Fishcanwalk/muscle-activity-analyzer/report/README.md

# รายงานโครงงาน Muscle Activity Analyzer

รายงานนี้จัดเรียงตาม [`structure.md`](structure.md) โดยแยกแต่ละข้อเป็นไฟล์ Markdown เพื่อให้อ่าน แก้ไข และนำไปจัดรูปเล่มได้ง่าย

## ขอบเขตข้อมูลที่ใช้

เนื้อหาในชุดรายงานนี้อ้างอิงจากแหล่งข้อมูลต่อไปนี้เท่านั้น

- `test-sensor/arduino/esp32_workout_firmware/`
- `test-sensor/arduino/uno_emg_fsr_link/`
- `backend/`
- `frontend/`
- `PINS.md`
- `README.md`
- `TROUBLESHOOTING.md`

## สารบัญไฟล์

### ส่วนต้น

1. [คำนำ](01-preface.md)
2. [บทคัดย่อ](02-abstract.md)
3. [สารบัญ](03-table-of-contents.md)
4. [สารบัญรูปและตาราง](04-list-of-figures-and-tables.md)

### บทที่ 1 บทนำ

1. [1.1 ที่มาและความสำคัญของปัญหา](chapter-01/chapter-01.md#11-ที่มาและความสำคัญของปัญหา)
2. [1.2 ปัญหาที่ต้องการแก้ไข](chapter-01/chapter-01.md#12-ปัญหาที่ต้องการแก้ไข)
3. [1.3 อุปกรณ์ทั้งหมดที่ใช้ในงาน](chapter-01/chapter-01.md#13-อุปกรณ์ทั้งหมดที่ใช้ในงาน)

### บทที่ 2 การออกแบบระบบ

1. [2.1 ภาพรวมสถาปัตยกรรมและองค์ประกอบของระบบ](chapter-02/chapter-02.md#21-ภาพรวมสถาปัตยกรรมและองค์ประกอบของระบบ)
2. [2.2 ลำดับขั้นตอนและการไหลของข้อมูล](chapter-02/chapter-02.md#22-ลำดับขั้นตอนและการไหลของข้อมูล)
3. [2.3 การออกแบบขั้นตอนประมวลผล](chapter-02/chapter-02.md#23-การออกแบบขั้นตอนประมวลผล)
4. [2.4 การออกแบบส่วนติดต่อผู้ใช้](chapter-02/chapter-02.md#24-การออกแบบส่วนติดต่อผู้ใช้)

### บทที่ 3 การพัฒนา

1. [3.1 ภาษา เครื่องมือ และสภาพแวดล้อมที่ใช้พัฒนา](chapter-03/chapter-03.md#31-ภาษา-เครื่องมือ-และสภาพแวดล้อมที่ใช้พัฒนา)
2. [3.2 โครงสร้างซอฟต์แวร์และหน้าที่ของส่วนประกอบหลัก](chapter-03/chapter-03.md#32-โครงสร้างซอฟต์แวร์และหน้าที่ของส่วนประกอบหลัก)
3. [3.3 การพัฒนาฟังก์ชันหลักและการเชื่อมต่อ](chapter-03/chapter-03.md#33-การพัฒนาฟังก์ชันหลักและการเชื่อมต่อระหว่างส่วนประกอบ)

### บทที่ 4 ข้อมูลจากเซนเซอร์

1. [4.1 กล้องและเซนเซอร์ที่ใช้](chapter-04/chapter-04.md#41-กล้องและเซนเซอร์ที่ใช้-ค่าที่อ่านโดยตรง-ช่วงค่า-และหน่วย)
2. [4.2 อัตราการอ่าน การปรับเทียบ และค่าที่คำนวณต่อ](chapter-04/chapter-04.md#42-อัตราการอ่าน-การปรับเทียบ-และค่าที่คำนวณต่อ)

### บทที่ 5 การจัดเก็บข้อมูลและการนำไปใช้

1. [5.1 ภาพรวมข้อมูลสด ข้อมูลที่บันทึก และความสัมพันธ์](chapter-05/chapter-05.md#51-ภาพรวมข้อมูลสด-ข้อมูลที่บันทึก-และความสัมพันธ์ของข้อมูล)
2. [5.2 Collections และฟิลด์สำคัญ](chapter-05/chapter-05.md#52-collections-และฟิลด์สำคัญ)
3. [5.3 วัตถุประสงค์ของข้อมูลและส่วนที่เรียกใช้](chapter-05/chapter-05.md#53-เก็บข้อมูลแต่ละประเภทเพื่อใช้ทำอะไร-และส่วนใดของระบบเรียกใช้จริง)
4. [5.4 ตัวอย่างเอกสาร ดัชนี การค้นคืน และอายุข้อมูล](chapter-05/chapter-05.md#54-ตัวอย่างเอกสาร-ดัชนี-การค้นคืน-และอายุข้อมูล)

### บทที่ 6 โครงสร้างและการทำงานของโค้ด

1. [6.1 แผนผัง codebase](chapter-06/chapter-06.md#61-แผนผัง-codebase-และหน้าที่ของเฟิร์มแวร์-เว็บ-และ-api)
2. [6.2 Arduino Uno](chapter-06/chapter-06.md#62-arduino-uno-timer1-adc-interrupt-watchdog-และ-uart)
3. [6.3 ESP32](chapter-06/chapter-06.md#63-esp32-freertos-hardware-timer-gpio-interrupt-watchdog-i2c-และการส่งข้อมูล)
4. [6.4 เว็บและเซิร์ฟเวอร์](chapter-06/chapter-06.md#64-เว็บและเซิร์ฟเวอร์-รับ-telemetry-กระจาย-sse-เริ่มหยุดบันทึก-ส่งต่อ-fastapi-และเก็บ-mongodb)
5. [6.5 เส้นทางข้อมูลแบบครบวงจรและตัวอย่างโค้ด](chapter-06/chapter-06.md#65-เส้นทางข้อมูลแบบครบวงจรและตัวอย่างโค้ดสำคัญ)

### บทที่ 7 การทดสอบและผลลัพธ์

1. [7.1 วัตถุประสงค์ วิธีการ และสภาพแวดล้อม](chapter-07/chapter-07.md#71-วัตถุประสงค์-วิธีการ-และสภาพแวดล้อมการทดสอบ)
2. [7.2 กรณีทดสอบและเกณฑ์ประเมินผล](chapter-07/chapter-07.md#72-กรณีทดสอบและเกณฑ์ประเมินผล)
3. [7.3 ผลการทดสอบและตัวอย่างผลลัพธ์](chapter-07/chapter-07.md#73-ผลการทดสอบและตัวอย่างผลลัพธ์)
4. [7.4 การวิเคราะห์ผลและข้อจำกัด](chapter-07/chapter-07.md#74-การวิเคราะห์ผลและข้อจำกัดที่พบ)

### บทที่ 8 ปัญหาที่พบและวิธีแก้ไข

1. [8.1 ปัญหาที่พบ](chapter-08/chapter-08.md#81-ปัญหาที่พบระหว่างการพัฒนาและการทดสอบ)
2. [8.2 สาเหตุและผลกระทบ](chapter-08/chapter-08.md#82-สาเหตุและผลกระทบของแต่ละปัญหา)
3. [8.3 วิธีแก้ไขและเหตุผล](chapter-08/chapter-08.md#83-วิธีที่ใช้แก้ไขและเหตุผลที่เลือกวิธีนั้น)
4. [8.4 ผลหลังแก้ไขและปัญหาที่ยังเหลือ](chapter-08/chapter-08.md#84-ผลหลังแก้ไขและปัญหาที่ยังเหลืออยู่)

### บทที่ 9 สรุปและแนวทางพัฒนา

1. [9.1 สรุปสิ่งที่พัฒนาและผลที่ได้](chapter-09/chapter-09.md#91-สรุปสิ่งที่พัฒนาและผลที่ได้เทียบกับวัตถุประสงค์)
2. [9.2 ข้อจำกัดของโครงงาน](chapter-09/chapter-09.md#92-ข้อจำกัดของโครงงาน)
3. [9.3 แนวทางพัฒนาต่อ](chapter-09/chapter-09.md#93-แนวทางพัฒนาต่อ)

### ส่วนท้าย

1. [เอกสารอ้างอิง](references.md)
2. [ภาคผนวก](appendix.md)

## Flowchart

แผนภาพ Mermaid สำหรับนำไปแคปภาพใส่รายงานอยู่ที่ [`flowchart.md`](flowchart.md) และมีจุดอ้างอิงในข้อ 2.2, 6.2, 6.3 และ 6.5

แผนภาพฐานข้อมูล (ER Diagram) ของ MongoDB collections อยู่ที่ [`db-diagram.md`](db-diagram.md) มีจุดอ้างอิงในข้อ 5.1 และ 5.2

## เอกสารอธิบายโค้ดรวม

คำอธิบาย firmware ทั้งสองไฟล์แบบรวมอยู่ที่ [`code-explanation.md`](code-explanation.md)
