Fishcanwalk/muscle-activity-analyzer/report/structure.md

# โครงสร้างรายงานพัฒนาซอฟต์แวร์

รายงานโครงงาน `muscle-activity-analyzer` ควรเรียงหัวข้อตามลำดับต่อไปนี้ โดยเติมรายละเอียดจากการพัฒนาและผลการทดสอบจริงในแต่ละส่วน

## ส่วนต้น

1. **คำนำ** — จุดประสงค์ของรายงานและภาพรวมเนื้อหา
2. **บทคัดย่อ** — ปัญหา วัตถุประสงค์ วิธีดำเนินงาน และผลลัพธ์โดยสรุป
3. **สารบัญ** — หัวข้อและเลขหน้า
4. **สารบัญรูปและตาราง** — หมายเลข ชื่อ และเลขหน้าของภาพกับตารางในรายงาน

## บทที่ 1 บทนำ

1.1 ที่มาและความสำคัญของปัญหา
1.2 ปัญหาที่ต้องการแก้ไข
1.3 อุปกรณ์ทั้งหมดที่ใช้ในงาน (Hardware, Software, Library)

## บทที่ 2 การออกแบบระบบ

2.1 ภาพรวมสถาปัตยกรรมและองค์ประกอบของระบบ
2.2 ลำดับขั้นตอนและการไหลของข้อมูล
2.3 การออกแบบขั้นตอนประมวลผล
2.4 การออกแบบส่วนติดต่อผู้ใช้

## บทที่ 3 การพัฒนา

3.1 ภาษา เครื่องมือ และสภาพแวดล้อมที่ใช้พัฒนา
3.2 โครงสร้างซอฟต์แวร์และหน้าที่ของส่วนประกอบหลัก
3.3 การพัฒนาฟังก์ชันหลักและการเชื่อมต่อระหว่างส่วนประกอบ

## บทที่ 4 ข้อมูลจากเซนเซอร์

4.1 กล้องและเซนเซอร์ที่ใช้: ค่าที่อ่านโดยตรง ช่วงค่า และหน่วย
4.2 อัตราการอ่าน การปรับเทียบ และค่าที่คำนวณต่อ

## บทที่ 5 การจัดเก็บข้อมูลและการนำไปใช้

5.1 ภาพรวมข้อมูลสด ข้อมูลที่บันทึก และความสัมพันธ์ของข้อมูล
5.2 Collections และฟิลด์สำคัญ
5.3 เก็บข้อมูลแต่ละประเภทเพื่อใช้ทำอะไร และส่วนใดของระบบเรียกใช้จริง
5.4 ตัวอย่างเอกสาร ดัชนี การค้นคืน และอายุข้อมูล

## บทที่ 6 โครงสร้างและการทำงานของโค้ด

6.1 แผนผัง codebase และหน้าที่ของเฟิร์มแวร์ เว็บ และ API
6.2 Arduino Uno: Timer1, ADC Interrupt, Wทที่ 3 การพัฒนา
3.1 ภาษา เครื่องมือ และสภาพแวดล้อมที่ใช้พัฒนา
3.2 โครงสร้างซอฟต์แวร์และหน้าที่ของส่วนประกอบหลัก
3.3 การพัฒนาฟังก์ชันหลักและการเชื่อมต่อระหว่างส่วนประกอบatchdog และ UART
6.3 ESP32: FreeRTOS, Hardware Timer, GPIO Interrupt, Watchdog, I2C และการส่งข้อมูล
6.4 เว็บและเซิร์ฟเวอร์: รับ telemetry, กระจายผ่าน WebSocket และ SSE, เริ่ม/หยุดบันทึก, ส่งต่อ FastAPI และเก็บ MongoDB
6.5 เส้นทางข้อมูลแบบครบวงจรและตัวอย่างโค้ดสำคัญ

## บทที่ 7 การทดสอบและผลลัพธ์

7.1 วัตถุประสงค์ วิธีการ และสภาพแวดล้อมการทดสอบ
7.2 กรณีทดสอบและเกณฑ์ประเมินผล
7.3 ผลการทดสอบและตัวอย่างผลลัพธ์
7.4 การวิเคราะห์ผลและข้อจำกัดที่พบ

## บทที่ 8 ปัญหาที่พบและวิธีแก้ไข

8.1 ปัญหาที่พบระหว่างการพัฒนาและการทดสอบ
8.2 สาเหตุและผลกระทบของแต่ละปัญหา
8.3 วิธีที่ใช้แก้ไขและเหตุผลที่เลือกวิธีนั้น
8.4 ผลหลังแก้ไขและปัญหาที่ยังเหลืออยู่

## บทที่ 9 สรุปและแนวทางพัฒนา

9.1 สรุปสิ่งที่พัฒนาและผลที่ได้เทียบกับวัตถุประสงค์
9.2 ข้อจำกัดของโครงงาน
9.3 แนวทางพัฒนาต่อ

## ส่วนท้าย

1. **เอกสารอ้างอิง** — แหล่งข้อมูล แนวคิด เครื่องมือ และงานที่อ้างถึงในรายงาน
2. **ภาคผนวก** — รายละเอียดเสริม เช่น คู่มือใช้งาน ตัวอย่างข้อมูล หรือผลการทดสอบเพิ่มเติม
