Fishcanwalk/muscle-activity-analyzer/report/04-list-of-figures-and-tables.md

# สารบัญรูปและตาราง

รายการนี้เป็นรายการตั้งต้นสำหรับการจัดรูปเล่มจริง เลขหน้าและหมายเลขรูปให้เติมหลังจากนำ Mermaid ไปสร้างภาพและรวมเอกสารแล้ว

## รูปที่ควรมี

| รายการ | ชื่อรูป | แหล่งข้อมูล | จุดแทรกแนะนำ |
|---|---|---|---|
| รูปที่ 1 | การไหลของข้อมูลจาก Uno ถึง MongoDB | `report/flowchart.md` Flowchart 1 | ข้อ 2.2 |
| รูปที่ 2 | รอบการอ่าน ADC ของ Arduino Uno | `report/flowchart.md` Flowchart 2 | ข้อ 6.2 |
| รูปที่ 3 | งานและการเชื่อมต่อของ ESP32 | `report/flowchart.md` Flowchart 3 | ข้อ 6.3 |
| รูปที่ 4 | หน้าจอแดชบอร์ดและสถานะเซนเซอร์ | `frontend/src/lib/components/workout/` | ข้อ 2.4 |

## ตารางที่ควรมี

| รายการ | ชื่อตาราง | จุดแทรกแนะนำ |
|---|---|---|
| ตารางที่ 1 | การกำหนดขาและอุปกรณ์ | ข้อ 4.1 |
| ตารางที่ 2 | สูตรคำนวณค่าเซนเซอร์ต่อ (EMG, FSR, MPU, HR, SpO2, อุณหภูมิ) | ข้อ 4.2 |
| ตารางที่ 3 | Collections และดัชนี MongoDB | ข้อ 5.2 และ 5.4 |
| ตารางที่ 4 | กรณีทดสอบระบบ | ข้อ 7.2 |
| ตารางที่ 5 | รายการอุปกรณ์และวัสดุ | ข้อ 3.1 |
