Fishcanwalk/muscle-activity-analyzer/report/chapter-06/chapter-06.md

# บทที่ 6 โครงสร้างและการทำงานของโค้ด

## 6.1 แผนผัง codebase และหน้าที่ของเฟิร์มแวร์ เว็บ และ API

```text
test-sensor/arduino/
├── uno_emg_fsr_link/              # Uno: ADC + Timer1 + UART
└── esp32_workout_firmware/        # ESP32: FreeRTOS + I2C + Wi-Fi + HTTP + WebSocket

frontend/
├── server.js                      # entry point ตอน production ต่อ WebSocket เข้ากับ SvelteKit
├── emg-ws.js                      # WebSocket server ของ EMG ที่ /ws/emg
└── src/
    ├── routes/api/                # endpoint รับ telemetry, SSE, recording, calibration
    ├── lib/server/telemetryStore.ts  # สถานะสด การแปลงค่า EMG และการส่งต่อ backend
    └── lib/workout/               # state ของ workout, telemetry, camera, recording

backend/app/
├── routers/                       # auth, telemetry, sessions, calibration, users
├── models/                        # schema ข้อมูล
├── db.py                          # MongoDB และ index
└── security.py                    # JWT และ password
```

ผังนี้เป็นสรุปหน้าที่ของส่วนประกอบหลัก ไม่ได้รวมไฟล์ที่อยู่นอกขอบเขตแหล่งข้อมูลของรายงาน

telemetry ที่ส่งต่อกันในผังนี้มีโครงสร้างหลักเป็นกลุ่ม `emg`, `fsr`, `mpu`, `vitals`, `device`, `timestamp` และอาจมี `buttons` โดย backend schema อนุญาตฟิลด์เพิ่มเติมเพื่อให้รองรับข้อมูลจากอุปกรณ์ได้ยืดหยุ่น ค่า EMG ดิบจากบอร์ดส่งแยกมาทาง WebSocket ส่วนกลุ่มอื่นส่งทาง HTTP POST แล้วเว็บเซิร์ฟเวอร์รวมกลับเป็น telemetry ก้อนเดียวก่อนส่งต่อ backend

## 6.2 Arduino Uno: Timer1, ADC Interrupt, Watchdog และ UART

### 6.2.1 ภาพรวมการทำงาน

**การจับเวลารอบ sampling:** ใช้ Timer1 ในโหมด CTC โดยตั้ง prescaler 64 และค่า OCR1A ให้เกิด interrupt ที่ความถี่ 100 Hz หรือทุก 10 ms ทุกครั้งที่เกิด `TIMER1_COMPA_vect` ระบบจะตั้งบิต 0 ของตัวแปร `eventFlags` เพื่อให้ loop เริ่มรอบอ่านข้อมูลใหม่ ทำให้รอบ sampling สม่ำเสมอ

**การอ่านค่า ADC ด้วย interrupt:** ในแต่ละรอบ Uno อ่านค่า 2 ช่อง คือ EMG ที่ขา A0 และ FSR ที่ขา A1 โดยสั่งให้ ADC เริ่มแปลงค่าแล้วไม่ต้องรอ เมื่อแปลงค่าเสร็จ ADC จะเรียก interrupt ให้เก็บค่าไว้ แล้วเริ่มอ่านช่องถัดไปต่อทันที เมื่ออ่านครบทั้ง 2 ช่อง โปรแกรมหลักจะนำค่าไปใช้ ส่วนค่า FSR ต้องกลับด้านก่อน เพราะเซนเซอร์ให้ค่าสูงตอนไม่มีแรงกด

**การประหยัดพลังงาน:** ช่วงที่รอ Timer1 หรือรอ ADC แปลงค่า CPU ไม่มีงานต้องทำ ระบบจึงให้ CPU พักด้วย `SLEEP_MODE_IDLE` และเมื่อเกิด interrupt จาก Timer1 หรือ ADC CPU จะตื่นขึ้นมาทำงานต่อ

**การป้องกันระบบค้าง:** ใช้ Watchdog Timer ของ Uno โดยตั้ง timeout ไว้ 2 วินาทีผ่านฟังก์ชันที่เขียนขึ้นเองระดับ register (`WDT__enable()`) ซึ่งให้ผลเหมือนฟังก์ชันสำเร็จรูปของไลบรารี AVR และเรียก `wdt_reset()` ทุกครั้งที่อ่านข้อมูลครบหนึ่งรอบ หากรอบการอ่านค้างนานเกิน 2 วินาที ระบบจะรีสตาร์ทบอร์ดโดยอัตโนมัติ

**การส่งข้อมูลไปยัง ESP32:** แปลงค่า ADC 10-bit (0-1023) เป็นช่วง 0-4095 ด้วย `map()` ให้ตรงกับช่วงค่าที่ ESP32 และ backend ใช้ แล้วส่งผ่าน `Serial` ที่ขา 0/1 ด้วยความเร็ว 9600 baud ในรูปแบบ `emg,fsr` บรรทัดละหนึ่งรอบ

### 6.2.2 โค้ดและการทำงานของโค้ด

โค้ดในหัวข้อนี้ยกมาจากไฟล์ `test-sensor/arduino/uno_emg_fsr_link/uno_emg_fsr_link.ino` โดยตรง บรรทัดที่ละไว้แสดงด้วย `// ...`

ATmega328P บน Arduino Uno มี RAM เพียง 2 KB ไม่พอสำหรับรัน FreeRTOS แบบฝั่ง ESP32 เฟิร์มแวร์ของ Uno จึงใช้กลไกของชิป AVR โดยตรงแทน แต่ยังคงใช้แนวคิดเดียวกัน คือใช้ hardware timer กำหนดจังหวะ ใช้ interrupt แทนการวนรอ ใช้ watchdog ป้องกันระบบค้าง และให้ CPU พักระหว่างรอ

#### 6.2.2.1 การเริ่มต้นระบบใน `setup()`

เมื่อเปิดเครื่อง `setup()` จะเตรียมส่วนต่าง ๆ ตามลำดับ โดยจัดการ watchdog ก่อน แล้วเปิดช่องทางส่งข้อมูล ตั้งค่า timer และ ADC จากนั้นเลือกโหมดพัก และเปิด watchdog เป็นขั้นสุดท้าย

```cpp
void setup() {
  MCUSR = 0;
  wdt_disable();

  Serial.begin(9600);
  setupSampleTimer();
  ADMUX = (1 << REFS0) | ADC_CHANNEL_EMG;
  ADCSRA = (1 << ADEN) | (1 << ADIE) | (1 << ADPS2) | (1 << ADPS1) | (1 << ADPS0);
  DIDR0 |= (1 << ADC0D) | (1 << ADC1D);

  set_sleep_mode(SLEEP_MODE_IDLE);

  WDT__enable(wdt_timeout_2sec);
}
```

ดูโค้ดต้นฉบับ: [`uno_emg_fsr_link.ino` บรรทัด 68–81](https://github.com/Fishcanwalk/muscle-activity-analyzer/blob/main/test-sensor/arduino/uno_emg_fsr_link/uno_emg_fsr_link.ino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)

ขั้นแรกระบบปิด watchdog ไว้ก่อนชั่วคราว เหตุผลอธิบายไว้ในหัวข้อ 6.2.2.5 ต่อมาจึงเปิด `Serial` ที่ความเร็ว 9600 baud เพื่อใช้ส่งข้อมูลไปยัง ESP32 แล้วตั้งค่า Timer1 (หัวข้อ 6.2.2.2) จากนั้นตั้งค่า ADC ต่อทันทีในบรรทัดถัดมา (หัวข้อ 6.2.2.3) โดยไม่ได้แยกเป็นฟังก์ชันต่างหาก ไฟล์นี้ไม่ได้รวม `board_config.h` เหมือนก่อนหน้านี้อีกต่อไป จึงไม่มีการเรียก `setupBoardAdc()` และประกาศ `ADC_MAX_VAL` (10-bit, ค่า 1023) ไว้เองในไฟล์แทนการดึงจากเฮดเดอร์ที่ใช้ร่วมกับบอร์ดอื่น

หลังจากนั้นระบบเลือกโหมดพักของ CPU ไว้ล่วงหน้า (หัวข้อ 6.2.2.4) และเปิด watchdog เป็นขั้นสุดท้าย เพราะเมื่อเปิดแล้วระบบต้องเริ่มรีเซ็ต watchdog เป็นระยะ ถ้าเปิดไว้ตั้งแต่ต้น ช่วงที่ยังตั้งค่าไม่เสร็จอาจทำให้บอร์ดถูกรีสตาร์ทโดยไม่จำเป็น

#### 6.2.2.2 การจับเวลารอบ sampling ด้วย Timer1

Uno ต้องอ่านค่าเซนเซอร์ให้ตรงทุก 10 ms (100 Hz) เท่ากับฝั่ง ESP32 ถ้าใช้ `delay()` หรือคอยเทียบเวลาจาก `millis()` CPU จะต้องตื่นอยู่ตลอดและรอบจะคลาดตามเวลาที่ใช้ทำงานในแต่ละรอบ ระบบจึงใช้ Timer1 ซึ่งเป็นวงจรนับเวลาในชิป และนับต่อไปได้เองแม้ CPU จะพักอยู่

```cpp
#define TIMER1_OCR1A_VALUE ((F_CPU / 64UL / SAMPLE_RATE_HZ) - 1)

void setupSampleTimer() {
  cli();
  TCCR1A = 0;
  TCCR1B = 0;
  TCNT1 = 0;
  OCR1A = TIMER1_OCR1A_VALUE;
  TCCR1B |= (1 << WGM12);
  TCCR1B |= (1 << CS11) | (1 << CS10);
  TIMSK1 |= (1 << OCIE1A);
  sei();
}

ISR(TIMER1_COMPA_vect) {
  eventFlags |= (1 << 0);
}
```

ดูโค้ดต้นฉบับ: [`uno_emg_fsr_link.ino` บรรทัด 18–34](https://github.com/Fishcanwalk/muscle-activity-analyzer/blob/main/test-sensor/arduino/uno_emg_fsr_link/uno_emg_fsr_link.ino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)

ชิปทำงานที่ 16 MHz ซึ่งเร็วเกินกว่าจะนำมานับตรง ๆ จึงหารความถี่ด้วย 64 (prescaler) ก่อน timer จึงนับขึ้นหนึ่งครั้งทุก 4 µs เมื่อนับครบ 2,500 ครั้งก็จะได้ 10 ms พอดี ค่าที่ตั้งไว้คือ 2,499 เพราะ timer เริ่มนับจาก 0

timer ทำงานในโหมด CTC เมื่อนับถึงค่าที่ตั้งไว้ จะเกิด interrupt แล้วกลับไปเริ่มนับจาก 0 ใหม่เองทันที รอบถัดไปจึงเริ่มตรงเวลาเสมอ โดยไม่ต้องมีโปรแกรมมาตั้งค่าใหม่ ระหว่างตั้งค่า timer ระบบปิด interrupt ไว้ชั่วคราว (`cli()` / `sei()`) เพื่อไม่ให้ interrupt เกิดขึ้นขณะที่ตั้งค่ายังไม่ครบ

เมื่อเกิด interrupt ฟังก์ชันที่รับ interrupt ทำเพียงอย่างเดียว คือ "ยกธง" บอกโปรแกรมหลักว่าถึงรอบแล้ว ส่วนงานอ่านค่าจริงจะทำใน `loop()` เพราะงานใน interrupt ต้องสั้นที่สุด ธงที่ใช้สื่อสารระหว่าง interrupt กับโปรแกรมหลักเก็บรวมไว้ในตัวแปรเดียว แต่ละบิตแทนเหตุการณ์หนึ่งอย่าง

```cpp
volatile uint8_t eventFlags = 0;
```

ดูโค้ดต้นฉบับ: [`uno_emg_fsr_link.ino` บรรทัด 6](https://github.com/Fishcanwalk/muscle-activity-analyzer/blob/main/test-sensor/arduino/uno_emg_fsr_link/uno_emg_fsr_link.ino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)

โค้ดนี้ไม่ได้ตั้งชื่อบิตแต่ละตัวไว้เป็นค่าคงที่ แต่ใช้ตัวเลขบิตตรง ๆ คือ บิต 0 (`1 << 0`) หมายถึง timer ครบรอบ บิต 1 (`1 << 1`) หมายถึง EMG แปลงค่าเสร็จ และบิต 2 (`1 << 2`) หมายถึง FSR แปลงค่าเสร็จ interrupt เป็นฝ่ายยกธงด้วยการ OR บิตที่เกี่ยวข้องเข้าไปในตัวแปร และ `loop()` เป็นฝ่ายเอาธงลงด้วยการ AND กับส่วนกลับบิตนั้นเมื่อจัดการเหตุการณ์นั้นเสร็จแล้ว ตัวแปรนี้ประกาศเป็น `volatile` เพื่อบอกคอมไพเลอร์ว่าค่าอาจถูกเปลี่ยนจาก interrupt ได้ทุกเมื่อ โปรแกรมจึงต้องอ่านค่าจริงจากหน่วยความจำทุกครั้ง ไม่ใช้ค่าเก่าที่จำไว้

#### 6.2.2.3 การอ่านค่า ADC ด้วย Interrupt

ถ้าใช้ `analogRead()` CPU ต้องรอ ADC แปลงค่าจนเสร็จ ซึ่งใช้เวลาประมาณ 104 µs ต่อช่อง โดยตลอดเวลานั้น CPU ต้องตื่นอยู่และทำอย่างอื่นไม่ได้ ระบบจึงใช้วิธีสั่งให้ ADC เริ่มแปลงค่าแล้วปล่อยไว้ เมื่อแปลงเสร็จ ADC จะแจ้งกลับมาเองด้วย interrupt

```cpp
ADMUX = (1 << REFS0) | ADC_CHANNEL_EMG;
ADCSRA = (1 << ADEN) | (1 << ADIE) | (1 << ADPS2) | (1 << ADPS1) | (1 << ADPS0);
DIDR0 |= (1 << ADC0D) | (1 << ADC1D);
```

ดูโค้ดต้นฉบับ: [`uno_emg_fsr_link.ino` บรรทัด 74–76](https://github.com/Fishcanwalk/muscle-activity-analyzer/blob/main/test-sensor/arduino/uno_emg_fsr_link/uno_emg_fsr_link.ino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)

```cpp
ISR(ADC_vect) {
  int value = ADC;
  if (currentAdcChannel == ADC_CHANNEL_EMG) {
    emgRawIsr = value;
    eventFlags |= (1 << 1);
    currentAdcChannel = ADC_CHANNEL_FSR;
    ADMUX = (ADMUX & 0xF0) | (ADC_CHANNEL_FSR & 0x0F);
    ADCSRA |= (1 << ADSC);
  } else {
    fsrRawIsr = value;
    eventFlags |= (1 << 2);
  }
}
```

ดูโค้ดต้นฉบับ: [`uno_emg_fsr_link.ino` บรรทัด 37–49](https://github.com/Fishcanwalk/muscle-activity-analyzer/blob/main/test-sensor/arduino/uno_emg_fsr_link/uno_emg_fsr_link.ino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)

- ตอนตั้งค่า ADC ระบบใช้แรงดัน 5 V ของบอร์ดเป็นแรงดันอ้างอิง ค่าที่อ่านได้จึงอยู่ในช่วง 0–1023 ตามแรงดัน 0–5 V และเปิดให้ ADC แจ้ง interrupt เมื่อแปลงค่าเสร็จ ส่วนสัญญาณนาฬิกาของ ADC ลดลงเหลือประมาณ 125 kHz ซึ่งอยู่ในช่วงที่ ADC แปลงค่าได้แม่นยำ
- ขา A0 และ A1 ใช้อ่านสัญญาณแอนะล็อกเท่านั้น ระบบจึงปิดวงจรอ่านค่าดิจิทัลของสองขานี้ไว้ เพื่อลดสัญญาณรบกวนและลดการใช้ไฟ
- ADC มีตัวเดียว แต่ต้องอ่าน 2 ช่อง ระบบจึงอ่านต่อกันเป็นทอด ๆ เริ่มจาก EMG ที่ขา A0 เมื่อแปลงเสร็จ interrupt จะเก็บค่าไว้ ยกธงบิต 1 ว่า EMG พร้อมแล้ว แล้วเปลี่ยนช่องที่จะอ่านเป็น FSR ด้วยการเขียน `ADMUX` ใหม่ และสั่งเริ่มแปลงค่าอีกครั้งด้วยการตั้งบิต `ADSC` ตรง ๆ ในบรรทัดถัดมา เมื่อ FSR แปลงเสร็จก็จะยกธงบิต 2 ว่า FSR พร้อมแล้ว ธงนี้หมายความว่าได้ค่าครบทั้งสองช่องของรอบนั้นแล้ว
- interrupt ต้องรู้ว่าค่าที่เพิ่งแปลงเสร็จเป็นของช่องใด ระบบจึงจดช่องที่กำลังอ่านไว้ในตัวแปร `currentAdcChannel` ทุกครั้งที่เปลี่ยนช่อง
- โค้ดนี้ไม่มีฟังก์ชันช่วยรวมการตั้งช่องกับการสั่งเริ่มแปลงค่าไว้ด้วยกัน (เช่น `startAdcConversion()`) การเขียน `currentAdcChannel`, `ADMUX` และบิต `ADSC` จึงเกิดขึ้นตรง ๆ ทั้งใน ISR นี้ และใน `loop()` (หัวข้อ 6.2.2.4) แยกกันคนละที่ ทำให้เห็นการเข้าถึง register ระดับล่างชัดเจนขึ้น แต่ต้องเขียนโค้ดชุดเดียวกันซ้ำสองจุด

#### 6.2.2.4 รอบการทำงานใน `loop()` และการประหยัดพลังงาน

`loop()` เป็นตัวกำหนดลำดับงานในแต่ละรอบ ช่วงที่ต้องรอ timer หรือรอ ADC แปลงค่า CPU จะพักอยู่ตลอด และตื่นขึ้นมาเฉพาะเมื่อมีงานต้องทำ

```cpp
void loop() {
  sleep_mode();

  if (!(eventFlags & (1 << 0))) return;
  eventFlags &= ~(1 << 0);

  currentAdcChannel = ADC_CHANNEL_EMG;
  ADMUX = (ADMUX & 0xF0) | (ADC_CHANNEL_EMG & 0x0F);
  ADCSRA |= (1 << ADSC);

  while (!(eventFlags & (1 << 2))) sleep_mode();
  eventFlags &= ~((1 << 1) | (1 << 2));

  cli();
  int emgRaw = emgRawIsr;
  int fsrRaw = fsrRawIsr;
  sei();
  // ...
}
```

ดูโค้ดต้นฉบับ: [`uno_emg_fsr_link.ino` บรรทัด 83–99](https://github.com/Fishcanwalk/muscle-activity-analyzer/blob/main/test-sensor/arduino/uno_emg_fsr_link/uno_emg_fsr_link.ino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)

1. ต้นรอบ CPU จะพักจนกว่าจะมี interrupt ใดก็ตามเกิดขึ้น
2. เมื่อตื่นขึ้น โปรแกรมจะตรวจก่อนว่าบิตของ timer (บิต 0) ถูกยกหรือไม่ เพราะ interrupt อื่นก็ปลุก CPU ได้เช่นกัน ถ้ายังไม่ถึงรอบก็กลับไปพักต่อ ถ้าถึงรอบแล้วจึงเอาบิตลงและเริ่มทำงาน
3. โปรแกรมตั้งช่อง ADC เป็น EMG และสั่งเริ่มแปลงค่าเองตรง ๆ (เขียน `currentAdcChannel`, `ADMUX` และบิต `ADSC`) แล้วพักรอต่อ ระหว่างนั้น interrupt ของ ADC จะอ่าน EMG แล้วต่อด้วย FSR เอง (หัวข้อ 6.2.2.3) CPU จะตื่นขึ้นมาตรวจทุกครั้งที่มี interrupt จนกว่าจะเห็นบิต FSR (บิต 2) พร้อมแล้ว
4. เมื่อได้ค่าครบ โปรแกรมคัดลอกค่าจากตัวแปรที่ interrupt เขียนไว้มาใช้ ระหว่างคัดลอกจะปิด interrupt ไว้ชั่วครู่ เพราะ Uno เป็นชิป 8 บิต การอ่านค่า 16 บิตต้องทำเป็น 2 ครั้ง ถ้า interrupt แทรกเข้ามาเปลี่ยนค่าระหว่างสองครั้งนั้น ค่าที่ได้จะผิด

โหมดพักที่เลือกไว้ใน `setup()` คือ `SLEEP_MODE_IDLE` ซึ่งเป็นโหมดที่ตื้นที่สุด โหมดนี้หยุดเฉพาะ CPU แต่ Timer1, ADC และ Serial ยังทำงานต่อได้และปลุก CPU ได้ ระบบไม่เลือกโหมดที่ลึกกว่านี้ เพราะโหมดเหล่านั้นจะหยุด timer และ ADC ซึ่งเฟิร์มแวร์ต้องใช้ ข้อดีอีกข้อของการพักขณะ ADC แปลงค่าคือสัญญาณรบกวนจากวงจรดิจิทัลลดลง ค่าที่อ่านได้จึงนิ่งขึ้น

#### 6.2.2.5 การป้องกันระบบค้างด้วย Watchdog Timer

watchdog ของ Uno ทำงานแบบเดียวกับฝั่ง ESP32 คือเป็นตัวจับเวลาที่โปรแกรมต้องรีเซ็ตเป็นระยะ ถ้าไม่ถูกรีเซ็ตจนหมดเวลา แสดงว่าโปรแกรมค้าง ชิปจะรีสตาร์ทตัวเอง

```cpp
MCUSR = 0;
wdt_disable();
// ...
WDT__enable(wdt_timeout_2sec);
```

ดูโค้ดต้นฉบับ: [`uno_emg_fsr_link.ino` บรรทัด 69–70, 80](https://github.com/Fishcanwalk/muscle-activity-analyzer/blob/main/test-sensor/arduino/uno_emg_fsr_link/uno_emg_fsr_link.ino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)

ต้น `setup()` ระบบล้างบันทึกสาเหตุการรีเซ็ตครั้งก่อน และปิด watchdog ไว้ก่อน เพราะถ้าบอร์ดเพิ่งถูกรีสตาร์ทจาก watchdog ชิปจะยังจำสถานะนั้นไว้ และ bootloader รุ่นเก่าบางรุ่นไม่ได้ล้างสถานะนี้ให้ ถ้าไม่จัดการเอง watchdog อาจทำงานต่อระหว่างที่บอร์ดกำลังเริ่มระบบ และรีสตาร์ทบอร์ดวนซ้ำไม่จบ

ต่างจากฝั่ง ESP32 ที่เรียกใช้ watchdog ผ่านฟังก์ชันสำเร็จรูปของไลบรารี โค้ดฝั่ง Uno เขียนฟังก์ชันเปิด watchdog เองชื่อ `WDT__enable()` ซึ่งเขียนค่าลง register ของชิปโดยตรง แทนการเรียก `wdt_enable(WDTO_2S)` ของไลบรารี AVR

```cpp
#define wdt_timeout_2sec 7

void WDT__enable(uint8_t timeout_v) {
  unsigned char bakSREG;
  uint8_t prescaler;
  prescaler = timeout_v & 0x07;
  prescaler |= (1 << WDE);
  if (timeout_v > 7) {
    prescaler |= (1 << WDP3);
  }
  bakSREG = SREG;
  cli();
  wdt_reset();
  WDTCSR |= ((1 << WDCE) | (1 << WDE));
  WDTCSR = prescaler;
  SREG = bakSREG;
}
```

ดูโค้ดต้นฉบับ: [`uno_emg_fsr_link.ino` บรรทัด 17, 52–66](https://github.com/Fishcanwalk/muscle-activity-analyzer/blob/main/test-sensor/arduino/uno_emg_fsr_link/uno_emg_fsr_link.ino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)

1. คำนวณค่า prescaler จากค่าที่ส่งเข้ามา (`timeout_v & 0x07`) แล้วตั้งบิต `WDE` (Watchdog Enable) เพิ่มเข้าไป ถ้าค่าที่ส่งมากกว่า 7 จะตั้งบิต `WDP3` เพิ่มด้วย สำหรับ timeout ที่นานกว่า 2 วินาที ค่าคงที่ `wdt_timeout_2sec` ที่ประกาศไว้เท่ากับ 7 ซึ่งตรงกับค่า `WDTO_2S` ของไลบรารี AVR พอดี ผลลัพธ์คือ timeout 2 วินาทีเท่าเดิม
2. เก็บค่า `SREG` (สถานะ interrupt) ไว้ก่อน แล้วปิด interrupt ชั่วคราวด้วย `cli()` เพราะการตั้งค่า watchdog ต้องทำติดกันโดยไม่ให้ interrupt แทรก
3. รีเซ็ต watchdog หนึ่งครั้งก่อนตั้งค่าใหม่ เพื่อไม่ให้ timeout เดิมหมดเวลาพอดีตอนกำลังตั้งค่า
4. เขียน `WDTCSR` สองครั้งตามลำดับที่ชิป AVR กำหนด ครั้งแรกตั้งบิต `WDCE` และ `WDE` เพื่อปลดล็อกการเปลี่ยนค่า (ชิปกำหนดว่าไบต์นี้ต้องเขียนสองครั้งภายใน 4 clock cycle มิฉะนั้นการเปลี่ยนค่าจะไม่มีผล) ครั้งที่สองจึงเขียนค่า prescaler ที่คำนวณไว้ลงไปจริง
5. คืนค่า `SREG` เดิม เพื่อให้สถานะ interrupt กลับมาเหมือนก่อนเรียกฟังก์ชัน

เมื่อตั้งค่าส่วนอื่นเสร็จ ระบบจึงเรียก `WDT__enable(wdt_timeout_2sec)` ซึ่งให้ผลเหมือนกับ `wdt_enable(WDTO_2S)` ทุกประการ แล้วรีเซ็ต watchdog หนึ่งครั้งที่ท้าย `loop()` ทุกครั้งที่อ่านและส่งข้อมูลครบหนึ่งรอบ

```cpp
wdt_reset();
```

ดูโค้ดต้นฉบับ: [`uno_emg_fsr_link.ino` บรรทัด 109](https://github.com/Fishcanwalk/muscle-activity-analyzer/blob/main/test-sensor/arduino/uno_emg_fsr_link/uno_emg_fsr_link.ino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)

ปกติหนึ่งรอบใช้เวลาประมาณ 10 ms เวลา 2 วินาทีจึงเผื่อไว้มาก watchdog จะทำงานเฉพาะเมื่อมีปัญหาจริง เช่น ADC ไม่แจ้งว่าแปลงเสร็จจนโปรแกรมรอธงอยู่ตลอดไป หรือ timer หยุดทำงาน

#### 6.2.2.6 การแปลงค่าและส่งข้อมูลไปยัง ESP32

ก่อนส่งข้อมูล Uno ต้องปรับค่าให้อยู่ในรูปแบบที่ ESP32 และ backend ใช้

```cpp
int fsrInverted = ADC_MAX_VAL - fsrRaw;
int emgScaled = map(emgRaw, 0, ADC_MAX_VAL, 0, 4095);
int fsrScaled = map(fsrInverted, 0, ADC_MAX_VAL, 0, 4095);

Serial.print(emgScaled);
Serial.print(',');
Serial.println(fsrScaled);
```

ดูโค้ดต้นฉบับ: [`uno_emg_fsr_link.ino` บรรทัด 101–107](https://github.com/Fishcanwalk/muscle-activity-analyzer/blob/main/test-sensor/arduino/uno_emg_fsr_link/uno_emg_fsr_link.ino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)

- วงจร FSR ให้ค่าสูงเมื่อไม่มีแรงกด และค่าจะลดลงเมื่อกดแรงขึ้น ซึ่งกลับด้านกับความหมายที่ต้องการ ระบบจึงกลับค่าก่อน ให้ค่ามากหมายถึงแรงกดมาก
- ADC ของ Uno ให้ค่า 10 บิต (0–1023) แต่ฝั่ง ESP32 และ backend ออกแบบไว้สำหรับค่า 12 บิต (0–4095) ระบบจึงขยายช่วงค่าให้ตรงกัน เพื่อให้ส่วนอื่นของระบบใช้ค่าได้โดยไม่ต้องรู้ว่าข้อมูลมาจากบอร์ดใด
- ค่าทั้งสองถูกส่งออกเป็นข้อความหนึ่งบรรทัดต่อหนึ่งรอบ คั่นด้วยเครื่องหมายจุลภาค เช่น `2048,1820` ตามด้วยตัวขึ้นบรรทัดใหม่ ฝั่ง ESP32 ใช้ตัวขึ้นบรรทัดใหม่นี้เป็นจุดแบ่งข้อความแต่ละรอบ (หัวข้อ 6.3.2.4)

ข้อมูลถูกส่งผ่าน `Serial` ที่ขา 0/1 ซึ่งเป็นขาเดียวกับที่ใช้ต่อ USB จึงไม่ควรต่อ USB และ ESP32 พร้อมกัน นอกจากนี้ Uno ทำงานที่ 5 V แต่ขาของ ESP32 รับได้เพียง 3.3 V สายที่ส่งจาก Uno ไป ESP32 จึงต้องผ่านวงจรแบ่งแรงดันก่อน (ดู `PINS.md`)

ใช้ [`../flowchart.md`](../flowchart.md) Flowchart 2 เป็นรูปประกอบหัวข้อนี้

## 6.3 ESP32: FreeRTOS, Hardware Timer, GPIO Interrupt, Watchdog, I2C และการส่งข้อมูล

### 6.3.1 ภาพรวมการทำงาน

**การแบ่งงานเป็น Task:** ESP32 แบ่งงานออกเป็น 5 Task ที่ทำงานพร้อมกัน ได้แก่

- `SensorTask`: อ่านข้อมูลเซนเซอร์ถี่ที่สุดเพื่อให้ได้ข้อมูลต่อเนื่อง
- `EmgStreamTask`: ส่งค่า EMG ผ่าน WebSocket ไปยังเว็บไซต์ทุก 20 ms
- `NetworkTask`: ส่งข้อมูลเซนเซอร์อื่นและปุ่มผ่าน HTTP ไปยังเว็บไซต์ทุก 100 ms
- `LcdTask`: อัปเดตข้อมูลบนจอ LCD ทุก 200 ms
- `ControlTask`: รับเหตุการณ์จากปุ่มกดและจัดการสถานะการฝึก

**การจับเวลารอบ sampling:** ใช้ Timer สร้างสัญญาณที่ความถี่ 100 Hz ทุกครั้งที่ timer ทำงาน ระบบจะให้ semaphore เพื่อปลุก SensorTask ให้อ่านข้อมูลหนึ่งรอบ ทำให้รอบ sampling สม่ำเสมอ

**การรับสัญญาณจากปุ่ม:** ปุ่ม A และปุ่ม B ทำงานแบบ interrupt เมื่อกดปุ่มจะใช้ตัวจับเวลาระดับไมโครวินาทีทำ debounce 250 ms แล้วส่งค่าเข้าคิวของ ControlTask สำหรับดึงค่ามาเปลี่ยนสถานะการฝึก และส่งสถานะใหม่ไปยังเว็บไซต์ในรอบถัดไป นอกจากนี้ ปุ่ม A ยังใช้ปลุก ESP32 ให้ตื่นจาก Sleep Mode

**การป้องกันระบบค้าง:** ใช้ Watchdog Timer ของ ESP32 โดยตั้ง timeout ไว้ 8 วินาที และลงทะเบียน task หลักทุกตัวไว้กับ watchdog แต่ละ task จะเรียก `esp_task_wdt_reset()` ทุกรอบการทำงาน หาก task ใดไม่ตอบสนองนานเกิน 8 วินาที ระบบจะรีสตาร์ทบอร์ดโดยอัตโนมัติ

**การใช้ I2C bus ร่วมกัน:** เซนเซอร์ MPU, MAX30102, MLX90614 และจอ LCD ต่ออยู่บน I2C bus เดียวกัน เนื่องจาก bus นี้สื่อสารได้ทีละอุปกรณ์ จึงใช้ mutex ควบคุมไม่ให้หลาย task เข้าใช้ bus พร้อมกัน ซึ่งช่วยป้องกันข้อมูลชนกันและ bus ค้าง

**การรับข้อมูลจาก Arduino Uno:** ESP32 รับค่า EMG และ FSR จาก Arduino Uno ผ่าน `Serial2` ที่ขา GPIO16/17 ด้วยความเร็ว 9600 baud

**การส่งข้อมูลขึ้นเว็บไซต์:** ใช้ 2 ช่องทาง EMG เป็นสัญญาณที่เปลี่ยนเร็วและต้องเห็นแบบเรียลไทม์ EmgStreamTask จึงเปิดการเชื่อมต่อ WebSocket ค้างไว้และส่งค่า EMG ทุก 20 ms ส่วน NetworkTask นำค่า FSR และข้อมูลจากเซนเซอร์อื่นมารวมเป็น JSON ทุก 100 ms แล้วส่งด้วย HTTP POST ซึ่งคำตอบของ POST ใช้ส่งคำสั่งจากเว็บกลับมาที่บอร์ดด้วย

**การประหยัดพลังงาน:** เมื่อไม่มีการใช้งานนานครบ 5 นาที ESP32 จะเข้าสู่ Light Sleep และตื่นขึ้นมาทำงานต่อเมื่อกดปุ่ม A

### 6.3.2 โค้ดและการทำงานของโค้ด

โค้ดในหัวข้อนี้ยกมาจากไฟล์ `test-sensor/arduino/esp32_workout_firmware/esp32_workout_firmware.ino` โดยตรง บรรทัดที่ละไว้แสดงด้วย `// ...`

#### 6.3.2.1 การเริ่มต้นระบบใน `setup()`

เมื่อเปิดเครื่อง ESP32 ต้องเตรียมส่วนต่าง ๆ ให้พร้อมก่อนเริ่มทำงานจริง โดยเปิดช่องทางสื่อสารก่อน แสดงข้อความบนจอ แล้วจึงเริ่มเซนเซอร์ทีละตัว

```cpp
Serial2.begin(UNO_LINK_BAUD, SERIAL_8N1, UNO_LINK_RX_PIN, UNO_LINK_TX_PIN);
Wire.begin(I2C_SDA_PIN, I2C_SCL_PIN);
Wire.setClock(100000);

lcd.init();
lcd.backlight();
lcd.setCursor(0, 0);
lcd.print("Booting...");

for (int attempt = 0; attempt < 5 && !statusMpu; attempt++) {
  if (attempt > 0) delay(100);
  statusMpu = mpuBegin();
}
```

ดูโค้ดต้นฉบับ: [`esp32_workout_firmware.ino` บรรทัด 916–928](https://github.com/Fishcanwalk/muscle-activity-analyzer/blob/b1adde5/test-sensor/arduino/esp32_workout_firmware/esp32_workout_firmware.ino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)

ESP32 ใช้ช่องทางสื่อสาร 2 ช่อง ช่องแรกคือ UART สำหรับรับค่า EMG และ FSR จาก Arduino Uno (ขา GPIO16/17 ความเร็ว 9600 baud) ช่องที่สองคือ I2C bus (ขา SDA = GPIO21, SCL = GPIO22 ความเร็ว 100 kHz) ซึ่งเซนเซอร์ทั้งสามตัวและจอ LCD ใช้ร่วมกัน เมื่อเปิด I2C แล้ว จอ LCD จะขึ้นข้อความ `Booting...` ให้ผู้ใช้รู้ว่าเครื่องกำลังเริ่มระบบ

ตอนเพิ่งจ่ายไฟ เซนเซอร์บน I2C อาจยังไม่พร้อมตอบสนองทันที การสั่งเริ่มต้นเพียงครั้งเดียวจึงอาจล้มเหลวทั้งที่เซนเซอร์ไม่ได้เสีย เฟิร์มแวร์จึงลองเริ่มต้นเซนเซอร์แต่ละตัว (MPU, MAX30102, MLX90614) ซ้ำได้หลายครั้ง โดยเว้นช่วงให้เซนเซอร์ตั้งตัวครั้งละประมาณ 100 ms และหยุดลองทันทีที่เซนเซอร์ตอบกลับ หากลองครบ 5 ครั้งแล้วยังไม่สำเร็จ ระบบจะถือว่าเซนเซอร์ตัวนั้นใช้งานไม่ได้

ระบบจะจำไว้ว่าเซนเซอร์ตัวใดพร้อมใช้งาน และในขั้นตอนอ่านค่า (หัวข้อ 6.3.2.5) จะอ่านเฉพาะเซนเซอร์ที่พร้อมเท่านั้น ดังนั้นถ้าเซนเซอร์ตัวใดหลุดหรือต่อสายไม่แน่น ระบบทั้งหมดจะไม่ค้าง ส่วนอื่นยังทำงานได้ตามปกติ เพียงแต่ค่าที่มาจากเซนเซอร์ตัวนั้นจะคงเป็น 0

จากนั้นจึงเชื่อมต่อ Wi-Fi และสร้างเครื่องมือของ FreeRTOS ที่ task ต่าง ๆ ใช้ประสานงานกัน เครื่องมือเหล่านี้ต้องสร้างไว้ก่อนสร้าง task เพราะ task เริ่มทำงานทันทีที่ถูกสร้างและต้องใช้เครื่องมือเหล่านี้ตั้งแต่รอบแรก

```cpp
stateMutex = xSemaphoreCreateMutex();
i2cMutex = xSemaphoreCreateMutex();
sampleTickSemaphore = xSemaphoreCreateBinary();
emgQueue = xQueueCreate(EMG_QUEUE_LEN, sizeof(int));
buttonEventQueue = xQueueCreate(8, sizeof(uint8_t));
```

ดูโค้ดต้นฉบับ: [`esp32_workout_firmware.ino` บรรทัด 967–971](https://github.com/Fishcanwalk/muscle-activity-analyzer/blob/b1adde5/test-sensor/arduino/esp32_workout_firmware/esp32_workout_firmware.ino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)

เครื่องมือเหล่านี้แบ่งเป็น 2 กลุ่ม กลุ่มแรกคือ mutex ใช้เป็น "กุญแจ" ของสิ่งที่หลาย task ใช้ร่วมกัน task ที่ถือกุญแจอยู่เท่านั้นจึงจะเข้าใช้ได้ ส่วนกลุ่มที่สองคือ semaphore และ queue ใช้ส่งสัญญาณหรือส่งข้อมูลจากส่วนหนึ่งของโปรแกรมไปยังอีกส่วน

| เครื่องมือ | ชนิด | ใช้ทำอะไร |
| --- | --- | --- |
| `stateMutex` | Mutex | กุญแจของข้อมูลกลาง`SharedState` ไม่ให้ task หนึ่งอ่านขณะที่อีก task กำลังเขียน |
| `i2cMutex` | Mutex | กุญแจของ I2C bus ให้ใช้ได้ทีละ task |
| `sampleTickSemaphore` | Binary semaphore  | สัญญาณจาก hardware timer ที่ปลุก SensorTask ทุก 10 ms |
| `emgQueue` | Queue 64 ช่อง | ที่พักค่า EMG ทุกตัวอย่าง รอ EmgStreamTask มาเก็บไปส่งเป็นชุด |
| `buttonEventQueue` | Queue 8 ช่อง  | ส่งหมายเลขปุ่มที่ถูกกดจาก interrupt ไปให้ ControlTask |

#### 6.3.2.2 การแบ่งงานเป็น Task

งานของ ESP32 แต่ละอย่างมีจังหวะเวลาต่างกัน การอ่านเซนเซอร์ต้องตรงทุก 10 ms แต่การส่ง HTTP อาจต้องรอเซิร์ฟเวอร์ตอบนานหลายร้อยมิลลิวินาที ถ้าเขียนทุกอย่างรวมไว้ในลูปเดียว การรอเครือข่ายจะทำให้การอ่านเซนเซอร์ช้าตามไปด้วย จึงแยกงานออกเป็น 5 task ที่มีลูปของตัวเอง และให้ FreeRTOS สลับเวลา CPU ให้แต่ละ task ตามความสำคัญ

```cpp
xTaskCreatePinnedToCore(sensorTask, "SensorTask", 4096, nullptr, 3, &sensorTaskHandle, 1);
xTaskCreatePinnedToCore(networkTask, "NetworkTask", 8192, nullptr, 2, &networkTaskHandle, 0);
xTaskCreatePinnedToCore(lcdTask, "LcdTask", 2560, nullptr, 1, &lcdTaskHandle, 1);
xTaskCreatePinnedToCore(controlTask, "ControlTask", 2560, nullptr, 2, &controlTaskHandle, 1);
xTaskCreatePinnedToCore(emgStreamTask, "EmgStreamTask", 6144, nullptr, 3, &emgStreamTaskHandle, 0);
```

ดูโค้ดต้นฉบับ: [`esp32_workout_firmware.ino` บรรทัด 994–998](https://github.com/Fishcanwalk/muscle-activity-analyzer/blob/b1adde5/test-sensor/arduino/esp32_workout_firmware/esp32_workout_firmware.ino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)

| Task | Stack (byte) | Priority | Core | หน้าที่ |
| --- | --- | --- | ---- | --- |
| `SensorTask` | 4096 | 3 (สูงสุด) | 1 | อ่านเซนเซอร์ทุก 10 ms ตาม hardware timer |
| `EmgStreamTask` | 6144 | 3 | 0 | ส่งค่า EMG ผ่าน WebSocket ทุก 20 ms |
| `NetworkTask` | 8192 | 2 | 0 | สร้าง JSON ของเซนเซอร์อื่นและส่ง HTTP POST ทุก 100 ms |
| `LcdTask` | 2560 | 1 (ต่ำสุด) | 1 | อัปเดตจอ LCD ทุก 200 ms |
| `ControlTask` | 2560 | 2 | 1 | รับเหตุการณ์ปุ่ม ควบคุม buzzer และเข้า light sleep |

SensorTask ได้ priority สูงสุด เมื่อถึงรอบอ่านเซนเซอร์ FreeRTOS จะหยุด task อื่นบน core เดียวกันไว้ก่อนแล้วให้ SensorTask ทำงานทันที ส่วน LcdTask ได้ priority ต่ำสุด เพราะถ้าจออัปเดตช้าไปเล็กน้อยผู้ใช้ก็แทบไม่สังเกตเห็น EmgStreamTask ได้ priority สูงกว่า NetworkTask เพราะอยู่ core เดียวกัน ถ้า NetworkTask กำลังสร้าง JSON หรือรอคำตอบของ POST อยู่ EmgStreamTask จะแทรกเข้าไปส่ง EMG ได้ทันที กราฟ EMG บนเว็บจึงไม่สะดุดตามการรอ HTTP

ESP32 มี CPU 2 core ระบบจึงแยก task ที่ใช้เครือข่ายทั้งสอง (EmgStreamTask และ NetworkTask) ไปไว้ที่ core 0 ซึ่งเป็น core เดียวกับที่ Wi-Fi ทำงาน ส่วน task อื่นอยู่ที่ core 1 ทำให้ขณะที่ task เครือข่ายรอเซิร์ฟเวอร์ การอ่านเซนเซอร์บนอีก core ยังเดินต่อได้ตามปกติ NetworkTask ได้ stack มากที่สุดเพราะต้องเก็บข้อความ JSON ทั้งก้อนไว้ในหน่วยความจำระหว่างสร้าง ส่วน EmgStreamTask ต้องใช้ stack ให้ไลบรารี WebSocket ทำงาน

เมื่อสร้าง task ครบแล้ว งานทั้งหมดจะอยู่ใน task ทั้งห้า `loop()` ของ Arduino จึงไม่เหลืองานให้ทำ และลบตัวเองทิ้งเพื่อคืนหน่วยความจำ

```cpp
void loop() {
  vTaskDelete(NULL);
}
```

ดูโค้ดต้นฉบับ: [`esp32_workout_firmware.ino` บรรทัด 1009–1011](https://github.com/Fishcanwalk/muscle-activity-analyzer/blob/b1adde5/test-sensor/arduino/esp32_workout_firmware/esp32_workout_firmware.ino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)

#### 6.3.2.3 การจับเวลารอบ sampling ด้วย Hardware Timer

ถ้าใช้ `delay(10)` คั่นระหว่างรอบ เวลาแต่ละรอบจะเท่ากับ 10 ms บวกเวลาที่ใช้อ่านเซนเซอร์ ซึ่งไม่คงที่ รอบ sampling จึงคลาดเคลื่อนไปเรื่อย ๆ ระบบจึงใช้ hardware timer ซึ่งเป็นวงจรนับเวลาที่แยกจาก CPU และนับต่อไปได้ตรงเวลาไม่ว่า CPU จะทำอะไรอยู่

```cpp
sampleTimer = timerBegin(1000000);
timerAttachInterrupt(sampleTimer, &onSampleTimer);
timerAlarm(sampleTimer, SAMPLE_INTERVAL_MS * 1000, (SAMPLE_TIMER_CONFIG_MASK & TIMER_CFG_AUTORELOAD) != 0, 0);
timerStart(sampleTimer);
```

ดูโค้ดต้นฉบับ: [`esp32_workout_firmware.ino` บรรทัด 989–992](https://github.com/Fishcanwalk/muscle-activity-analyzer/blob/b1adde5/test-sensor/arduino/esp32_workout_firmware/esp32_workout_firmware.ino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)

timer นับขึ้นหนึ่งครั้งทุก 1 µs เมื่อนับครบ 10,000 ครั้งหรือ 10 ms จะเกิด interrupt แล้วเริ่มนับใหม่เองโดยอัตโนมัติ จึงได้สัญญาณสม่ำเสมอที่ 100 Hz

เมื่อเกิด interrupt CPU จะหยุดงานที่ทำอยู่ชั่วคราวเพื่อไปทำฟังก์ชันด้านล่าง ฟังก์ชันนี้ไม่ได้อ่านเซนเซอร์เอง ทำเพียงส่งสัญญาณบอก SensorTask ว่าถึงรอบแล้ว เพราะงานใน interrupt ต้องสั้นที่สุด ส่วนการอ่านเซนเซอร์ผ่าน I2C ใช้เวลานานและต้องรอ mutex ซึ่งทำใน interrupt ไม่ได้

```cpp
void IRAM_ATTR onSampleTimer() {
  BaseType_t xHigherPriorityTaskWoken = pdFALSE;
  xSemaphoreGiveFromISR(sampleTickSemaphore, &xHigherPriorityTaskWoken);
  if (xHigherPriorityTaskWoken) portYIELD_FROM_ISR();
}
```

ดูโค้ดต้นฉบับ: [`esp32_workout_firmware.ino` บรรทัด 249–253](https://github.com/Fishcanwalk/muscle-activity-analyzer/blob/b1adde5/test-sensor/arduino/esp32_workout_firmware/esp32_workout_firmware.ino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)

ฟังก์ชันนี้ถูกวางไว้ใน RAM ภายใน (`IRAM_ATTR`) เพื่อให้เริ่มทำงานได้ทันทีโดยไม่ต้องรออ่านโค้ดจาก flash และหลังจากส่งสัญญาณแล้ว ถ้า SensorTask สำคัญกว่างานที่ถูกขัดจังหวะไว้ ระบบจะสลับไปทำ SensorTask ทันทีเมื่อออกจาก interrupt โดยไม่ต้องรอให้งานเดิมทำจนเสร็จ

ฝั่ง SensorTask จะหยุดรอสัญญาณนี้ที่ต้นลูปทุกรอบ

```cpp
void sensorTask(void *pvParameters) {
  lastMpuMicros = micros();

  for (;;) {
    xSemaphoreTake(sampleTickSemaphore, portMAX_DELAY);
    esp_task_wdt_reset();

    unsigned long now = millis();

    pollUnoLink();
    // ...
```

ดูโค้ดต้นฉบับ: [`esp32_workout_firmware.ino` บรรทัด 586–595](https://github.com/Fishcanwalk/muscle-activity-analyzer/blob/b1adde5/test-sensor/arduino/esp32_workout_firmware/esp32_workout_firmware.ino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)

ระหว่างรอ SensorTask ไม่ใช้ CPU เลย CPU จึงว่างไปทำ task อื่นได้ เมื่อได้รับสัญญาณ SensorTask จะรายงานตัวกับ watchdog (หัวข้อ 6.3.2.7) อ่านเซนเซอร์หนึ่งรอบ แล้ววนกลับมารอสัญญาณครั้งถัดไป รอบการอ่านจึงตรงทุก 10 ms ตามจังหวะของ hardware timer

#### 6.3.2.4 การรับข้อมูลจาก Arduino Uno ผ่าน UART

Arduino Uno ส่งค่า EMG และ FSR มาเป็นข้อความบรรทัดละหนึ่งรอบในรูปแบบ `emg,fsr` เช่น `2048,1820` แต่ UART ส่งข้อมูลมาทีละตัวอักษร และในแต่ละรอบที่ SensorTask ตรวจ ข้อความหนึ่งบรรทัดอาจมาถึงไม่ครบ ฟังก์ชัน `pollUnoLink()` จึงสะสมตัวอักษรไว้จนครบบรรทัดก่อน แล้วจึงแปลงเป็นตัวเลข

```cpp
void pollUnoLink() {
  static char lineBuf[32];
  static uint8_t lineLen = 0;

  while (Serial2.available()) {
    char c = (char)Serial2.read();
    if (c == '\n') {
      lineBuf[lineLen] = '\0';
      int emg, fsr;
      if (sscanf(lineBuf, "%d,%d", &emg, &fsr) == 2) {
        unoEmgVal = emg;
        unoFsrForce = fsr;
        lastUnoRxMs = millis();
      }
      lineLen = 0;
    } else if (c != '\r' && lineLen < sizeof(lineBuf) - 1) {
      lineBuf[lineLen++] = c;
    }
  }

  bool unoLinkOk = (millis() - lastUnoRxMs) < 500;
  // ...
}
```

ดูโค้ดต้นฉบับ: [`esp32_workout_firmware.ino` บรรทัด 278–302](https://github.com/Fishcanwalk/muscle-activity-analyzer/blob/b1adde5/test-sensor/arduino/esp32_workout_firmware/esp32_workout_firmware.ino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)

1. ทุกรอบ ฟังก์ชันจะรับตัวอักษรที่มาถึงแล้วทั้งหมด นำไปต่อท้ายข้อความที่สะสมไว้ ถ้าข้อความยาวผิดปกติเกิน 32 ตัวอักษรจะไม่เก็บเพิ่ม เพื่อไม่ให้ข้อมูลล้นพื้นที่ที่เตรียมไว้
2. เมื่อเจอตัวขึ้นบรรทัดใหม่ แสดงว่าได้ข้อความครบหนึ่งรอบแล้ว จึงแยกข้อความตรงเครื่องหมายจุลภาคออกเป็นตัวเลข 2 ค่า
3. ถ้าแยกได้ครบทั้ง 2 ค่า จะเก็บเป็นค่าล่าสุดของ EMG และ FSR พร้อมจดเวลาที่รับได้ แต่ถ้าบรรทัดเสีย เช่น มีตัวอักษรหายระหว่างทาง จะทิ้งบรรทัดนั้นไปทั้งบรรทัด ระบบจึงไม่นำค่าที่ผิดไปใช้
4. ข้อความที่มายังไม่ครบบรรทัดจะถูกเก็บไว้ข้ามรอบ แล้วนำมาต่อกับตัวอักษรที่มาถึงในรอบถัดไป
5. ปกติ Uno ส่งข้อมูลมาทุก 10 ms ถ้าไม่ได้รับข้อมูลเลยนานเกิน 500 ms ระบบจะถือว่าการเชื่อมต่อกับ Uno ขาด และแจ้งทาง Serial Monitor

ค่า EMG และ FSR ที่ได้จากขั้นนี้จะถูกนำไปใช้ต่อใน SensorTask โดยค่า EMG จะถูกส่งต่อให้ EmgStreamTask ผ่าน queue (หัวข้อ 6.3.2.8)

#### 6.3.2.5 การอ่านเซนเซอร์บน I2C bus และการใช้ Mutex

หลังรับค่าจาก Uno แล้ว SensorTask จะอ่านเซนเซอร์บน I2C และนำค่าทั้งหมดไปไว้ในข้อมูลกลางให้ task อื่นใช้ ทั้งสองขั้นนี้มีของที่หลาย task ใช้ร่วมกัน ขั้นแรกคือ I2C bus ส่วนขั้นที่สองคือข้อมูลกลาง จึงต้องใช้ mutex ควบคุมทั้งสองจุด

เซนเซอร์ MPU, MAX30102, MLX90614 และจอ LCD ต่ออยู่บน I2C bus สายเดียวกัน และ bus นี้สื่อสารได้ทีละอุปกรณ์ ถ้า SensorTask กำลังอ่านเซนเซอร์อยู่แล้ว LcdTask เข้ามาเขียนจอพร้อมกัน สัญญาณบนสายจะชนกัน ทำให้ได้ข้อมูลผิดหรือ bus ค้าง ระบบจึงใช้ `i2cMutex` เป็นกุญแจของ bus task ใดจะใช้ bus ต้องขอกุญแจก่อน และคืนเมื่อใช้เสร็จ

ในหนึ่งรอบ SensorTask ขอกุญแจเพียงครั้งเดียว อ่านเซนเซอร์ทุกตัวที่ต้องอ่านให้เสร็จ แล้วจึงคืนกุญแจ

```cpp
if (xSemaphoreTake(i2cMutex, pdMS_TO_TICKS(20)) == pdTRUE) {
  if (statusMpu) updateMpu(now);

  if (statusMax) {
    max30102.check();

    while (max30102.available()) {
      long irValue = max30102.getFIFOIR();
      long redValue = max30102.getFIFORed();
      // ...
      max30102.nextSample();
    }
  }

  if (statusMlx && now - lastMlxReadMs >= MLX_READ_INTERVAL_MS) {
    lastMlxReadMs = now;
    float t = mlx.readObjectTempC();
    if (!isnan(t)) {
      skinTemp = t;
      deltaTemp = skinTemp - skinTempBaseline;
    }
  }

  xSemaphoreGive(i2cMutex);
}
```

ดูโค้ดต้นฉบับ: [`esp32_workout_firmware.ino` บรรทัด 609–658](https://github.com/Fishcanwalk/muscle-activity-analyzer/blob/b1adde5/test-sensor/arduino/esp32_workout_firmware/esp32_workout_firmware.ino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)

- ถ้ารอกุญแจเกิน 20 ms แล้วยังไม่ได้ เช่น LcdTask กำลังเขียนจออยู่ SensorTask จะข้ามการอ่าน I2C ในรอบนั้นไปเลย เพื่อไม่ให้รอบ sampling ถัดไปเลื่อนออกไป
- อ่านเฉพาะเซนเซอร์ที่เริ่มต้นสำเร็จตอนเปิดเครื่อง (หัวข้อ 6.3.2.1) เซนเซอร์ที่ใช้งานไม่ได้จะถูกข้ามไป
- เซนเซอร์แต่ละตัวถูกอ่านในความถี่ที่ต่างกันตามลักษณะของข้อมูล MPU ถูกอ่านทุกรอบ (10 ms) เพราะความเร็วการเคลื่อนไหวเปลี่ยนเร็ว ส่วน MAX30102 เก็บค่าที่วัดได้ไว้ในหน่วยความจำของตัวเองอยู่แล้ว ทุกรอบระบบจึงดึงค่าที่ค้างอยู่ออกมาจนหมดเพื่อนำไปคำนวณ HR และ SpO2 ส่วน MLX90614 ถูกอ่านเพียงทุก 250 ms เพราะอุณหภูมิผิวเปลี่ยนช้า การอ่านถี่กว่านี้ไม่ได้ข้อมูลเพิ่มแต่เสียเวลาบน bus

MAX30102 และ MLX90614 ใช้ไลบรารีสำเร็จรูป แต่ MPU ไม่มีไลบรารี เฟิร์มแวร์จึงเขียนฟังก์ชันอ่านค่าผ่าน `Wire` เอง และรองรับได้ทั้ง MPU-6050 และ MPU-6500 ฟังก์ชันอ่านค่าหนึ่งไบต์ของ MPU ทำให้เห็นว่าการอ่านค่าหนึ่งครั้งบน I2C ประกอบด้วยขั้นตอนอะไรบ้าง ไลบรารีของเซนเซอร์ตัวอื่นก็ทำขั้นตอนแบบเดียวกันเบื้องหลัง

```cpp
uint8_t mpuReadReg(uint8_t reg) {
  Wire.beginTransmission(MPU_ADDR);
  Wire.write(reg);
  Wire.endTransmission(false);
  Wire.requestFrom((uint8_t)MPU_ADDR, (uint8_t)1);
  return Wire.available() ? Wire.read() : 0xFF;
}
```

ดูโค้ดต้นฉบับ: [`esp32_workout_firmware.ino` บรรทัด 305–311](https://github.com/Fishcanwalk/muscle-activity-analyzer/blob/b1adde5/test-sensor/arduino/esp32_workout_firmware/esp32_workout_firmware.ino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)

การอ่านค่าผ่าน I2C ทำเป็น 2 จังหวะ จังหวะแรก ESP32 บอก MPU (address `0x68`) ว่าต้องการอ่าน register ใด จังหวะที่สองจึงขอข้อมูลกลับมา ระหว่างสองจังหวะนี้ ESP32 ยังไม่ปล่อย bus (repeated start) MPU จึงรู้ว่าคำขอข้อมูลเป็นส่วนต่อของคำสั่งก่อนหน้า ถ้า MPU ไม่ตอบกลับ ฟังก์ชันจะคืนค่า `0xFF` แทน โปรแกรมจึงไม่ค้างรอ

เพราะการอ่านค่าหนึ่งครั้งมีหลายจังหวะแบบนี้ ถ้า task อื่นเริ่มใช้ bus แทรกเข้ามาระหว่างจังหวะ เช่น LcdTask ส่งข้อความไปที่จอ ข้อมูลของทั้งสองฝั่งจะปนกัน นี่คือเหตุผลที่ต้องถือกุญแจ `i2cMutex` ตลอดช่วงที่อ่านเซนเซอร์

เมื่ออ่านเซนเซอร์เสร็จ ค่าที่อ่านได้ยังอยู่ในตัวแปรของ SensorTask เอง ถ้าต้องการให้ task อื่นเห็น ต้องนำไปไว้ในข้อมูลกลาง `SharedState` การเขียนลง `SharedState` ต้องถือกุญแจ `stateMutex` ด้วย เพราะถ้า NetworkTask อ่านข้อมูลขณะที่ SensorTask เขียนไปได้เพียงครึ่งเดียว ค่าที่ได้จะเป็นค่าจากคนละรอบปนกัน

```cpp
if (xSemaphoreTake(stateMutex, pdMS_TO_TICKS(20)) == pdTRUE) {
  shared.fsrLatest = fsrVal;
  shared.fsrStability = stability;
  shared.velocity = velocity;
  if (velocity > shared.peakVelocity) shared.peakVelocity = velocity;
  shared.beatAvg = beatAvg;
  shared.spo2Estimate = spo2Estimate;
  shared.skinTemp = skinTemp;
  shared.deltaTemp = deltaTemp;
  xSemaphoreGive(stateMutex);
}
```

ดูโค้ดต้นฉบับ: [`esp32_workout_firmware.ino` บรรทัด 660–670](https://github.com/Fishcanwalk/muscle-activity-analyzer/blob/b1adde5/test-sensor/arduino/esp32_workout_firmware/esp32_workout_firmware.ino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)

นอกจากค่าล่าสุดแล้ว SensorTask ยังเก็บความเร็วสูงสุดที่เจอไว้ด้วย เพราะ NetworkTask ส่งข้อมูลทุก 100 ms ถ้าส่งเฉพาะค่าล่าสุด จังหวะที่ยกน้ำหนักเร็วที่สุดอาจเกิดขึ้นระหว่างรอบส่งแล้วหายไปโดยไม่ถูกส่ง

#### 6.3.2.6 การรับสัญญาณจากปุ่มด้วย GPIO Interrupt

ปุ่ม A (GPIO32) และปุ่ม B (GPIO33) ทำงานแบบ interrupt CPU จึงไม่ต้องคอยวนตรวจสถานะปุ่มตลอดเวลา เมื่อผู้ใช้กดปุ่ม ฮาร์ดแวร์จะแจ้ง CPU เอง ใน `setup()` ตั้งค่าขาของปุ่มทั้งสองพร้อมกัน

```cpp
gpio_config_t buttonIoConf = {};
buttonIoConf.pin_bit_mask = BUTTON_PIN_BIT_MASK;
buttonIoConf.mode = GPIO_MODE_INPUT;
buttonIoConf.pull_up_en = GPIO_PULLUP_ENABLE;
buttonIoConf.pull_down_en = GPIO_PULLDOWN_DISABLE;
buttonIoConf.intr_type = GPIO_INTR_NEGEDGE;
gpio_config(&buttonIoConf);

gpio_install_isr_service(0);
gpio_isr_handler_add((gpio_num_t)BUTTON_A_PIN, buttonA_isr, nullptr);
gpio_isr_handler_add((gpio_num_t)BUTTON_B_PIN, buttonB_isr, nullptr);
```

ดูโค้ดต้นฉบับ: [`esp32_workout_firmware.ino` บรรทัด 977–987](https://github.com/Fishcanwalk/muscle-activity-analyzer/blob/b1adde5/test-sensor/arduino/esp32_workout_firmware/esp32_workout_firmware.ino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)

ขาของปุ่มเปิดตัวต้านทาน pull-up ภายในไว้ ขณะที่ไม่ได้กด ขาจึงเป็น HIGH และเมื่อกดปุ่ม ขาจะเปลี่ยนเป็น LOW ระบบตั้งให้เกิด interrupt ตอนสัญญาณเปลี่ยนจาก HIGH เป็น LOW ซึ่งก็คือจังหวะที่เริ่มกดปุ่ม แต่ละปุ่มมีฟังก์ชันรับ interrupt ของตัวเอง

ปุ่มแบบกลไกมีปัญหาอย่างหนึ่ง เมื่อกดหนึ่งครั้ง หน้าสัมผัสจะเด้งกระทบกันหลายครั้งในเวลาสั้น ๆ ทำให้เกิด interrupt ซ้อนกันหลายครั้ง ฟังก์ชันรับ interrupt จึงต้องกรองสัญญาณเด้งเหล่านี้ออก (debounce)

```cpp
void IRAM_ATTR buttonA_isr(void *arg) {
  int64_t now = esp_timer_get_time();
  if (now - lastButtonAIsrUs < (int64_t)BUTTON_DEBOUNCE_US) return;
  lastButtonAIsrUs = now;
  uint8_t id = 0;
  BaseType_t xHigherPriorityTaskWoken = pdFALSE;
  xQueueSendFromISR(buttonEventQueue, &id, &xHigherPriorityTaskWoken);
  if (xHigherPriorityTaskWoken) portYIELD_FROM_ISR();
}
```

ดูโค้ดต้นฉบับ: [`esp32_workout_firmware.ino` บรรทัด 258–266](https://github.com/Fishcanwalk/muscle-activity-analyzer/blob/b1adde5/test-sensor/arduino/esp32_workout_firmware/esp32_workout_firmware.ino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)

ทุกครั้งที่เกิด interrupt ฟังก์ชันจะดูเวลาปัจจุบันแบบละเอียดระดับไมโครวินาที ถ้าห่างจากครั้งก่อนไม่ถึง 250 ms จะถือว่าเป็นสัญญาณเด้งและไม่สนใจ ถ้าห่างพอจะถือว่าเป็นการกดครั้งใหม่ แล้วส่งหมายเลขปุ่ม (A = 0, B = 1) เข้าคิวให้ ControlTask ฟังก์ชันนี้ไม่ได้เปลี่ยนสถานะการฝึกเอง เพราะการเปลี่ยนสถานะต้องรอกุญแจ `stateMutex` ซึ่งไม่ควรทำใน interrupt จึงส่งต่อให้ ControlTask จัดการแทน

ControlTask รับหมายเลขปุ่มจากคิว แล้วตรวจสอบอีกชั้นก่อนเปลี่ยนสถานะการฝึก

```cpp
uint8_t buttonId;
if (xQueueReceive(buttonEventQueue, &buttonId, pdMS_TO_TICKS(100)) == pdTRUE && buttonId < 2) {
  vTaskDelay(pdMS_TO_TICKS(BUTTON_SETTLE_MS));
  bool isRealPress = buttonArmed[buttonId] && gpio_get_level(buttonPins[buttonId]) == 0;
  if (isRealPress) buttonArmed[buttonId] = false;

  unsigned long pressNow = millis();
  if (isRealPress && xSemaphoreTake(stateMutex, pdMS_TO_TICKS(50)) == pdTRUE) {
    if (buttonId == 0) {
      shared.setActive = !shared.setActive;
      if (shared.setActive) {
        shared.setStartMs = pressNow;
        shared.setCount++;
      } else {
        shared.restStartMs = pressNow;
      }
      shared.buttonAEventPending = true;
    } else {
      shared.setActive = false;
      shared.restStartMs = pressNow;
      shared.setCount = 0;
      shared.buttonBEventPending = true;
    }
    shared.lastActivityMs = pressNow;
    xSemaphoreGive(stateMutex);
  }
}
```

ดูโค้ดต้นฉบับ: [`esp32_workout_firmware.ino` บรรทัด 828–854](https://github.com/Fishcanwalk/muscle-activity-analyzer/blob/b1adde5/test-sensor/arduino/esp32_workout_firmware/esp32_workout_firmware.ino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)

1. ControlTask รอ 30 ms ให้สัญญาณนิ่งก่อน แล้วอ่านสถานะปุ่มอีกครั้ง ถ้าปุ่มยังถูกกดอยู่จึงนับว่าเป็นการกดจริง ขั้นนี้ช่วยกรองสัญญาณรบกวนที่ทำให้เกิด interrupt ทั้งที่ผู้ใช้ไม่ได้กด
2. ถ้าผู้ใช้กดปุ่มค้างไว้ ระบบจะนับเพียงครั้งเดียว และต้องปล่อยปุ่มก่อนจึงจะนับการกดครั้งถัดไปได้
3. ปุ่ม A ใช้สลับระหว่างเริ่มเซตกับพักเซต ทุกครั้งที่เริ่มเซตใหม่ จำนวนเซตจะเพิ่มขึ้นหนึ่ง และระบบจะจดเวลาเริ่มเซตหรือเวลาเริ่มพักไว้ ส่วนปุ่ม B ใช้หยุดการฝึกและรีเซ็ตจำนวนเซตกลับเป็น 0
4. ระบบทำเครื่องหมายไว้ว่ามีการกดปุ่มที่ยังไม่ได้แจ้งเว็บไซต์ NetworkTask จะเห็นเครื่องหมายนี้และส่งเหตุการณ์ไปในรอบถัดไป (หัวข้อ 6.3.2.8) พร้อมกันนั้นระบบจะบันทึกเวลาที่มีการใช้งานล่าสุดไว้ สำหรับตัดสินใจว่าจะเข้า Sleep Mode เมื่อใด (หัวข้อ 6.3.2.9)

#### 6.3.2.7 การป้องกันระบบค้างด้วย Watchdog Timer

watchdog เป็นตัวจับเวลาที่โปรแกรมต้องคอยรีเซ็ตเป็นระยะ ถ้าไม่มีการรีเซ็ตจนหมดเวลา แปลว่าโปรแกรมค้างอยู่ที่ใดที่หนึ่ง watchdog จะสั่งรีสตาร์ทบอร์ดให้กลับมาทำงานใหม่เอง ระบบตั้งเวลาไว้ 8 วินาที

```cpp
void initWatchdog() {
  esp_task_wdt_config_t twdt_config = {
    .timeout_ms = (uint32_t)(WATCHDOG_TIMEOUT_S * 1000),
    .idle_core_mask = 0,
    .trigger_panic = true,
  };
  if (esp_task_wdt_init(&twdt_config) != ESP_OK) {
    esp_task_wdt_reconfigure(&twdt_config);
  }
}
```

ดูโค้ดต้นฉบับ: [`esp32_workout_firmware.ino` บรรทัด 532–541](https://github.com/Fishcanwalk/muscle-activity-analyzer/blob/b1adde5/test-sensor/arduino/esp32_workout_firmware/esp32_workout_firmware.ino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)

เมื่อหมดเวลา watchdog จะทำให้ระบบ panic และรีสตาร์ทบอร์ด watchdog ตัวนี้เฝ้าเฉพาะ task ที่ระบบลงทะเบียนไว้เอง ไม่ได้เฝ้า task พื้นฐานของระบบ นอกจากนี้ ESP32 Arduino core อาจเปิด watchdog ไว้ก่อนแล้วตั้งแต่บูต ถ้าเปิดซ้ำไม่สำเร็จ ระบบจะเปลี่ยนค่าของ watchdog ที่เปิดอยู่ให้เป็นค่าที่ต้องการแทน

หลังสร้าง task ครบ `setup()` จะลงทะเบียน task หลักทุกตัวไว้กับ watchdog

```cpp
esp_task_wdt_add(sensorTaskHandle);
esp_task_wdt_add(networkTaskHandle);
esp_task_wdt_add(lcdTaskHandle);
esp_task_wdt_add(controlTaskHandle);
esp_task_wdt_add(emgStreamTaskHandle);
```

ดูโค้ดต้นฉบับ: [`esp32_workout_firmware.ino` บรรทัด 1000–1004](https://github.com/Fishcanwalk/muscle-activity-analyzer/blob/b1adde5/test-sensor/arduino/esp32_workout_firmware/esp32_workout_firmware.ino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)

watchdog ติดตามแยกเป็นราย task ทุก task ที่ลงทะเบียนต้องรายงานตัวภายใน 8 วินาที ถ้า task ใดค้าง แม้จะเป็นเพียงตัวเดียวและ task อื่นยังทำงานปกติ บอร์ดก็จะถูกรีสตาร์ท แต่ละ task จึงรายงานตัวที่ต้นลูปทุกรอบ ส่วน NetworkTask รายงานตัวอีกครั้งหลังส่ง HTTP เสร็จ เพราะรอบที่เครือข่ายช้าอาจใช้เวลารอนานหลายวินาที

#### 6.3.2.8 การส่งข้อมูลขึ้นเว็บไซต์ใน EmgStreamTask และ NetworkTask

ข้อมูลจากบอร์ดแบ่งส่งเป็น 2 ช่องทางตามลักษณะของข้อมูล

| ช่องทาง | Task | รอบส่ง | ข้อมูล |
| --- | --- | --- | --- |
| WebSocket`/ws/emg?role=device` | `EmgStreamTask` | 20 ms | ค่า EMG ดิบทุกตัวอย่าง |
| HTTP`POST /api/telemetry` | `NetworkTask` | 100 ms | FSR, MPU, ชีพจร, อุณหภูมิ และเหตุการณ์กดปุ่ม |

EMG เปลี่ยนเร็วและหน้าเว็บต้องวาดกราฟให้ต่อเนื่อง ถ้าส่งด้วย HTTP ทุกครั้งต้องมี header ซ้ำและต้องรอคำตอบก่อนส่งรอบถัดไป ส่วน WebSocket เปิดการเชื่อมต่อค้างไว้ครั้งเดียวแล้วส่งข้อความต่อเนื่องได้ทันทีโดยไม่ต้องรอคำตอบ overhead ต่อข้อความจึงต่ำกว่ามาก ส่วนเซนเซอร์อื่นเปลี่ยนช้ากว่า และคำตอบของ POST ใช้ส่งคำสั่งจากเว็บกลับมาที่บอร์ดอยู่แล้ว จึงยังใช้ HTTP ต่อ

**(ก) การส่ง EMG ผ่าน WebSocket**

ข้อมูลส่วนใหญ่ เช่น แรงกด ความเร็ว และอัตราการเต้นของหัวใจ ส่งเพียงค่าล่าสุดของแต่ละรอบก็พอ แต่ค่า EMG ต้องส่งขึ้นเว็บให้ครบทุกตัวอย่าง ปัญหาคือ SensorTask ได้ค่า EMG ใหม่ทุก 10 ms ขณะที่ EmgStreamTask ส่งทุก 20 ms และการส่งแต่ละครั้งอาจช้าลงเมื่อเครือข่ายไม่ดี จึงต้องมีที่พักข้อมูลระหว่างสอง task นี้ SensorTask จะใส่ค่า EMG ที่รับจาก Uno (หัวข้อ 6.3.2.4) ลง `emgQueue` ทุกรอบ แล้ว EmgStreamTask มาเก็บออกไปส่งทีเดียวทั้งชุด

```cpp
if (xQueueSend(emgQueue, &emgVal, 0) != pdTRUE) {
  int discarded;
  xQueueReceive(emgQueue, &discarded, 0);
  xQueueSend(emgQueue, &emgVal, 0);
}
```

ดูโค้ดต้นฉบับ: [`esp32_workout_firmware.ino` บรรทัด 602–606](https://github.com/Fishcanwalk/muscle-activity-analyzer/blob/b1adde5/test-sensor/arduino/esp32_workout_firmware/esp32_workout_firmware.ino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)

queue มี 64 ช่อง พอเก็บข้อมูลได้ประมาณ 640 ms ถ้าเครือข่ายช้าจน EmgStreamTask มาเก็บไม่ทันและ queue เต็ม ระบบจะทิ้งค่าที่เก่าที่สุดหนึ่งค่าเพื่อเปิดที่ให้ค่าใหม่ โดย SensorTask ไม่ต้องหยุดรอ ข้อมูลที่ส่งขึ้นเว็บจึงเป็นช่วงล่าสุดเสมอ

EmgStreamTask ใช้ไลบรารี WebSockets (by Markus Sattler) ผ่านคลาส `WebSocketsClient`

```cpp
void emgStreamTask(void *pvParameters) {
  emgSocket.begin(SERVER_HOST, SERVER_PORT, EMG_WS_PATH);
  emgSocket.onEvent(onEmgSocketEvent);
  emgSocket.setReconnectInterval(EMG_WS_RECONNECT_MS);

  TickType_t lastWake = xTaskGetTickCount();
  for (;;) {
    vTaskDelayUntil(&lastWake, pdMS_TO_TICKS(EMG_STREAM_INTERVAL_MS));
    esp_task_wdt_reset();

    if (WiFi.status() == WL_CONNECTED) emgSocket.loop();

    char frame[EMG_QUEUE_LEN * 6];
    int pos = 0;
    int count = 0;
    int sample;
    while (pos < (int)sizeof(frame) - 8 && xQueueReceive(emgQueue, &sample, 0) == pdTRUE) {
      pos += snprintf(frame + pos, sizeof(frame) - pos, "%s%d", count == 0 ? "" : ",", sample);
      count++;
    }
    if (count > 0 && emgSocket.isConnected()) emgSocket.sendTXT(frame, pos);
  }
}
```

ดูโค้ดต้นฉบับ: [`esp32_workout_firmware.ino` บรรทัด 772–794](https://github.com/Fishcanwalk/muscle-activity-analyzer/blob/b1adde5/test-sensor/arduino/esp32_workout_firmware/esp32_workout_firmware.ino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)

1. ตอนเริ่ม task จะตั้งปลายทางของ WebSocket เป็น `SERVER_HOST:SERVER_PORT/ws/emg?role=device` พารามิเตอร์ `role=device` บอกเซิร์ฟเวอร์ว่าการเชื่อมต่อนี้มาจากบอร์ด ไม่ใช่ browser และตั้งให้ต่อใหม่เองทุก 2 วินาทีเมื่อการเชื่อมต่อหลุด
2. task ตื่นทุก 20 ms โดยนับจากเวลาที่ตื่นครั้งก่อน เหมือน NetworkTask แล้วรายงานตัวกับ watchdog
3. `emgSocket.loop()` เป็นจุดที่ไลบรารีทำงานเบื้องหลัง เช่น เชื่อมต่อใหม่ ตอบ ping จากเซิร์ฟเวอร์ และรับข้อความ ต้องเรียกสม่ำเสมอ การเชื่อมต่อจึงไม่ถูกตัด
4. ดึงค่า EMG ที่สะสมอยู่ในคิวออกมาทั้งหมด แล้วต่อกันเป็นข้อความคั่นด้วยจุลภาค ปกติได้ 2 ค่าต่อรอบ เพราะ sample ทุก 10 ms แต่ส่งทุก 20 ms เช่น `2612,2618` ข้อความนี้สั้นกว่า JSON มาก และสร้างในพื้นที่ขนาดคงที่ไม่ต้องขอหน่วยความจำเพิ่ม
5. ถ้าเชื่อมต่ออยู่จะส่งด้วย `sendTXT()` ซึ่งไม่ต้องรอคำตอบ ถ้าการเชื่อมต่อหลุด ค่าที่ดึงออกมาในรอบนั้นจะถูกทิ้งไป ไม่ส่งย้อนหลัง เพราะกราฟสดต้องการค่าปัจจุบันมากกว่าค่าที่ค้างมา

ตำแหน่งของเซิร์ฟเวอร์รวมไว้ที่ `SERVER_HOST` และ `SERVER_PORT` จุดเดียว ทั้ง WebSocket และ URL ของ HTTP POST สร้างจากสองค่านี้ เวลาย้ายเครื่องเซิร์ฟเวอร์จึงแก้เพียงที่เดียว

**(ข) การส่งเซนเซอร์อื่นผ่าน HTTP POST**

NetworkTask นำค่า FSR มารวมกับข้อมูลจากเซนเซอร์อื่นเป็น JSON ทุก 100 ms แล้วส่งไปยัง API `POST /api/telemetry` ของเว็บไซต์ ก่อนเริ่มส่ง ระบบเตรียมตัวส่ง HTTP ไว้หนึ่งครั้ง

```cpp
void setupHttpClient() {
  http.end();
  http.begin(httpClient, serverUrl);
  http.addHeader("Content-Type", "application/json");
  http.setReuse(true);
  http.setConnectTimeout(HTTP_CONNECT_TIMEOUT_MS);
  http.setTimeout(HTTP_READ_TIMEOUT_MS);
  tcpNoDelaySet = false;
}
```

ดูโค้ดต้นฉบับ: [`esp32_workout_firmware.ino` บรรทัด 224–232](https://github.com/Fishcanwalk/muscle-activity-analyzer/blob/b1adde5/test-sensor/arduino/esp32_workout_firmware/esp32_workout_firmware.ino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)

การเปิดการเชื่อมต่อกับเซิร์ฟเวอร์ใหม่ทุกครั้งใช้เวลา ระบบจึงเปิดการเชื่อมต่อไว้ครั้งเดียวแล้วใช้ซ้ำทุกรอบ (keep-alive) และจำกัดเวลารอไว้ คือรอเชื่อมต่อได้ไม่เกิน 1.5 วินาที และรอคำตอบได้ไม่เกิน 3 วินาที เวลารอรวมจึงสั้นกว่า 8 วินาทีของ watchdog แม้เครือข่ายจะช้า บอร์ดก็จะไม่ถูกรีสตาร์ท หลังส่งสำเร็จครั้งแรกของการเชื่อมต่อแต่ละครั้ง ระบบจะเปิด TCP_NODELAY เพื่อให้ packet เล็ก ๆ ถูกส่งออกทันทีโดยไม่ถูกรอรวมกัน ตัวแปร `tcpNoDelaySet` จึงถูกล้างทุกครั้งที่เตรียมการเชื่อมต่อใหม่

ในแต่ละรอบ NetworkTask ตรวจก่อนว่าพร้อมส่งหรือไม่

```cpp
for (;;) {
  vTaskDelayUntil(&lastWake, pdMS_TO_TICKS(SEND_INTERVAL_MS));
  esp_task_wdt_reset();

  if (WiFi.status() != WL_CONNECTED) continue;

  if (consecutiveFailures >= HTTP_MAX_CONSECUTIVE_FAILURES && (int32_t)(xTaskGetTickCount() - retryAfter) < 0) {
    continue;
  }
  // ...
```

ดูโค้ดต้นฉบับ: [`esp32_workout_firmware.ino` บรรทัด 691–699](https://github.com/Fishcanwalk/muscle-activity-analyzer/blob/b1adde5/test-sensor/arduino/esp32_workout_firmware/esp32_workout_firmware.ino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)

1. NetworkTask ตื่นขึ้นทุก 100 ms โดยนับจากเวลาที่ตื่นครั้งก่อน ไม่ได้นับจากเวลาที่ทำงานเสร็จ รอบที่ใช้เวลาประมวลผลนานจึงไม่ทำให้รอบถัดไปเลื่อนออกไป
2. ถ้า Wi-Fi ยังไม่เชื่อมต่อจะข้ามรอบนี้ไป และถ้าส่งไม่สำเร็จติดกันครบ 3 ครั้ง จะพักการส่งไว้ 1 วินาทีก่อนลองใหม่ (backoff)

จากนั้นคัดลอกข้อมูลกลางทั้งหมดออกมา แล้วประกอบเป็นข้อความ JSON

```cpp
SharedState snap;
bool sentButtonA = false, sentButtonB = false;
if (xSemaphoreTake(stateMutex, pdMS_TO_TICKS(50)) == pdTRUE) {
  snap = shared;
  shared.peakVelocity = shared.velocity;
  sentButtonA = shared.buttonAEventPending;
  sentButtonB = shared.buttonBEventPending;
  shared.buttonAEventPending = false;
  shared.buttonBEventPending = false;
  xSemaphoreGive(stateMutex);
}

char payload[768];
snprintf(payload, sizeof(payload),
         "{\"board\":\"esp32\","
         "\"fsr\":{\"force\":%d,\"stability\":%.1f},"
         "\"mpu\":{\"velocity\":%.3f,\"peakVelocity\":%.3f},"
         "\"vitals\":{\"hr\":%d,\"spo2\":%.1f,\"skinTemp\":%.2f,\"deltaTemp\":%.2f},"
         "\"buttons\":{\"a\":%s,\"b\":%s}}",
         snap.fsrLatest, snap.fsrStability,
         snap.velocity, snap.peakVelocity,
         snap.beatAvg, snap.spo2Estimate, snap.skinTemp, snap.deltaTemp,
         sentButtonA ? "true" : "false", sentButtonB ? "true" : "false");
```

ดูโค้ดต้นฉบับ: [`esp32_workout_firmware.ino` บรรทัด 701–723](https://github.com/Fishcanwalk/muscle-activity-analyzer/blob/b1adde5/test-sensor/arduino/esp32_workout_firmware/esp32_workout_firmware.ino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)

- NetworkTask ถือกุญแจ `stateMutex` เพียงช่วงสั้น ๆ ที่คัดลอกข้อมูลออกมาเท่านั้น แล้วจึงคืนกุญแจก่อนสร้าง JSON ซึ่งใช้เวลานานกว่า SensorTask จึงไม่ต้องรอกุญแจนาน
- หลังคัดลอก ความเร็วสูงสุดจะถูกตั้งกลับเป็นความเร็วปัจจุบัน เพื่อเริ่มจับค่าสูงสุดของรอบถัดไปใหม่ ค่าที่ส่งจึงเป็นความเร็วสูงสุดของแต่ละช่วง 100 ms
- เครื่องหมายการกดปุ่มจะถูกล้างทันทีหลังคัดลอก เพื่อไม่ให้ส่งเหตุการณ์กดปุ่มเดิมซ้ำในรอบถัดไป
- JSON ไม่มีกลุ่ม `emg` แล้ว เพราะ EMG ส่งทาง WebSocket (ข้อ ก)
- ข้อความ JSON ถูกสร้างลงในพื้นที่ขนาดคงที่ 768 ไบต์ที่เตรียมไว้ โดยไม่ใช้ไลบรารี JSON ระบบจึงไม่ต้องขอหน่วยความจำเพิ่มระหว่างทำงาน ซึ่งช่วยป้องกันหน่วยความจำไม่พอเมื่อเครื่องเปิดใช้งานนาน ๆ

ตัวอย่าง payload ที่ได้

```json
{"board":"esp32","fsr":{"force":1820,"stability":92.5},"mpu":{"velocity":0.215,"peakVelocity":0.340},"vitals":{"hr":88,"spo2":97.5,"skinTemp":33.10,"deltaTemp":0.45},"buttons":{"a":false,"b":false}}
```

สุดท้ายจึงส่งข้อมูลและจัดการผลลัพธ์

```cpp
int code = http.POST(payload);
esp_task_wdt_reset();
// ...
if (code > 0) {
  consecutiveFailures = 0;
  // ...
  applyServerReply(http.getString());
  // ...
} else {
  if (consecutiveFailures < 255) consecutiveFailures++;
  // ...
  setupHttpClient();

  if (consecutiveFailures >= HTTP_MAX_CONSECUTIVE_FAILURES) {
    retryAfter = xTaskGetTickCount() + pdMS_TO_TICKS(HTTP_BACKOFF_MS);
    // ...
  }

  if (sentButtonA || sentButtonB) {
    if (xSemaphoreTake(stateMutex, pdMS_TO_TICKS(50)) == pdTRUE) {
      shared.buttonAEventPending |= sentButtonA;
      shared.buttonBEventPending |= sentButtonB;
      xSemaphoreGive(stateMutex);
    }
  }
}
```

ดูโค้ดต้นฉบับ: [`esp32_workout_firmware.ino` บรรทัด 726–763](https://github.com/Fishcanwalk/muscle-activity-analyzer/blob/b1adde5/test-sensor/arduino/esp32_workout_firmware/esp32_workout_firmware.ino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)

- ถ้าส่งสำเร็จ ตัวนับความผิดพลาดจะกลับเป็น 0 และระบบจะอ่านคำตอบจากเซิร์ฟเวอร์ ซึ่งมีค่า calibration ของ FSR (`fsrZero`, `fsrMax`) และคำสั่งทดสอบ buzzer (`beep`) ที่ผู้ใช้ตั้งไว้จากหน้าเว็บ ช่องทางนี้ทำให้หน้าเว็บส่งคำสั่งกลับมายังอุปกรณ์ได้โดยไม่ต้องเปิดการเชื่อมต่อแยก
- ถ้าส่งไม่สำเร็จ ระบบจะเตรียมตัวส่ง HTTP ใหม่เผื่อการเชื่อมต่อเดิมเสีย และเมื่อผิดพลาดติดกันครบ 3 ครั้งจะพักการส่ง 1 วินาที เพื่อไม่ให้ส่งซ้ำถี่ ๆ ขณะที่เซิร์ฟเวอร์ติดต่อไม่ได้ ระหว่างนี้ EMG ยังส่งผ่าน WebSocket ได้ตามปกติ เพราะอยู่คนละ task
- ถ้ารอบที่ส่งไม่สำเร็จมีเหตุการณ์กดปุ่มอยู่ด้วย ระบบจะทำเครื่องหมายไว้ใหม่ให้ส่งอีกครั้งในรอบถัดไป ข้อมูลเซนเซอร์ที่หายไปหนึ่งรอบไม่ส่งผลมากนักเพราะรอบถัดไปก็มีค่าใหม่มาแทน แต่การกดปุ่มเปลี่ยนสถานะการฝึก จึงต้องไม่หายไประหว่างที่เครือข่ายมีปัญหา

#### 6.3.2.9 การประหยัดพลังงานด้วย Light Sleep

ControlTask คอยตรวจว่าอุปกรณ์ถูกทิ้งไว้โดยไม่มีการใช้งานนานเท่าใด ถ้าอยู่ในสถานะที่ยังไม่เริ่มฝึก (ยังไม่เริ่มเซตแรก หรือกดปุ่ม B รีเซ็ตแล้ว) และไม่มีการกดปุ่มเลยนานครบ 5 นาที ระบบจะพาอุปกรณ์เข้าสู่ Light Sleep

```cpp
void enterLightSleepUntilWake() {
  // ...
  WiFi.disconnect(true);

  esp_task_wdt_delete(sensorTaskHandle);
  esp_task_wdt_delete(networkTaskHandle);
  esp_task_wdt_delete(lcdTaskHandle);
  esp_task_wdt_delete(controlTaskHandle);
  esp_task_wdt_delete(emgStreamTaskHandle);
  esp_task_wdt_deinit();

  if (SLEEP_WAKE_SOURCE_MASK & WAKE_SRC_EXT0) {
    esp_sleep_enable_ext0_wakeup((gpio_num_t)BUTTON_A_PIN, 0  );
  }
  if (SLEEP_WAKE_SOURCE_MASK & WAKE_SRC_TIMER) {
    esp_sleep_enable_timer_wakeup(IDLE_WAKE_KEEPALIVE_US);
  }

  esp_light_sleep_start();

  // ...
  initWatchdog();
  esp_task_wdt_add(sensorTaskHandle);
  esp_task_wdt_add(networkTaskHandle);
  esp_task_wdt_add(lcdTaskHandle);
  esp_task_wdt_add(controlTaskHandle);
  esp_task_wdt_add(emgStreamTaskHandle);

  connectWiFi();
}
```

ดูโค้ดต้นฉบับ: [`esp32_workout_firmware.ino` บรรทัด 543–584](https://github.com/Fishcanwalk/muscle-activity-analyzer/blob/b1adde5/test-sensor/arduino/esp32_workout_firmware/esp32_workout_firmware.ino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)

1. จอ LCD ขึ้นข้อความ `SLEEPING...` ให้ผู้ใช้รู้ว่าเครื่องกำลังจะพัก แล้วระบบตัดการเชื่อมต่อ Wi-Fi ซึ่งเป็นส่วนที่กินไฟมาก
2. ระบบปิด watchdog ก่อน เพราะระหว่างที่ CPU หลับ ไม่มี task ใดรายงานตัวกับ watchdog ได้ ถ้าไม่ปิดไว้ watchdog จะเข้าใจว่า task ค้างและรีสตาร์ทบอร์ดทันทีที่ตื่น
3. ระบบตั้งเหตุการณ์ที่จะปลุกเครื่องไว้ 2 แบบ แบบแรกคือการกดปุ่ม A ส่วนแบบที่สองคือ timer ที่ปลุกเครื่องเมื่อหลับครบ 5 วินาที
4. จากนั้น CPU จะหยุดทำงานจนกว่าจะถูกปลุก ระหว่างนี้ข้อมูลในหน่วยความจำยังอยู่ครบ เมื่อตื่นขึ้นมา โปรแกรมจึงทำงานต่อจากจุดเดิมได้ทันทีโดยไม่ต้องบูตใหม่
5. หลังตื่น ระบบเปิด watchdog และลงทะเบียน task ใหม่ แล้วเชื่อมต่อ Wi-Fi อีกครั้ง จากนั้นจึงเริ่มนับเวลาไม่มีการใช้งานใหม่ ต้องไม่มีการใช้งานอีก 5 นาทีจึงจะเข้า sleep รอบถัดไป

ใช้ [`../flowchart.md`](../flowchart.md) Flowchart 3 เป็นรูปประกอบหัวข้อนี้

## 6.4 เว็บและเซิร์ฟเวอร์: รับ telemetry, กระจายผ่าน WebSocket และ SSE, เริ่ม/หยุดบันทึก, ส่งต่อ FastAPI และเก็บ MongoDB

### 6.4.1 ภาพรวมการทำงาน

**การแบ่งหน้าที่ของเซิร์ฟเวอร์:** ฝั่งเซิร์ฟเวอร์แบ่งเป็น 2 ส่วน ได้แก่

- เว็บเซิร์ฟเวอร์ SvelteKit: รับข้อมูลจาก ESP32 แปลงค่า แล้วส่งข้อมูลสดให้ browser
- API เซิร์ฟเวอร์ FastAPI: ตรวจสอบผู้ใช้ และเก็บข้อมูลลงฐานข้อมูล MongoDB

**การรับข้อมูลจาก ESP32:** ESP32 ส่งข้อมูลมา 2 ช่องทาง ได้แก่

- WebSocket `/ws/emg?role=device`: ค่า EMG ดิบ (ADC 0–4095) คั่นด้วยจุลภาค ทุก 20 ms เช่น `2612,2618`
- `POST /api/telemetry`: JSON ของ FSR, MPU, ชีพจร, อุณหภูมิ และปุ่ม ทุก 100 ms

เว็บเซิร์ฟเวอร์เก็บค่าล่าสุดของเซนเซอร์แต่ละกลุ่มไว้ในหน่วยความจำ และนับจำนวน packet ที่ได้รับต่อวินาทีเพื่อบอกว่าบอร์ดยังเชื่อมต่ออยู่

**การแปลงค่าและนับจำนวนครั้ง:** เว็บเซิร์ฟเวอร์แปลงค่า ADC ของ EMG เป็นหน่วย µV แล้วเทียบเป็นเปอร์เซ็นต์ของ MVC ที่ได้จากการ calibrate ส่วนค่า FSR แปลงเป็นเปอร์เซ็นต์ของแรงบีบสูงสุด ค่า EMG ทุกตัวอย่างที่มาทาง WebSocket ยังถูกส่งเข้าตัวนับจำนวนครั้ง (rep) ด้วย เมื่อนับได้ 1 ครั้งจะส่ง event `emgRep` ไปยัง browser

**การส่งข้อมูลสดไปยัง browser:** browser เปิดการเชื่อมต่อค้างไว้ 2 ช่องทาง ทั้งสองช่องทางส่ง ping ทุก 15 วินาทีเพื่อไม่ให้ reverse proxy ตัดการเชื่อมต่อช่วงที่ไม่มีข้อมูล

- WebSocket `/ws/emg` (ไม่มี `role`): ส่งข้อมูล EMG เป็น JSON 3 แบบ
  - `init`: ส่งครั้งแรกตอนเปิดการเชื่อมต่อ มีสถานะ EMG ทั้งหมดรวม buffer 150 ค่าล่าสุด
  - `emg`: ส่งทุกครั้งที่บอร์ดส่ง frame มา มีเฉพาะ sample ใหม่ (µV หลังลบ baseline) พร้อม `level`, `rms`, `mvcPercent` และ `isHighTension`
  - `emgRep`: ส่งเมื่อนับได้ 1 rep
- `GET /api/telemetry/stream` แบบ Server-Sent Events (SSE): ครั้งแรกส่งสถานะของเซนเซอร์อื่น (ไม่รวม EMG) ให้ก่อน จากนั้นส่ง event `telemetry` และ `button` ทันทีที่มีข้อมูลใหม่

browser ต่อ sample ใหม่เข้า buffer ของตัวเองแล้วตัดให้เหลือ 150 ค่า เซิร์ฟเวอร์จึงไม่ต้องส่ง buffer ทั้งก้อนทุกครั้ง ถ้า browser เครื่องใดรับข้อมูลไม่ทันจน buffer ของการเชื่อมต่อเกิน 1 MB เซิร์ฟเวอร์จะข้าม browser นั้นไปในรอบนั้น ไม่ให้เครื่องที่ช้าถ่วงเครื่องอื่น

**การต่อ WebSocket เข้ากับ SvelteKit:** route ของ SvelteKit รองรับเฉพาะ HTTP จึงเขียน WebSocket server แยกไว้ที่ `frontend/emg-ws.js` โดยใช้ไลบรารี `ws` ตอนพัฒนา plugin ใน `vite.config.ts` ต่อ WebSocket เข้ากับ dev server ส่วนตอน production ใช้ `frontend/server.js` เป็น entry point แทน `node build` ซึ่งใช้ handler ของ SvelteKit ตัวเดิมแล้วต่อ WebSocket ลง http server เดียวกัน `emg-ws.js` อยู่นอกระบบ module ของ SvelteKit จึง import `telemetryStore.ts` ตรง ๆ ไม่ได้ ทั้งสองฝั่งคุยกันผ่าน `globalThis.__cyberpumpEmg` แทน การแปลงหน่วยและตัวนับ rep จึงยังใช้โค้ดเดิมใน `telemetryStore.ts`

**การส่งคำสั่งกลับไปยังบอร์ด:** เว็บส่งคำสั่งไปหา ESP32 โดยตรงไม่ได้ จึงแนบคำสั่งไปกับคำตอบของ `POST /api/telemetry` ได้แก่ ช่วงค่า FSR ที่ calibrate แล้ว (`fsrZero`, `fsrMax`) และคำสั่งทดสอบ buzzer (`beep`)

**การเริ่มและหยุดบันทึก:** ผู้ใช้ที่ login แล้วสั่งเริ่มหรือหยุดบันทึกผ่าน `POST /api/recording` เนื่องจากมีอุปกรณ์เพียงชุดเดียว ระบบจึงให้บันทึกได้ครั้งละ 1 คน หากผู้ใช้คนอื่นกำลังบันทึกอยู่จะได้ข้อผิดพลาด 409 และถ้าบันทึกนานเกิน 10 นาทีระบบจะหยุดบันทึกเองเผื่อกรณีผู้ใช้ปิดหน้าเว็บไปโดยไม่กดหยุด

**การส่งข้อมูลต่อไปยัง FastAPI:** ระหว่างที่กำลังบันทึก ทุก packet ที่ได้รับทาง `POST /api/telemetry` (ทุก 100 ms) จะถูกส่งต่อไปยัง `POST /v1/telemetry` ของ FastAPI พร้อม `user_id` และ `session_id` โดยยืนยันตัวตนด้วย service token แทน token ของผู้ใช้ ข้อมูลที่ส่งต่อรวมสถานะ EMG ล่าสุดที่ได้จาก WebSocket ไว้ด้วย frame ของ WebSocket เองไม่ได้ถูกส่งต่อทีละ frame ส่วนการส่งข้อมูลสดผ่าน WebSocket และ SSE ยังทำงานตลอดไม่ว่าจะบันทึกอยู่หรือไม่

**การ calibrate:** ค่า calibrate ถูกบันทึกผ่าน `/api/calibration` ซึ่งส่งต่อไปยัง `/v1/calibration` ของ FastAPI แล้วคัดลอกค่าเดียวกันกลับมาเก็บไว้ในหน่วยความจำของเว็บเซิร์ฟเวอร์เพื่อใช้แปลงค่าทันที เมื่อเริ่มการฝึกครั้งใหม่ ค่าในหน่วยความจำจะถูกรีเซ็ตเป็นค่าเริ่มต้นเพื่อให้ผู้ใช้ calibrate ใหม่

**การเก็บข้อมูลใน MongoDB:** FastAPI เชื่อมต่อ MongoDB ด้วย Motor และสร้าง index ตอนเริ่มแอป ข้อมูลหลักแยกเก็บเป็น collection ดังนี้

- `telemetry_samples`: ข้อมูลเซนเซอร์ระหว่างบันทึก ลบอัตโนมัติเมื่อครบ 90 วัน
- `session_results`: ผลสรุปของแต่ละ session การฝึก
- `calibrations`: ค่า calibrate ล่าสุดของผู้ใช้แต่ละคน (1 รายการต่อผู้ใช้)

### 6.4.2 โค้ดและการทำงานของโค้ด

หัวข้อนี้แสดงโค้ดฝั่งเว็บเซิร์ฟเวอร์ที่รับค่าจาก ESP32 ทั้ง 2 ช่องทาง โค้ดยกมาจากโฟลเดอร์ `frontend/` โดยตรง บรรทัดที่ละไว้แสดงด้วย `// ...`

#### 6.4.2.1 การเปิดช่องทาง WebSocket บนเว็บเซิร์ฟเวอร์

route ปกติของ SvelteKit รับได้เฉพาะ HTTP ตอน production จึงใช้ไฟล์ `server.js` สร้าง http server เอง แล้วให้ server ตัวเดียวกันนี้ทำงานทั้ง 2 อย่าง คือส่ง request ปกติให้ SvelteKit และรับการเชื่อมต่อ WebSocket

```js
const server = createServer(handler);
server.on('connection', (socket) => socket.setNoDelay(true));
attachEmgWebSocket(server);
```

ดูโค้ดต้นฉบับ: [`server.js` บรรทัด 10–14](https://github.com/Fishcanwalk/muscle-activity-analyzer/blob/b1adde5/frontend/server.js#L10-L14)

`handler` คือตัวจัดการ request ของ SvelteKit ตัวเดิม ส่วน `attachEmgWebSocket()` มาจากไฟล์ `emg-ws.js` ตอนพัฒนา (`pnpm dev`) plugin ใน `vite.config.ts` เรียกฟังก์ชันเดียวกันนี้กับ dev server แทน

การเชื่อมต่อ WebSocket เริ่มจาก browser หรือบอร์ดส่ง HTTP request พิเศษมาขอเปลี่ยนเป็น WebSocket (upgrade) `emg-ws.js` จึงดักเหตุการณ์ `upgrade` ของ http server ไว้

```js
httpServer.on('upgrade', (req, socket, head) => {
  const url = new URL(req.url ?? '/', 'http://localhost');
  if (url.pathname !== PATH) return;
  /** @type {import('node:net').Socket} */ (socket).setNoDelay(true);
  wss.handleUpgrade(req, socket, head, (ws) => onConnection(ws, url));
});

async function onConnection(ws, url) {
  // ...
  if (url.searchParams.get('role') === 'device') handleDevice(ws);
  else handleViewer(ws);
}
```

ดูโค้ดต้นฉบับ: [`emg-ws.js` บรรทัด 39–60](https://github.com/Fishcanwalk/muscle-activity-analyzer/blob/b1adde5/frontend/emg-ws.js#L39-L60)

1. รับเฉพาะ request ที่ขอมาที่ `/ws/emg` ส่วน request อื่น เช่น WebSocket ของ Vite ที่ใช้รีโหลดหน้าเว็บตอนพัฒนา จะปล่อยให้ส่วนอื่นจัดการ
2. ปิดการรอรวม packet (`setNoDelay`) เพื่อให้ข้อมูลขนาดเล็กถูกส่งออกทันที
3. เมื่อเชื่อมต่อสำเร็จ จะดูพารามิเตอร์ `role` ถ้าเป็น `device` แปลว่าเป็นบอร์ด ESP32 ที่จะส่ง EMG เข้ามา (`handleDevice`) ถ้าไม่มีแปลว่าเป็น browser ที่จะรอรับ EMG ไปแสดงผล (`handleViewer`)

#### 6.4.2.2 การรับค่า EMG จาก ESP32 ผ่าน WebSocket

เมื่อบอร์ดส่งข้อความเข้ามา เช่น `2612,2618` ฟังก์ชัน `handleDevice()` จะแยกข้อความเป็นตัวเลข

```js
function handleDevice(ws) {
  ws.on('message', (data) => {
    const raws = String(data).split(',').map(Number).filter(Number.isFinite);
    if (raws.length > 0) bridge()?.ingestEmg(raws);
  });
}
```

ดูโค้ดต้นฉบับ: [`emg-ws.js` บรรทัด 78–83](https://github.com/Fishcanwalk/muscle-activity-analyzer/blob/b1adde5/frontend/emg-ws.js#L78-L83)

ข้อความถูกตัดตรงเครื่องหมายจุลภาคแล้วแปลงเป็นตัวเลข ค่าที่แปลงไม่ได้จะถูกทิ้ง ถ้าเหลือค่าอย่างน้อย 1 ค่าจึงส่งต่อให้ `ingestEmg()` ใน `telemetryStore.ts` ซึ่งเป็นที่เก็บสถานะสดของระบบ `emg-ws.js` อยู่นอกระบบ module ของ SvelteKit จึงเรียก `telemetryStore.ts` ผ่าน `bridge()` ซึ่งอ่านค่าจาก `globalThis.__cyberpumpEmg` แทนการ import

`ingestEmg()` แปลงค่าทั้งชุด แล้วส่งผลให้ browser ที่เชื่อมต่ออยู่

```ts
ingestEmg(raws: number[]) {
  const now = Date.now();
  const samples = this.ingestEmgSamples(raws, now);
  this.state.sensors.emg.lastSeen = now;
  const { level, rms, mvcPercent, isHighTension } = this.state.emg;
  this.broadcast('emgStream', {
    samples,
    level,
    rms,
    mvcPercent,
    isHighTension,
    emgRep: this.state.emgRep,
    lastSeen: now
  });
}
```

ดูโค้ดต้นฉบับ: [`telemetryStore.ts` บรรทัด 184–198](https://github.com/Fishcanwalk/muscle-activity-analyzer/blob/b1adde5/frontend/src/lib/server/telemetryStore.ts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)

- `lastSeen` บันทึกเวลาที่ได้รับ EMG ล่าสุด หน้าเว็บใช้ค่านี้บอกว่าเซนเซอร์ EMG ยังส่งข้อมูลอยู่หรือไม่
- `broadcast('emgStream', ...)` ส่ง event ภายในเซิร์ฟเวอร์ `handleViewer()` ใน `emg-ws.js` รับ event นี้แล้วส่งต่อให้ browser ทุกเครื่องเป็นข้อความ `type: "emg"` โดยส่งเฉพาะค่า EMG ชุดที่เพิ่งได้รับ (`samples`) ไม่ได้ส่งกราฟทั้งหมด

การแปลงค่าแต่ละตัวอยู่ใน `ingestEmgSamples()`

```ts
for (const raw of raws) {
  const unadjustedUv = adcToEmgUv(raw);
  levelSum += unadjustedUv;
  lastUv = unadjustedUv - emgBaseline;
  this.rawBuffer.shift();
  this.rawBuffer.push(round3(lastUv));
  fresh.push(round3(lastUv));

  this.envelopeWindow.push(Math.max(0, lastUv));
  if (this.envelopeWindow.length > EMG_ENVELOPE_WINDOW) this.envelopeWindow.shift();
  envelopeUv = this.envelopeWindow.reduce((sum, v) => sum + v, 0) / this.envelopeWindow.length;

  const pct = (envelopeUv / (emgMvc || 1)) * 100;
  if (pct > windowPeakPct) windowPeakPct = pct;
  const rep = this.emgRepDetector.push(pct, envelopeUv, EMG_SAMPLE_MS);
  if (rep) this.broadcast('emgRep', rep satisfies EmgRepEvent);
}
```

ดูโค้ดต้นฉบับ: [`telemetryStore.ts` บรรทัด 226–242](https://github.com/Fishcanwalk/muscle-activity-analyzer/blob/b1adde5/frontend/src/lib/server/telemetryStore.ts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)

ทุกค่า EMG ที่ได้รับจะผ่านขั้นตอนต่อไปนี้

1. แปลงค่า ADC (0–4095) เป็นแรงดันหน่วย µV แล้วลบค่า baseline ที่ได้จากการ calibrate ออก เหลือเฉพาะสัญญาณที่เกิดจากกล้ามเนื้อ
2. เก็บค่าลง `rawBuffer` ซึ่งเก็บค่าล่าสุดไว้ 150 ค่า โดยทิ้งค่าเก่าสุดออกหนึ่งค่าทุกครั้งที่เพิ่มค่าใหม่ และเก็บลง `fresh` ซึ่งเป็นรายการค่าใหม่ที่จะส่งให้ browser
3. หาค่า envelope ซึ่งเป็นค่าที่บอกว่าตอนนี้กล้ามเนื้อออกแรงมากหรือน้อย สัญญาณ EMG ดิบแกว่งขึ้นลงทั้งบวกและลบอย่างรวดเร็ว ถ้านำค่าดิบมาดูตรง ๆ จะบอกระดับแรงไม่ได้ ระบบจึงเปลี่ยนค่าที่ติดลบเป็น 0 แล้วหาค่าเฉลี่ยของ 10 ค่าล่าสุด (ช่วง 100 ms) ผลที่ได้เป็นเส้นเรียบที่สูงขึ้นเมื่อกล้ามเนื้อออกแรงมาก และลดลงเมื่อผ่อนแรง ในโค้ดเก็บค่านี้ไว้ในตัวแปร `envelopeUv` และ `rms`
4. เทียบ envelope กับค่า MVC (แรงสูงสุดของผู้ใช้จากการ calibrate) เป็นเปอร์เซ็นต์ เช่น 50% หมายถึงตอนนี้ออกแรงครึ่งหนึ่งของแรงสูงสุด
5. ส่งเปอร์เซ็นต์เข้าตัวนับ rep ทุกค่า ไม่ใช่แค่ค่าสุดท้ายของชุด จึงไม่พลาดจังหวะที่แรงขึ้นสูงแล้วลดลงภายในชุดเดียว เมื่อนับได้ 1 rep จะส่ง event `emgRep`

หลังจบลูป ระบบเก็บค่าสรุปของชุดนั้น เช่น envelope ล่าสุด (`rms`) เปอร์เซ็นต์ MVC และจำนวน rep ไว้ใน `state.emg` และ `state.emgRep` ค่าเหล่านี้ถูกใช้ตอนส่งต่อไป FastAPI ในรอบ POST ถัดไป (หัวข้อ 6.4.2.3)

#### 6.4.2.3 การรับค่าเซนเซอร์อื่นจาก ESP32 ผ่าน HTTP POST

ข้อมูล JSON ที่ NetworkTask ส่งมาทุก 100 ms เข้ามาที่ route `POST /api/telemetry`

```ts
export const POST: RequestHandler = async ({ request }) => {
  try {
    const body = await request.json() as FullTelemetryPacket;
    serverTelemetry.ingestFullTelemetry(body);

    return json({
      success: true,
      receivedAt: Date.now(),
      packetCount: serverTelemetry.state.device.packetCount,
      rateHz: serverTelemetry.state.device.rateHz,
      ...serverTelemetry.takeBoardCommands()
    });
  } catch (err: any) {
    return json({ success: false, error: err?.message || 'Invalid JSON' }, { status: 400 });
  }
};
```

ดูโค้ดต้นฉบับ: [`+server.ts` บรรทัด 12–27](https://github.com/Fishcanwalk/muscle-activity-analyzer/blob/b1adde5/frontend/src/routes/api/telemetry/+server.ts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)

1. อ่าน body เป็น JSON แล้วส่งให้ `ingestFullTelemetry()` อัปเดตค่าเซนเซอร์
2. คำตอบที่ส่งกลับไปให้บอร์ดมีจำนวน packet ที่ได้รับและอัตราการรับข้อมูล และมีคำสั่งจาก `takeBoardCommands()` ได้แก่ `fsrZero`, `fsrMax` และ `beep` ESP32 อ่านคำสั่งเหล่านี้ใน `applyServerReply()` (หัวข้อ 6.3.2.8)
3. ถ้า body ไม่ใช่ JSON ที่ถูกต้อง จะตอบกลับด้วยรหัส 400 บอร์ดยังส่งรอบถัดไปได้ตามปกติ

`ingestFullTelemetry()` อัปเดตค่าเซนเซอร์ทีละกลุ่ม ตัวอย่างนี้คือกลุ่ม FSR และส่วนท้ายของฟังก์ชัน

```ts
ingestFullTelemetry(data: FullTelemetryPacket) {
  const now = Date.now();
  this.recordPacket(data.board || 'esp32');

  if (data.fsr) {
    const gripPercent =
      data.fsr.force !== undefined
        ? round3(
            adcToGripPercent(
              data.fsr.force,
              this.state.calibration.fsrZero,
              this.state.calibration.fsrMax
            )
          )
        : this.state.fsr.gripPercent;
    // ...
    this.state.sensors.fsr.lastSeen = now;
  }
  // ...
  if (data.buttons?.a) this.broadcast('button', { id: 'a' });
  if (data.buttons?.b) this.broadcast('button', { id: 'b' });

  this.broadcast('telemetry', this.sseSnapshot());
  this.forwardToBackend();
}
```

ดูโค้ดต้นฉบับ: [`telemetryStore.ts` บรรทัด 265–323](https://github.com/Fishcanwalk/muscle-activity-analyzer/blob/b1adde5/frontend/src/lib/server/telemetryStore.ts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)

1. `recordPacket()` นับจำนวน packet และคำนวณอัตราการรับต่อวินาที ใช้บอกว่าบอร์ดยังเชื่อมต่ออยู่
2. ค่า FSR ถูกแปลงเป็นเปอร์เซ็นต์ของแรงบีบ โดยเทียบกับช่วง `fsrZero` (ไม่ได้บีบ) ถึง `fsrMax` (บีบแรงสุด) ที่ได้จากการ calibrate กลุ่ม MPU และ vitals ก็ทำแบบเดียวกัน คือถ้ามีค่าใหม่ส่งมาจะใช้ค่าใหม่ ถ้าไม่มีจะคงค่าเดิมไว้
3. ถ้ามีการกดปุ่ม A หรือ B จะส่ง event `button` ให้หน้าเว็บเปลี่ยนสถานะการฝึก
4. ส่งค่าเซนเซอร์ทั้งหมดยกเว้น EMG (`sseSnapshot()`) ให้ browser ผ่าน SSE แล้วเรียก `forwardToBackend()` ส่งข้อมูลต่อไป FastAPI เมื่อกำลังบันทึกอยู่ ข้อมูลที่ส่งต่อรวม `state.emg` ที่ได้จาก WebSocket (หัวข้อ 6.4.2.2) ไว้ด้วย

## 6.5 เส้นทางข้อมูลแบบครบวงจรและตัวอย่างโค้ดสำคัญ

เส้นทางข้อมูลหนึ่งรอบเริ่มจาก `ISR(TIMER1_COMPA_vect)` ของ Uno ตั้ง flag → ADC interrupt อ่าน A0/A1 → `Serial.print()` ส่งข้อความ → ESP32 `pollUnoLink()` parse บรรทัด → `SensorTask` แล้วแยกเป็น 2 ทาง

- EMG: `SensorTask` ใส่ค่าลง `emgQueue` → `EmgStreamTask` ต่อเป็นข้อความ → `emgSocket.sendTXT()` → `frontend/emg-ws.js` → `ingestEmg()` แปลงหน่วยและนับ rep → WebSocket `/ws/emg` ไปยัง browser
- เซนเซอร์อื่นและปุ่ม: `SensorTask` อัปเดต `SharedState` → `NetworkTask` สร้าง JSON → `http.POST(payload)` → frontend `ingestFullTelemetry()` → SSE และ `forwardToBackend()` (รวมสถานะ EMG ล่าสุด) → FastAPI insert MongoDB

ตัวอย่างจุดสำคัญที่ควรนำไปแสดงในรายงานฉบับเต็ม:

- การตั้ง Timer1 และ ADC ISR ใน `uno_emg_fsr_link.ino`
- การ parse `emg,fsr` และการอ่าน I2C ใน `esp32_workout_firmware.ino`
- การส่ง EMG ผ่าน WebSocket ใน EmgStreamTask และการสร้าง telemetry payload ใน NetworkTask
- WebSocket server ใน `frontend/emg-ws.js` และ `ingestEmg()` ใน `frontend/src/lib/server/telemetryStore.ts`
- การ broadcast event ใน `frontend/src/routes/api/telemetry/stream/+server.ts`
- การ insert ใน `backend/app/routers/telemetry.py`

ใช้ [`../flowchart.md`](../flowchart.md) Flowchart 1 เป็นรูปสรุปเส้นทางข้อมูล และ Flowchart 2-3 เป็นรายละเอียดฝั่งไมโครคอนโทรลเลอร์

แหล่งข้อมูล: โครงสร้างไฟล์ใน `backend/`, `frontend/` และ `test-sensor/arduino/`, `test-sensor/arduino/uno_emg_fsr_link/uno_emg_fsr_link.ino`, `test-sensor/arduino/esp32_workout_firmware/esp32_workout_firmware.ino`, `test-sensor/arduino/esp32_workout_firmware/board_config.h`, `PINS.md`, `TROUBLESHOOTING.md`, `frontend/emg-ws.js`, `frontend/server.js`, `frontend/src/routes/api/telemetry/`, `frontend/src/routes/api/recording/+server.ts`, `frontend/src/routes/api/calibration/+server.ts`, `frontend/src/lib/server/telemetryStore.ts`, `backend/app/`, `README.md`
