Fishcanwalk/muscle-activity-analyzer/report/chapter-02/chapter-02.md

# บทที่ 2 การออกแบบระบบ

## 2.1 ภาพรวมสถาปัตยกรรมและองค์ประกอบของระบบ

ระบบแบ่งเป็น 4 ชั้นหลัก

1. **ชั้นเซนเซอร์และเฟิร์มแวร์** — Uno อ่าน sEMG/FSR และ ESP32 รวมข้อมูลจาก Uno กับเซนเซอร์ I2C
2. **ชั้นรับข้อมูลของเว็บ** — SvelteKit รับ EMG ผ่าน WebSocket และเซนเซอร์อื่นผ่าน HTTP POST จาก ESP32 เก็บสถานะสดใน `telemetryStore` แล้วกระจาย EMG ด้วย WebSocket และข้อมูลอื่นด้วย SSE
3. **ชั้น API และฐานข้อมูล** — FastAPI ตรวจสอบ token รับ telemetry ผลเซสชัน และ calibration แล้วเก็บใน MongoDB
4. **ชั้นผู้ใช้** — หน้า Svelte แสดงค่าร่างกาย กราฟ สถานะอุปกรณ์ กล้อง และผลการฝึก

ภาพรวมการเชื่อมต่ออยู่ใน [`../flowchart.md`](../flowchart.md) Flowchart 1

## 2.2 ลำดับขั้นตอนและการไหลของข้อมูล

ในระดับออกแบบ ข้อมูลไหลผ่านระบบเป็นลำดับเดียวจากล่างขึ้นบน โดยแต่ละชั้นรับผิดชอบงานของตนเองแล้วส่งต่อให้ชั้นถัดไป

1. เซนเซอร์ sEMG และ FSR ต่อกับ Uno ซึ่งอ่านค่าและส่งต่อให้ ESP32 ผ่านลิงก์อนุกรมระหว่างบอร์ด
2. ESP32 รวมค่าจาก Uno เข้ากับเซนเซอร์ I2C ของตัวเอง แล้วประกอบเป็น telemetry ชุดเดียว
3. ESP32 ส่ง EMG ให้ frontend ทาง WebSocket ทุก 20 ms และส่งเซนเซอร์อื่นทาง HTTP ทุก 100 ms frontend อัปเดตสถานะสดแล้วกระจายต่อให้ผู้ใช้ผ่าน WebSocket (EMG) และ SSE (เซนเซอร์อื่น)
4. frontend ส่งต่อ telemetry ให้ FastAPI เพื่อตรวจสอบสิทธิ์และบันทึกลง MongoDB

รายละเอียดการอ่านสัญญาณ การตั้งเวลา และรูปแบบข้อความจริงในแต่ละขั้นตอนอยู่ในบทที่ 6 (โครงสร้างและการทำงานของโค้ด) ให้ใช้ [`../flowchart.md`](../flowchart.md) Flowchart 1 เป็นรูปประกอบหัวข้อนี้

## 2.3 การออกแบบขั้นตอนประมวลผล

หลักการออกแบบคือแบ่งงานตามความเร่งด่วน เพื่อไม่ให้งานที่ต้องสม่ำเสมอ เช่น การอ่านสัญญาณเซนเซอร์ ถูกผูกกับความเร็วของงานที่ไม่แน่นอน เช่น การส่งเครือข่ายหรือการแสดงผล

- ฝั่งไมโครคอนโทรลเลอร์แยกงานอ่านสัญญาณที่ต้องตรงเวลาออกจากงานสื่อสารและงานแสดงผลบนจอ
- ฝั่งเว็บเมื่อได้รับข้อมูลจาก ESP32 จะแปลงหน่วยและคำนวณค่าที่ใช้แสดงผลก่อน แล้วจึงส่งต่อให้ผู้ใช้ผ่าน WebSocket และ SSE ขั้นตอนนี้ทำแบบไม่รอ (non-blocking) เพื่อให้เว็บยังรับข้อมูลชุดถัดไปที่ส่งเข้ามาต่อเนื่องได้ตามปกติ ไม่ค้างรอจนข้อมูลใหม่ตกหล่น

รายละเอียดการแบ่ง task การตั้งเวลา และกลไกแชร์ข้อมูลระหว่าง task ของ ESP32 อยู่ในหัวข้อ 6.3

## 2.4 การออกแบบส่วนติดต่อผู้ใช้

ส่วนติดต่อผู้ใช้แบ่งเป็นหน้าความพร้อม หน้า live studio หน้าสรุปหลังจบเซต หน้า analytics และหน้าปรับเทียบ โดยข้อมูลสดมาจาก WebSocket (EMG) และ SSE (เซนเซอร์อื่น) และถูกเก็บใน state ของ frontend

หน้า live studio แสดงค่าหลัก เช่น EMG, FSR, MPU, HR, SpO2, อุณหภูมิ และสถานะการเชื่อมต่อ นอกจากนี้ยังมีการรับข้อมูลกล้องเพื่อคำนวณมุมข้อศอก การโกงท่า และจำนวนครั้ง ส่วนการบันทึกข้อมูลสามารถเริ่ม/หยุดและส่งออกเป็น JSON หรือ CSV ได้

ปุ่มจริงบน ESP32 ถูกส่งเป็น event ผ่าน telemetry แล้ว frontend แปลงให้ทำงานเหมือนปุ่มบนหน้าเว็บ ทำให้ผู้ใช้ควบคุมเซตได้โดยไม่ต้องอยู่หน้าอุปกรณ์ตลอดเวลา

แหล่งข้อมูล: `README.md`, `backend/app/main.py`, `frontend/src/routes/api/`, `test-sensor/arduino/`, `frontend/src/lib/server/telemetryStore.ts`, `frontend/src/lib/workout/`, `frontend/src/lib/components/workout/`, `frontend/src/routes/api/telemetry/stream/+server.ts`, `PINS.md`
