Fishcanwalk/muscle-activity-analyzer/report/chapter-07/chapter-07.md

# บทที่ 7 การทดสอบและผลลัพธ์

## 7.1 วัตถุประสงค์ วิธีการ และสภาพแวดล้อมการทดสอบ

การทดสอบมุ่งตรวจสอบ 4 เรื่อง คือ การอ่านค่าเซนเซอร์ การสื่อสารระหว่าง Uno กับ ESP32 การส่งข้อมูลเข้าสู่เว็บ/API และการแสดงผลหรือบันทึกข้อมูลตามเซสชัน

สภาพแวดล้อมที่ระบุในเอกสารโครงการประกอบด้วย Arduino Uno, ESP32 DevKit, เซนเซอร์ที่ต่อผ่าน ADC/UART/I2C, MongoDB ผ่าน Docker, FastAPI backend และ SvelteKit frontend การทดสอบการสื่อสารใช้ Serial monitor, I2C scanner และ diagnostic raw echo ตามบันทึก troubleshooting

วิธีทดสอบควรเริ่มจากแยกส่วน: ตรวจ Uno ส่งข้อความได้ก่อน จากนั้นตรวจ ESP32 รับ UART และอ่าน I2C ต่อด้วยตรวจ WebSocket ของ EMG และ POST ของเซนเซอร์อื่นเข้า frontend, WebSocket และ SSE ไป browser และการบันทึกเข้า backend เพื่อให้แยกสาเหตุได้เมื่อเกิดข้อผิดพลาด

## 7.2 กรณีทดสอบและเกณฑ์ประเมินผล

| กรณี | วิธีตรวจ | เกณฑ์ผ่าน |
|---|---|---|
| Uno อ่าน ADC | เปลี่ยนสัญญาณที่ A0/A1 และดูข้อความ UART | ได้คู่ค่า `emg,fsr` ต่อเนื่องและรูปแบบถูกต้อง |
| UART Uno-ESP32 | ต่อผ่าน voltage divider และดู log ESP32 | ESP32 parse ค่าได้ ไม่ค้างที่ศูนย์ |
| Timer/ADC | ตรวจความต่อเนื่องของข้อมูลและรอบอ่าน | ไม่มีการหยุดยาวจน watchdog reset |
| I2C | ใช้ scanner และตรวจ log ตอนเริ่มระบบ | พบ address ของอุปกรณ์ที่ต่ออยู่ |
| HTTP telemetry | ตรวจ response ของ `/api/telemetry` | ได้ JSON response ที่มี `fsrZero`/`fsrMax`/`beep` และ packet count เพิ่ม |
| EMG WebSocket | จำลองบอร์ดส่ง frame เข้า `/ws/emg?role=device` และดู Serial Monitor ของ ESP32 | browser ได้ `init` และ `emg` ครบทุก frame นับ rep ได้ และ ESP32 ขึ้น `[EMG-WS] connected` |
| SSE | เปิดหน้า dashboard และถอด/ต่อ network | สถานะเปลี่ยนและ reconnect ได้ โดย SSE ไม่มี EMG แล้ว |
| Authentication | เรียก endpoint แบบมี/ไม่มี token | endpoint ส่วนตัวปฏิเสธ request ที่ไม่มี token |
| Calibration | GET/POST calibration ของผู้ใช้ | ค่าถูกบันทึกและสะท้อนใน live conversion |
| Session result | จบเซตและบันทึกผล | ผลถูกสร้างและค้นย้อนหลังได้ |

เกณฑ์นี้เป็นกรอบสำหรับทดสอบจากโค้ดและ endpoint ที่มีอยู่ ไม่ใช่ผลการรับรองความแม่นยำของเซนเซอร์

## 7.3 ผลการทดสอบและตัวอย่างผลลัพธ์

จาก `TROUBLESHOOTING.md` มีผลการทดสอบหน้างานที่บันทึกไว้ดังนี้

- Uno อ่าน sEMG และ FSR ได้ และส่งข้อมูลออกทาง TX
- การตรวจด้วย raw echo พบว่าลิงก์มี byte เข้ามา แต่ช่วงแรกหยุดที่ 1 byte จนแก้จุดต่อ voltage divider ให้แน่น
- หลังแก้การต่อสายและเปลี่ยนมาใช้ Hardware Serial ของ Uno ข้อมูลรูปแบบ `<emg>,<fsr>\r\n` เข้ามาต่อเนื่อง
- การตรวจ I2C ใช้แยกปัญหา bus รวมกับปัญหาเฉพาะอุปกรณ์ได้ โดยกรณีที่พบอุปกรณ์อื่นแต่ไม่พบ MLX90614 ชี้ไปที่สายของ MLX90614
- การตั้ง baud ของ Serial monitor ต้องตรงกับอุปกรณ์ มิฉะนั้นจะเห็นข้อความเพี้ยน

สำหรับฝั่งเว็บและ backend โค้ดมีเส้นทางรับ telemetry, WebSocket, SSE, authentication, calibration, session result และ MongoDB index ครบตามที่ออกแบบไว้ แต่รายงานนี้ไม่เพิ่มตัวเลขผลการทดสอบที่ไม่ได้บันทึกไว้ในแหล่งข้อมูล

## 7.4 การวิเคราะห์ผลและข้อจำกัดที่พบ

ผลจากการแก้ปัญหา UART แสดงว่าระบบมีความไวต่อทั้งการเลือกขา การใช้พอร์ตเดียวกันระหว่าง USB กับลิงก์บอร์ด และคุณภาพจุดต่อ voltage divider จึงควรทดสอบ hardware link แยกจากการทดสอบ parser

การใช้ I2C bus ร่วมกันทำให้การตรวจด้วย address scanner มีประโยชน์มาก หากอุปกรณ์หายเพียงตัวเดียวควรตรวจสายและไฟเลี้ยงเฉพาะตัวนั้นก่อน แต่ถ้าหายพร้อมกันหลายตัวควรตรวจ SDA/SCL และ ground รวม

ข้อจำกัดของผลการทดสอบคือเอกสารที่ใช้ไม่ได้ระบุชุดข้อมูลอ้างอิงสำหรับวัดความแม่นยำของ EMG, FSR, HR หรือ SpO2 ดังนั้นผลที่สรุปได้ในบทนี้เป็นผลด้านการทำงานและการเชื่อมต่อ ไม่ใช่ผล validation ทางกายภาพ

แหล่งข้อมูล: `README.md`, `PINS.md`, `TROUBLESHOOTING.md`, โค้ดในสองโฟลเดอร์ Arduino และ `backend/`, `frontend/`, `backend/app/routers/`, `frontend/src/routes/api/`
