Fishcanwalk/muscle-activity-analyzer/report/chapter-04/chapter-04.md

# บทที่ 4 ข้อมูลจากเซนเซอร์

## 4.1 กล้องและเซนเซอร์ที่ใช้: ค่าที่อ่านโดยตรง ช่วงค่า และหน่วย

| อุปกรณ์ | วิธีรับข้อมูล | ค่าที่เกี่ยวข้อง | ช่วง/หน่วยตามโค้ด |
|---|---|---|---|
| sEMG | Uno ADC A0 | ค่าดิบของสัญญาณไฟฟ้ากล้ามเนื้อ (raw EMG) | Uno อ่านได้ 0-1023 (10-bit) แล้วแปลงเป็น 0-4095 (12-bit) ก่อนส่งออก |
| FSR | Uno ADC A1 | ค่าดิบแรงกด ใช้คำนวณแรงกำเป็นเปอร์เซ็นต์ (grip percent) และความนิ่งของแรงกำ (stability) | Uno อ่านได้ 0-1023 (10-bit) แล้วกลับด้านค่า (เพราะเซนเซอร์อ่านค่าสูงตอนไม่ได้กด) ก่อนแปลงเป็น 0-4095 (12-bit) |
| MPU6050/MPU6500 | ESP32 I2C address 0x68 | ความเร็วในการยกแนวดิ่ง (velocity) และความเร็วสูงสุดนับตั้งแต่ส่งข้อมูลครั้งก่อน (peakVelocity) | เป็นค่าที่คำนวณจากการอินทิเกรตความเร่ง 3 แกน (ax, ay, az) ที่ตั้งช่วงไว้ที่ ±8g ภายในเฟิร์มแวร์ ไม่ได้วัดได้โดยตรงและไม่ได้ส่งค่าความเร่งหรือมุม pitch/roll ออกมาใน telemetry |
| MAX30102 | ESP32 I2C address 0x57 | อัตราการเต้นหัวใจ (HR) และค่าออกซิเจนในเลือด (SpO2) | HR มีหน่วยเป็นครั้งต่อนาที (BPM); SpO2 เป็นเปอร์เซ็นต์ที่คำนวณแบบประมาณการ ไม่ใช่ค่าทางการแพทย์ |
| MLX90614 | ESP32 I2C address 0x5A | อุณหภูมิผิวหนัง (skin temperature) และผลต่างอุณหภูมิ (delta temperature) | หน่วยเป็นองศาเซลเซียส |
| กล้อง | browser video | มุมข้อศอก (elbow angle), มุมลำตัว (torso angle), การยกไหล่ผิดท่า (shoulder hike), ระดับการเคลื่อนไหว (motion) | มุมมีหน่วยเป็นองศา ระยะมีหน่วยเป็นเซนติเมตร และระดับการเคลื่อนไหวอยู่ในช่วง 0-100 |

ขา I2C หลักของ ESP32 คือ SDA GPIO21 และ SCL GPIO22 ตาม `PINS.md` และ `board_config.h` ส่วน Uno ใช้ A0/A1 สำหรับสัญญาณอนาล็อก

## 4.2 อัตราการอ่าน การปรับเทียบ และค่าที่คำนวณต่อ

อัตราการอ่านของแต่ละอุปกรณ์ต่างกันตามความจำเป็น: สัญญาณ sEMG และ FSR ต้องอ่านถี่และสม่ำเสมอที่สุด รองลงมาคือเซนเซอร์ I2C บน ESP32 ส่วนการส่งข้อมูลเข้าเว็บและการอัปเดตจอทำงานช้ากว่าและไม่ผูกกับรอบอ่านเซนเซอร์โดยตรง รายละเอียดการตั้ง Timer1 ของ Uno และการแบ่ง task ตามรอบเวลาของ ESP32 อยู่ในหัวข้อ 6.2 และ 6.3

ค่าที่ปรับเทียบต่อผู้ใช้ผ่านหน้าปรับเทียบของเว็บ (`emgBaseline`, `emgMvc`, `fsrZero`, `fsrMax`) ถูกใช้ในสูตรของ sEMG และ FSR ด้านล่าง

- **sEMG** — อ่านค่าดิบจาก ADC แล้วแปลงเป็นแรงดัน: `mv = (raw/4095) * Vref` จากนั้น `µV = mv*1000/gain - emgBaseline` (ลบค่า baseline จากการปรับเทียบ) นำค่าที่ตัดส่วนติดลบทิ้งมาเฉลี่ยแบบ moving average ได้เป็นค่า **RMS/envelope** แล้วคำนวณ **MVC percent** = `(RMS / emgMvc) * 100` ใช้ตัดสินว่าออกแรงถึงเกณฑ์ที่นับเป็นการยกหนึ่งครั้งหรือไม่ (high-tension)
- **FSR** — อ่านค่าดิบจาก ADC (ที่ถูกกลับด้านและ scale มาจาก Uno แล้ว) แปลงเป็น **grip percent** = `(raw - fsrZero) / (fsrMax - fsrZero) * 100` ตามค่าปรับเทียบต่อผู้ใช้ และคำนวณ **ความนิ่งของแรงกำ (stability)** จากช่วงค่าสูงสุด-ต่ำสุดใน 20 ตัวอย่างล่าสุด ด้วย `100 - (range/200) * 100` ใช้ตัดสินสถานะจับมั่นคง (>75%) และสั่งเตือนผ่าน buzzer เมื่อแรงกำหลุดหรือไม่นิ่ง
- **MPU6050/MPU6500** — อ่านความเร่ง 3 แกน (ax, ay, az) แล้วกรองหาทิศทาง "ขึ้น" ด้วย complementary filter (ผสมค่าจากไจโรกับ accelerometer) นำความเร่งในแนวขึ้นลบด้วย 1g มาอินทิเกรตตามเวลาเป็น **velocity** พร้อม decay factor ลดค่าตกค้างจาก drift ทุกรอบ ใช้แสดงความเร็วยกและดู velocity loss ระหว่างเซต ส่วน **peakVelocity** คือค่าสูงสุดที่ทำได้นับตั้งแต่ส่งข้อมูลครั้งก่อน
- **MAX30102 (HR)** — ตรวจจับจังหวะหัวใจจากค่า IR ด้วย beat-detection แล้วคำนวณ `bpm = 60 / ช่วงเวลาระหว่างจังหวะ (วินาที)` กรองค่าผิดปกติออก (รับเฉพาะ 40-220 BPM) แล้วเฉลี่ยจาก 4 จังหวะล่าสุดเป็น **HR** ที่แสดงผล
- **MAX30102 (SpO2)** — สะสมค่า IR และ Red เป็นหน้าต่างประมาณ 200 ตัวอย่าง (~2 วินาที) หาค่า AC (สูงสุด-ต่ำสุด) และ DC (ค่าเฉลี่ยสูงสุด-ต่ำสุด) ของแต่ละสี คำนวณอัตราส่วน `ratio = (redAC/redDC) / (irAC/irDC)` แล้วประมาณ **SpO2** = `110 - 25*ratio` (จำกัดช่วง 70-100%) เป็นค่าประมาณ ไม่ใช่ค่าทางการแพทย์
- **MLX90614** — อ่านอุณหภูมิผิว (skinTemp) ต่อเนื่อง แล้วเทียบกับอุณหภูมิพื้นฐานที่บันทึกไว้ตอนบูตเครื่อง (skinTempBaseline) ได้เป็น **deltaTemp** = `skinTemp - skinTempBaseline` ใช้ดูว่าอุณหภูมิผิวเปลี่ยนไปจากตอนเริ่มเซสชันมากน้อยเพียงใด

แหล่งข้อมูล: `PINS.md`, `README.md`, `test-sensor/arduino/esp32_workout_firmware/`, `test-sensor/arduino/uno_emg_fsr_link/`, `frontend/src/lib/workout/`, `frontend/src/lib/server/telemetryStore.ts`, `frontend/src/lib/workout/calibration.svelte.ts`, `backend/app/models/telemetry.py`, `frontend/src/lib/workout/telemetry.svelte.ts`, `frontend/src/lib/workout/cameraRepCounter.svelte.ts`
