Fishcanwalk/muscle-activity-analyzer/report/chapter-08/chapter-08.md

# บทที่ 8 ปัญหาที่พบและวิธีแก้ไข

## 8.1 ปัญหาที่พบระหว่างการพัฒนาและการทดสอบ

ปัญหาที่บันทึกไว้ใน `TROUBLESHOOTING.md` ได้แก่ serial log เพี้ยนหลังบูต, ตั้ง baud ของ monitor ไม่ตรง, ไม่พบอุปกรณ์ I2C, MLX90614 หายเฉพาะตัว, ESP32 เข้าโหมด flash ไม่สำเร็จ และ Uno-ESP32 UART ไม่มีข้อมูล

ปัญหา UART มีรายละเอียดหลายชั้น ทั้งการใช้ขาไม่ตรงกับสายจริง จุดต่อ voltage divider หลวม และผลข้างเคียงจากการเปลี่ยน Uno ไปใช้ pin 0/1 ซึ่งชนกับ USB serial และการอัปโหลดโปรแกรม

นอกจากนี้ `PINS.md` ยังมีข้อความบางส่วนที่ระบุการใช้ pin 2/3 แบบ SoftwareSerial ไม่ตรงกับโค้ดปัจจุบันที่ใช้ Hardware Serial pin 0/1 จึงเป็นปัญหาด้านความสอดคล้องของเอกสารด้วย

## 8.2 สาเหตุและผลกระทบของแต่ละปัญหา

| ปัญหา | สาเหตุ | ผลกระทบ |
|---|---|---|
| log หลังบูตเพี้ยน | UART และ boot log ชนกันก่อน hardware settle | อ่าน log ช่วงเริ่มต้นไม่ได้ |
| monitor เพี้ยนทั้งหน้าจอ | baud ของ monitor เป็น 9600 แต่ ESP32 ส่ง 115200 | ข้อมูลถูก decode ผิดทั้งหมด |
| I2C หายหลายตัว | SDA/SCL หรือ ground มีปัญหา | เซนเซอร์ทั้ง bus ใช้ไม่ได้ |
| MLX90614 หายตัวเดียว | สายหรือไฟเลี้ยงของ MLX90614 หลวม | อุณหภูมิเป็นศูนย์หรือไม่อัปเดต |
| upload ESP32 ไม่ผ่าน | auto-reset/boot mode ไม่เสถียร | อัปโหลด firmware ไม่สำเร็จ |
| UART ไม่มีข้อมูล | ขาโค้ดไม่ตรงสาย, จุดต่อ divider หลวม, ใช้พอร์ตชนกับ USB | ESP32 parse ไม่ได้และ FSR ค้างที่ศูนย์ |
| เอกสาร pin ไม่ตรงโค้ด | เอกสารเดิมยังอ้าง SoftwareSerial | ต่อวงจรหรือ debug ผิดจุดได้ |

## 8.3 วิธีที่ใช้แก้ไขและเหตุผลที่เลือกวิธีนั้น

- เพิ่ม delay หลัง `Serial.begin()` ของ ESP32 เพื่อให้ UART settle ก่อนพิมพ์ log
- ระบุ environment หรือ baud ให้ `pio device monitor` ตรงกับ firmware
- ตรวจและต่อ SDA/SCL ใหม่ แล้วใช้ I2C scanner ยืนยัน address
- ตรวจ VCC/SDA/SCL ของ MLX90614 แยกจากอุปกรณ์อื่นเมื่ออุปกรณ์อื่นยังพบปกติ
- ใช้ขั้นตอนกด BOOT และ EN/RESET ด้วยมือเมื่อ auto-reset เข้า download mode ไม่สำเร็จ
- เปลี่ยน Uno ให้ใช้ Hardware Serial pin 0/1 ให้ตรงกับการต่อสายจริง และถอดสายก่อน upload
- กดจุดต่อ R1/R2 ของ voltage divider ให้แน่น แล้วใช้ raw echo ตรวจ byte ก่อนตรวจ parser

เหตุผลร่วมของวิธีเหล่านี้คือแยกตรวจทีละชั้น ตั้งแต่ physical link, baud/address, byte stream, parser และการทำงานของระบบ เพื่อไม่แก้ปัญหาผิดชั้น

## 8.4 ผลหลังแก้ไขและปัญหาที่ยังเหลืออยู่

หลังแก้การต่อสายและจุดต่อ voltage divider พบว่า byte counter วิ่งต่อเนื่องและข้อมูล `<emg>,<fsr>\r\n` เข้ามาได้ถูกต้อง การใช้ Hardware Serial ทำให้โค้ดตรงกับการต่อจริง แต่ทำให้ไม่สามารถใช้ USB serial monitor ของ Uno พร้อมกับการต่อ ESP32 บน pin เดียวกันได้

ปัญหาที่เหลือคือ `PINS.md` ยังต้องอัปเดตส่วน UART ให้ตรงกับโค้ดปัจจุบัน และการใช้งาน pin 0/1 ต้องมีขั้นตอนถอดสายก่อน upload ทุกครั้ง นอกจากนี้เอกสารบางส่วนใน `README.md` ยังอ้างชื่อไฟล์หรือโครงสร้างเดิม จึงควรตรวจให้ตรงกับโฟลเดอร์ Arduino ปัจจุบันก่อนนำไปใช้เป็นคู่มือปฏิบัติ

แหล่งข้อมูล: `TROUBLESHOOTING.md`, `PINS.md`, `test-sensor/arduino/`, `README.md`
