Fishcanwalk/muscle-activity-analyzer/report/FIRMWARE_REPORT.docx

คำนำ

รายงานฉบับนี้จัดทำขึ้นเพื่ออธิบายการพัฒนาระบบ muscle-activity-analyzer ตั้งแต่การรับค่าจากเซนเซอร์ การประมวลผลบน Arduino Uno และ ESP32 การส่งข้อมูลผ่านเว็บ ไปจนถึงการจัดเก็บและแสดงผลบนแดชบอร์ด

เนื้อหาแบ่งตามโครงสร้างใน report/structure.md และแยกแต่ละข้อเป็นไฟล์ Markdown เพื่อให้ผู้พัฒนาสามารถแก้ไขเฉพาะส่วนได้ง่าย ส่วนที่ระบุว่าเป็น flowchart จะอ้างอิงไปยัง report/flowchart.md ซึ่งเขียนด้วย Mermaid สำหรับนำไปสร้างภาพภายหลัง

แหล่งข้อมูลของรายงานจำกัดอยู่ที่โค้ดในโฟลเดอร์เฟิร์มแวร์ test-sensor/arduino/esp32_workout_firmware/, test-sensor/arduino/uno_emg_fsr_link/, โค้ด backend/, frontend/ และเอกสาร PINS.md, README.md, TROUBLESHOOTING.md

บทคัดย่อ

โครงงานนี้พัฒนาระบบติดตามการออกกำลังกายที่รวมข้อมูลจาก sEMG, FSR, MPU6050/MPU6500, MAX30102 และ MLX90614 เข้าด้วยกัน โดย Arduino Uno อ่านค่า sEMG และ FSR ผ่าน ADC แล้วส่งข้อมูลให้ ESP32 ด้วย UART ส่วน ESP32 อ่านเซนเซอร์ I2C ประมวลผลเบื้องต้น และส่ง telemetry ผ่าน Wi-Fi ไปยังเว็บแอป

ฝั่งเว็บรับข้อมูลแบบสดด้วย SvelteKit กระจายข้อมูลผ่าน Server-Sent Events (SSE) และส่งข้อมูลที่เหมาะสมต่อไปยัง FastAPI เพื่อเก็บใน MongoDB ระบบยังรองรับการเริ่มและหยุดบันทึก การปรับเทียบเซนเซอร์ การสรุปผลรายเซต และการส่งออกข้อมูลเป็น CSV หรือ JSON

ผลลัพธ์ของการพัฒนาคือโครงสร้างการทำงานที่แยกหน้าที่ชัดเจนระหว่างอุปกรณ์อ่านเซนเซอร์ เว็บ และ API อย่างไรก็ตาม ค่าบางส่วน เช่น SpO2 และแรงจาก FSR เป็นค่าประมาณ จึงควรใช้เพื่อดูแนวโน้มการฝึก ไม่ใช่การวัดทางการแพทย์หรือการสอบเทียบห้องปฏิบัติการ

สารบัญ

เนื้อหา หน้า

คำนำ

บทคัดย่อ

สารบัญ

สารบัญรูปและตาราง

บทที่ 1 บทนำ

1.1 ที่มาและความสำคัญของปัญหา

1.2 ปัญหาที่ต้องการแก้ไข

1.3 วัตถุประสงค์ของโครงงาน

1.4 ขอบเขตของระบบและงานที่ดำเนินการ

บทที่ 2 ความต้องการและงานที่เกี่ยวข้อง

2.1 กลุ่มผู้ใช้และลักษณะการใช้งาน

2.2 ข้อมูลที่ระบบรับเข้า ประมวลผล และแสดงผล

2.3 ความต้องการด้านการทำงานและข้อกำหนดอื่นของระบบ

2.4 แนวคิด เครื่องมือ หรืองานที่เกี่ยวข้อง

บทที่ 3 การออกแบบระบบ

3.1 ภาพรวมสถาปัตยกรรมและองค์ประกอบของระบบ

3.2 ลำดับขั้นตอนและการไหลของข้อมูล

3.3 การออกแบบขั้นตอนประมวลผล

3.4 การออกแบบส่วนติดต่อผู้ใช้

บทที่ 4 การพัฒนา

4.1 ภาษา เครื่องมือ และสภาพแวดล้อมที่ใช้พัฒนา

4.1.1 รายการอุปกรณ์และวัสดุ

4.2 โครงสร้างซอฟต์แวร์และหน้าที่ของส่วนประกอบหลัก

4.3 การพัฒนาฟังก์ชันหลักและการเชื่อมต่อระหว่างส่วนประกอบ

บทที่ 5 ข้อมูลจากเซนเซอร์

5.1 กล้องและเซนเซอร์ที่ใช้: ค่าที่อ่านโดยตรง ช่วงค่า และหน่วย

5.2 อัตราการอ่าน การปรับเทียบ และค่าที่คำนวณต่อ

5.3 ฟิลด์ข้อมูลที่ส่งออกและข้อจำกัดของค่าประมาณ

บทที่ 6 การจัดเก็บข้อมูลและการนำไปใช้

6.1 ภาพรวมข้อมูลสด ข้อมูลที่บันทึก และความสัมพันธ์ของข้อมูล

6.2 Collections และฟิลด์สำคัญ

6.3 เก็บข้อมูลแต่ละประเภทเพื่อใช้ทำอะไร และส่วนใดของระบบเรียกใช้จริง

6.4 ตัวอย่างเอกสาร ดัชนี การค้นคืน และอายุข้อมูล

บทที่ 7 โครงสร้างและการทำงานของโค้ด

7.1 แผนผัง codebase และหน้าที่ของเฟิร์มแวร์ เว็บ และ API

7.2 Arduino Uno: Timer1, ADC Interrupt, Watchdog และ UART

7.3 ESP32: FreeRTOS, Hardware Timer, GPIO Interrupt, Watchdog, I2C และการส่งข้อมูล

7.4 เว็บและเซิร์ฟเวอร์: รับ telemetry, กระจาย SSE, เริ่ม/หยุดบันทึก, ส่งต่อ FastAPI และเก็บ MongoDB

7.5 เส้นทางข้อมูลแบบครบวงจรและตัวอย่างโค้ดสำคัญ

บทที่ 8 การทดสอบและผลลัพธ์

8.1 วัตถุประสงค์ วิธีการ และสภาพแวดล้อมการทดสอบ

8.2 กรณีทดสอบและเกณฑ์ประเมินผล

8.3 ผลการทดสอบและตัวอย่างผลลัพธ์

8.4 การวิเคราะห์ผลและข้อจำกัดที่พบ

บทที่ 9 ปัญหาที่พบและวิธีแก้ไข

9.1 ปัญหาที่พบระหว่างการพัฒนาและการทดสอบ

9.2 สาเหตุและผลกระทบของแต่ละปัญหา

9.3 วิธีที่ใช้แก้ไขและเหตุผลที่เลือกวิธีนั้น

9.4 ผลหลังแก้ไขและปัญหาที่ยังเหลืออยู่

บทที่ 10 สรุปและแนวทางพัฒนา

10.1 สรุปสิ่งที่พัฒนาและผลที่ได้เทียบกับวัตถุประสงค์

10.2 ข้อจำกัดของโครงงาน

10.3 แนวทางพัฒนาต่อ

เอกสารอ้างอิง

ภาคผนวก

หมายเหตุ: เลขหน้าจะปรับอีกครั้งหลังเพิ่มหน้าปกและรูปภาพในฉบับจัดเล่มจริง

สารบัญรูปและตาราง

ฉบับนี้เว้นพื้นที่รูปภาพไว้สำหรับผู้จัดทำเพิ่มภายหลัง ตามรูปแบบในเอกสารตัวอย่าง โดยตำแหน่งรูปที่ควรเพิ่มจะระบุไว้ในเนื้อหาและใน report/flowchart.md

รายการนี้เป็นรายการตั้งต้นสำหรับการจัดรูปเล่มจริง เลขหน้าและหมายเลขรูปให้เติมหลังจากนำ Mermaid ไปสร้างภาพและรวมเอกสารแล้ว

รูปที่ควรมี

รายการ | ชื่อรูป | แหล่งข้อมูล | จุดแทรกแนะนำ
รูปที่ 1 | การไหลของข้อมูลจาก Uno ถึง MongoDB | report/flowchart.md Flowchart 1 | ข้อ 3.2
รูปที่ 2 | รอบการอ่าน ADC ของ Arduino Uno | report/flowchart.md Flowchart 2 | ข้อ 7.2
รูปที่ 3 | งานและการเชื่อมต่อของ ESP32 | report/flowchart.md Flowchart 3 | ข้อ 7.3
รูปที่ 4 | หน้าจอแดชบอร์ดและสถานะเซนเซอร์ | frontend/src/lib/components/workout/ | ข้อ 3.4

ตารางที่ควรมี

รายการ | ชื่อตาราง | จุดแทรกแนะนำ
ตารางที่ 1 | การกำหนดขาและอุปกรณ์ | ข้อ 5.1
ตารางที่ 2 | อัตราการอ่านและช่วงเวลาของงาน | ข้อ 5.2
ตารางที่ 3 | ฟิลด์ telemetry ที่ส่งออก | ข้อ 5.3
ตารางที่ 4 | Collections และดัชนี MongoDB | ข้อ 6.2 และ 6.4
ตารางที่ 5 | กรณีทดสอบระบบ | ข้อ 8.2
ตารางที่ 6 | รายการอุปกรณ์และวัสดุ | ข้อ 4.1

บทที่ 1

บทนำ

1.1 ที่มาและความสำคัญของปัญหา

การฝึกเวทต้องพิจารณามากกว่าจำนวนครั้ง เช่น รูปแบบการเคลื่อนไหว ระยะการเคลื่อนไหว ความเร็ว และการตอบสนองของกล้ามเนื้อ ระบบในโครงงานจึงรวมข้อมูลจากกล้องและเซนเซอร์หลายชนิด เพื่อให้ผู้ฝึกเห็นข้อมูลระหว่างทำเซตและใช้ข้อมูลสรุปประกอบการประเมินการฝึก

ความสำคัญของระบบอยู่ที่การรวมข้อมูลหลายแหล่งเข้าด้วยกันในเวลาจริง โดยแยกการอ่านสัญญาณที่ต้องใช้เวลาคงที่บนไมโครคอนโทรลเลอร์ออกจากการแสดงผลและการจัดเก็บบนเว็บ ทำให้แต่ละส่วนดูแลและทดสอบได้เป็นอิสระมากขึ้น

แหล่งข้อมูล: README.md, test-sensor/arduino/esp32_workout_firmware/, test-sensor/arduino/uno_emg_fsr_link/

1.2 ปัญหาที่ต้องการแก้ไข

ปัญหาหลักคือข้อมูลจากเซนเซอร์มีรูปแบบและอัตราการอ่านต่างกัน ข้อมูล sEMG และ FSR ต้องอ่านถี่และต่อเนื่อง ขณะที่ข้อมูลอุณหภูมิเปลี่ยนช้ากว่า ส่วนข้อมูลจาก IMU และสัญญาณชีพต้องอ่านจากบัส I2C เดียวกัน นอกจากนี้ข้อมูลต้องเดินทางจาก Uno ไป ESP32 แล้วจึงไปยังเว็บโดยไม่ทำให้ลูปอ่านเซนเซอร์ค้าง

ในส่วนซอฟต์แวร์ยังต้องจัดการการเชื่อมต่อที่อาจหลุด การส่งข้อมูลแบบสด การบันทึกเฉพาะช่วงที่ทำเซต และการเก็บข้อมูลให้ผูกกับผู้ใช้และเซสชันได้ถูกต้อง

แหล่งข้อมูล: README.md, backend/, frontend/, TROUBLESHOOTING.md

1.3 วัตถุประสงค์ของโครงงาน

1. รับค่า sEMG และ FSR จาก Arduino Uno แล้วส่งต่อให้ ESP32 ด้วย UART
2. อ่านข้อมูล MPU6050/MPU6500, MAX30102 และ MLX90614 ผ่าน I2C บน ESP32
3. ประมวลผลข้อมูลเบื้องต้น เช่น ความนิ่งของ FSR, ความเร็ว, อัตราการเต้นหัวใจ และอุณหภูมิ
4. ส่ง telemetry ไปยังเว็บเพื่อแสดงผลแบบสดและส่งต่อไปยัง FastAPI
5. รองรับการปรับเทียบ การเริ่ม/หยุดบันทึก และการเก็บผลการฝึกใน MongoDB
6. แยกโค้ดและเอกสารให้ตรวจสอบเส้นทางข้อมูลและแก้ปัญหาหน้างานได้ง่าย

แหล่งข้อมูล: README.md, backend/, frontend/, test-sensor/arduino/esp32_workout_firmware/, test-sensor/arduino/uno_emg_fsr_link/

1.4 ขอบเขตของระบบและงานที่ดำเนินการ

ขอบเขตที่ทำในรายงานนี้

- Arduino Uno อ่าน ADC ช่อง A0 และ A1 ด้วย Timer1 กับ ADC interrupt แล้วส่งค่าออกทาง Hardware Serial
- ESP32 รับข้อมูลจาก Uno ทาง Serial2, อ่านเซนเซอร์ I2C, รับปุ่มด้วย GPIO interrupt, จัดการงานด้วย FreeRTOS และส่ง HTTP telemetry
- Frontend รับข้อมูลที่ /api/telemetry, กระจายข้อมูลผ่าน /api/telemetry/stream, จัดการการบันทึกและการปรับเทียบ และแสดงผลการฝึก
- Backend ใช้ FastAPI ตรวจสอบผู้ใช้ รับ telemetry ผลเซสชัน และ calibration ก่อนเก็บลง MongoDB

สิ่งที่ไม่ควรตีความเกินขอบเขต

ค่าที่คำนวณจากเซนเซอร์เป็นค่าประมาณเพื่อใช้ติดตามการฝึก โดยเฉพาะ SpO2 และค่าที่แปลงจาก ADC เป็นหน่วยทางกายภาพ ส่วนข้อมูลกล้องใช้ช่วยนับและประเมินท่าทางในเว็บ ไม่ได้แทนการตรวจวัดทางการแพทย์

แหล่งข้อมูล: README.md, PINS.md, โค้ดใน backend/, frontend/ และสองโฟลเดอร์ Arduino ที่ระบุในรายงาน

บทที่ 2

ความต้องการและงานที่เกี่ยวข้อง

2.1 กลุ่มผู้ใช้และลักษณะการใช้งาน

ผู้ใช้หลักคือผู้ฝึกหรือผู้ทดสอบที่ต้องการดูข้อมูลระหว่างออกกำลังกาย ผู้ใช้เริ่มจากหน้าเว็บ ตรวจสอบความพร้อมและสถานะเซนเซอร์ จากนั้นเริ่มเซต ดูค่าที่เปลี่ยนแบบสด และหยุดเซตเพื่อดูสรุปผล

ผู้พัฒนาหรือผู้ดูแลระบบเป็นผู้ใช้อีกกลุ่มหนึ่ง ต้องตั้งค่า Wi-Fi, URL ของเว็บ, การเชื่อมต่อ I2C/UART, MongoDB และค่า secret ของ backend รวมถึงตรวจสอบ log เมื่ออุปกรณ์ไม่เชื่อมต่อ

ลักษณะการใช้งานเป็นระบบอุปกรณ์เดียวที่ส่งข้อมูลเข้าสู่เว็บในขณะฝึก โดย frontend มีการป้องกันการบันทึกพร้อมกันของผู้ใช้ต่างคนบน telemetry store ที่เป็นหน่วยความจำร่วมของเซิร์ฟเวอร์

แหล่งข้อมูล: README.md, frontend/src/lib/server/telemetryStore.ts, frontend/src/lib/workout/

2.2 ข้อมูลที่ระบบรับเข้า ประมวลผล และแสดงผล

ข้อมูลรับเข้า

- Uno ส่งค่า emg,fsr เป็นข้อความทาง UART
- ESP32 รับค่าจาก Uno และอ่าน MPU, MAX30102, MLX90614 ผ่าน I2C
- ESP32 ส่ง JSON telemetry ที่มี emg, fsr, mpu, vitals, device, timestamp และสถานะปุ่ม
- เว็บรับข้อมูล JSON จากอุปกรณ์ และรับคำสั่งจากผู้ใช้ เช่น เริ่ม/หยุดบันทึกและบันทึก calibration

ข้อมูลประมวลผล

ESP32 คำนวณ pitch, roll, velocity, ความนิ่งของ FSR, HR และ SpO2 ประมาณการ ส่วน frontend แปลง ADC เป็นหน่วยที่ใช้แสดงผล คำนวณ MVC percent และสถานะ high tension รวมทั้งใช้ MediaPipe/OpenCV ช่วยวิเคราะห์การเคลื่อนไหว

ข้อมูลแสดงผลและบันทึก

แดชบอร์ดแสดงกราฟ EMG ค่าแรงและความนิ่งของ FSR การเคลื่อนไหว สัญญาณชีพ สถานะอุปกรณ์ จำนวนครั้ง และผลรายเซต ข้อมูลผลเซตและ calibration ส่งต่อ FastAPI เพื่อจัดเก็บใน MongoDB

แหล่งข้อมูล: backend/app/models/telemetry.py, frontend/src/lib/server/telemetryStore.ts, frontend/src/lib/workout/telemetry.svelte.ts, README.md

2.3 ความต้องการด้านการทำงานและข้อกำหนดอื่นของระบบ

ความต้องการด้านการทำงาน

1. อ่านค่าเซนเซอร์และส่งข้อมูลต่อเนื่องตามรอบที่กำหนด
2. รับ telemetry จาก ESP32 และแสดงผลสดผ่าน SSE
3. เริ่มและหยุดการบันทึกตามเซสชัน พร้อมจำกัดการบันทึกไม่ให้ข้ามผู้ใช้
4. ปรับเทียบค่า EMG และ FSR แบบผูกกับผู้ใช้
5. ลงทะเบียน เข้าสู่ระบบ ต่ออายุ token และตรวจสอบสิทธิ์ก่อนใช้ข้อมูลส่วนตัว
6. บันทึกผลรายเซตและค้นผลย้อนหลังตามผู้ใช้หรือ session id

ข้อกำหนดอื่น

- UART ระหว่าง Uno กับ ESP32 ต้องใช้ baud rate และระดับแรงดันที่ถูกต้อง
- I2C ต้องใช้ขา SDA/SCL และ address ตามการต่อจริง
- การทำงานที่มีเวลาคงที่ควรไม่ถูกบล็อกจาก HTTP หรือการแสดงผล
- ต้องมีการตรวจสอบข้อมูลผิดรูปแบบและรับมือการเชื่อมต่อหลุด
- ค่าที่เป็นค่าประมาณต้องระบุข้อจำกัดก่อนนำไปตีความ

แหล่งข้อมูล: PINS.md, README.md, TROUBLESHOOTING.md, backend/, frontend/, โค้ดเฟิร์มแวร์ทั้งสองโฟลเดอร์

2.4 แนวคิด เครื่องมือ หรืองานที่เกี่ยวข้อง

แนวคิดสำคัญที่ใช้ในระบบคือการแบ่งงานตามความเหมาะสมของอุปกรณ์ ได้แก่ interrupt และ timer สำหรับงานที่ต้องตรงเวลา, FreeRTOS task สำหรับแยกงานบน ESP32, UART สำหรับลิงก์ระหว่างบอร์ด, I2C สำหรับเซนเซอร์หลายตัวบนบัสร่วม และ HTTP/SSE สำหรับส่งข้อมูลระหว่างอุปกรณ์กับเว็บ

เครื่องมือและเทคโนโลยีที่ปรากฏในแหล่งข้อมูล ได้แก่ Arduino framework, FastAPI, SvelteKit, TypeScript, MongoDB, Docker และไลบรารีของเซนเซอร์ เช่น Adafruit_MLX90614, MAX30105/heart-rate และ LiquidCrystal_I2C

ส่วนการวิเคราะห์กล้องใช้ MediaPipe ในตัวนับหลัก และมี OpenCV.js เป็นตัวนับตรวจสอบแบบ motion difference แยกต่างหาก โดยตัวนับ OpenCV ไม่เรียกบันทึก rep หลักซ้ำ

แหล่งข้อมูล: README.md, backend/pyproject.toml, frontend/package.json, frontend/src/lib/workout/, โค้ด Arduino ทั้งสองโฟลเดอร์

บทที่ 3

การออกแบบระบบ

3.1 ภาพรวมสถาปัตยกรรมและองค์ประกอบของระบบ

ระบบแบ่งเป็น 4 ชั้นหลัก

1. ชั้นเซนเซอร์และเฟิร์มแวร์ — Uno อ่าน sEMG/FSR และ ESP32 รวมข้อมูลจาก Uno กับเซนเซอร์ I2C
2. ชั้นรับข้อมูลของเว็บ — SvelteKit รับ HTTP POST จาก ESP32 เก็บสถานะสดใน telemetryStore และกระจายด้วย SSE
3. ชั้น API และฐานข้อมูล — FastAPI ตรวจสอบ token รับ telemetry ผลเซสชัน และ calibration แล้วเก็บใน MongoDB
4. ชั้นผู้ใช้ — หน้า Svelte แสดงค่าร่างกาย กราฟ สถานะอุปกรณ์ กล้อง และผลการฝึก

ภาพรวมการเชื่อมต่ออยู่ใน ../flowchart.md Flowchart 1

แหล่งข้อมูล: README.md, backend/app/main.py, frontend/src/routes/api/, test-sensor/arduino/

3.2 ลำดับขั้นตอนและการไหลของข้อมูล

ลำดับการทำงานโดยย่อมีดังนี้

1. sEMG และ FSR ต่อเข้ากับ A0/A1 ของ Uno
2. Uno ใช้ Timer1 เริ่มรอบอ่านทุก 10 ms แล้วใช้ ADC interrupt อ่าน EMG ต่อด้วย FSR
3. Uno กลับค่า FSR, scale ค่าจาก 10-bit เป็น 12-bit และส่ง emg,fsr ผ่าน UART 9600
4. ESP32 อ่านข้อมูลจาก Serial2 พร้อมอ่าน MPU, MAX30102, MLX90614 ผ่าน I2C
5. NetworkTask รวมข้อมูลเป็น JSON และ POST ไปยัง /api/telemetry ของ frontend
6. frontend อัปเดตสถานะในหน่วยความจำ กระจาย event telemetry ผ่าน /api/telemetry/stream และส่งข้อมูลต่อไป FastAPI
7. FastAPI ตรวจสอบ service token และบันทึกลง collection telemetry_samples

ให้ใช้ ../flowchart.md Flowchart 1 เป็นรูปประกอบหัวข้อนี้

แหล่งข้อมูล: README.md, test-sensor/arduino/uno_emg_fsr_link/uno_emg_fsr_link.ino, test-sensor/arduino/esp32_workout_firmware/esp32_workout_firmware.ino, frontend/src/routes/api/, backend/app/routers/telemetry.py

3.3 การออกแบบขั้นตอนประมวลผล

การประมวลผลถูกแบ่งตามความเร่งด่วนของงาน

- งานอ่านสัญญาณของ Uno อยู่ใน interrupt และ loop ที่หลับรอเหตุการณ์ เพื่อลดการ polling
- งานอ่านและรวมเซนเซอร์ของ ESP32 อยู่ใน SensorTask ที่ถูกปลุกด้วย hardware timer 100 Hz
- งานเครือข่ายอยู่ใน NetworkTask ทุก 250 ms จึงไม่ทำให้รอบอ่านเซนเซอร์ต้องรอ HTTP
- งานจอและการควบคุมปุ่มแยกเป็น LcdTask และ ControlTask
- ข้อมูลที่แชร์ระหว่าง task ใช้ mutex, queue และ semaphore ตามลักษณะข้อมูล
- เว็บแปลงค่าและคำนวณค่าที่ใช้แสดงผลก่อน broadcast ให้ browser

การออกแบบนี้ช่วยให้ส่วนที่ต้องสม่ำเสมอ เช่น ADC และ timer ไม่ถูกผูกกับความเร็วของเครือข่าย

แหล่งข้อมูล: โค้ดใน test-sensor/arduino/uno_emg_fsr_link/ และ test-sensor/arduino/esp32_workout_firmware/, frontend/src/lib/server/telemetryStore.ts

3.4 การออกแบบส่วนติดต่อผู้ใช้

ส่วนติดต่อผู้ใช้แบ่งเป็นหน้าความพร้อม หน้า live studio หน้าสรุปหลังจบเซต หน้า analytics และหน้าปรับเทียบ โดยข้อมูลสดมาจาก SSE และถูกเก็บใน state ของ frontend

หน้า live studio แสดงค่าหลัก เช่น EMG, FSR, MPU, HR, SpO2, อุณหภูมิ และสถานะการเชื่อมต่อ นอกจากนี้ยังมีการรับข้อมูลกล้องเพื่อคำนวณมุมข้อศอก การโกงท่า และจำนวนครั้ง ส่วนการบันทึกข้อมูลสามารถเริ่ม/หยุดและส่งออกเป็น JSON หรือ CSV ได้

ปุ่มจริงบน ESP32 ถูกส่งเป็น event ผ่าน telemetry แล้ว frontend แปลงให้ทำงานเหมือนปุ่มบนหน้าเว็บ ทำให้ผู้ใช้ควบคุมเซตได้โดยไม่ต้องอยู่หน้าอุปกรณ์ตลอดเวลา

แหล่งข้อมูล: frontend/src/lib/workout/, frontend/src/lib/components/workout/, frontend/src/routes/api/telemetry/stream/+server.ts, PINS.md

บทที่ 4

การพัฒนา

4.1 ภาษา เครื่องมือ และสภาพแวดล้อมที่ใช้พัฒนา

ส่วน | ภาษา/เครื่องมือที่ปรากฏในแหล่งข้อมูล | หน้าที่
Arduino Uno และ ESP32 | C/C++ บน Arduino framework | อ่านเซนเซอร์ ประมวลผล และส่ง telemetry
Backend | Python, FastAPI, Pydantic, Motor | API, authentication และการเข้าถึง MongoDB
Frontend | TypeScript, SvelteKit | แดชบอร์ด API proxy SSE และ state การฝึก
ฐานข้อมูล | MongoDB | เก็บ telemetry ผลเซสชัน calibration และข้อมูลผู้ใช้
การพัฒนาในเครื่อง | Docker, Poetry, npm | เตรียม MongoDB ติดตั้ง dependency และรันบริการ

README ระบุสภาพแวดล้อมหลักเป็น Python 3.11 ขึ้นไป, Poetry, Node.js 20 ขึ้นไป, npm และ Docker Compose สำหรับ MongoDB

รายการอุปกรณ์และวัสดุ

รายการด้านล่างเป็นอุปกรณ์และวัสดุที่ต้องใช้สำหรับประกอบและทดสอบระบบตามการกำหนดพินใน PINS.md และการเรียกใช้งานจริงใน firmware สองไฟล์

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

ข้อควรระวังคือ Uno ใช้ระดับสัญญาณ 5V แต่ GPIO ของ ESP32 รับได้ 3.3V จึงต้องผ่าน voltage divider ในทิศทาง Uno TX ไป ESP32 RX และต้องต่อกราวด์ร่วมกัน ส่วนเซนเซอร์ I2C ทั้งหมดใช้บัส SDA GPIO21 และ SCL GPIO22 ของ ESP32

แหล่งข้อมูล: README.md, backend/pyproject.toml, frontend/package.json, โค้ด Arduino ทั้งสองโฟลเดอร์

4.2 โครงสร้างซอฟต์แวร์และหน้าที่ของส่วนประกอบหลัก

เฟิร์มแวร์

- uno_emg_fsr_link/uno_emg_fsr_link.ino — อ่าน EMG/FSR ด้วย ADC และส่ง UART
- uno_emg_fsr_link/board_config.h — กำหนดขาและช่วง ADC ของบอร์ด
- esp32_workout_firmware/esp32_workout_firmware.ino — รวมข้อมูลเซนเซอร์ จัดการ task, ปุ่ม, จอ, buzzer, Wi-Fi และ HTTP
- esp32_workout_firmware/board_config.h — กำหนด mapping I2C/ADC แบบหลายสถาปัตยกรรม

เว็บและ API

- frontend/src/routes/api/telemetry — รับ telemetry และเปิด SSE
- frontend/src/lib/server/telemetryStore.ts — เก็บสถานะสด แปลงค่า และส่งต่อ backend
- frontend/src/lib/workout/ — state ของ telemetry, workout, recording, calibration และกล้อง
- backend/app/routers/ — endpoint authentication, telemetry, sessions, calibration และ users
- backend/app/models/ — schema ข้อมูลที่รับและส่ง
- backend/app/db.py — client MongoDB และการสร้างดัชนี

แหล่งข้อมูล: โครงสร้างไฟล์ใน backend/, frontend/ และสองโฟลเดอร์เฟิร์มแวร์ที่กำหนด

4.3 การพัฒนาฟังก์ชันหลักและการเชื่อมต่อระหว่างส่วนประกอบ

การเชื่อมต่อเริ่มจาก UART ระหว่าง Uno กับ ESP32 โดย Uno ส่งข้อความหนึ่งบรรทัดต่อรอบอ่าน และ ESP32 อ่านจนพบ newline แล้ว parse เป็นจำนวนเต็มสองค่า จากนั้น ESP32 รวมกับข้อมูล I2C และสร้าง JSON telemetry

Frontend route /api/telemetry รับ JSON และเรียก ingestFullTelemetry() เพื่ออัปเดตสถานะสด เมื่อมีข้อมูลใหม่จะ broadcast event telemetry ให้ browser และเรียก forwardToBackend() เพื่อส่งต่อไป FastAPI

การปรับเทียบใช้ frontend route /api/calibration เป็น proxy ที่ตรวจสอบผู้ใช้ เรียก backend และอัปเดต cache ใน telemetry store ให้การแปลงหน่วยของข้อมูลสดใช้ค่าเดียวกับค่าที่บันทึกไว้ ส่วนผลเซตใช้ route ของ FastAPI ผ่าน client ที่สร้างใน frontend

แหล่งข้อมูล: frontend/src/routes/api/telemetry/+server.ts, frontend/src/routes/api/calibration/+server.ts, frontend/src/lib/server/telemetryStore.ts, backend/app/routers/telemetry.py, backend/app/routers/calibration.py

บทที่ 5

ข้อมูลจากเซนเซอร์

5.1 กล้องและเซนเซอร์ที่ใช้: ค่าที่อ่านโดยตรง ช่วงค่า และหน่วย

อุปกรณ์ | วิธีรับข้อมูล | ค่าที่เกี่ยวข้อง | ช่วง/หน่วยตามโค้ด
sEMG | Uno ADC A0 | raw EMG | Uno 0-1023 แล้ว scale เป็น 0-4095
FSR | Uno ADC A1 | raw/แรงกำและ stability | Uno 0-1023 กลับด้านและ scale เป็น 0-4095
MPU6050/MPU6500 | ESP32 I2C address 0x68 | ax, ay, az, pitch, roll, velocity | accel ตั้งช่วง ±8g; velocity เป็นค่าคำนวณ
MAX30102 | ESP32 I2C address 0x57 | HR, SpO2 | HR เป็น BPM; SpO2 เป็นเปอร์เซ็นต์ประมาณการ
MLX90614 | ESP32 I2C address 0x5A | skin temperature, delta temperature | องศาเซลเซียส
กล้อง | browser video | elbow angle, torso angle, shoulder hike, motion | มุมเป็นองศา ระยะเป็นเซนติเมตร และ motion level 0-100

ขา I2C หลักของ ESP32 คือ SDA GPIO21 และ SCL GPIO22 ตาม PINS.md และ board_config.h ส่วน Uno ใช้ A0/A1 สำหรับสัญญาณอนาล็อก

แหล่งข้อมูล: PINS.md, README.md, test-sensor/arduino/esp32_workout_firmware/, test-sensor/arduino/uno_emg_fsr_link/, frontend/src/lib/workout/

5.2 อัตราการอ่าน การปรับเทียบ และค่าที่คำนวณต่อ

Uno ทำรอบอ่านที่ 100 Hz หรือทุก 10 ms โดย Timer1 CTC เริ่ม ADC EMG แล้ว ADC interrupt เริ่มอ่าน FSR ต่อกัน ส่วน ESP32 ใช้ hardware timer ปลุก SensorTask ทุก 10 ms เช่นกัน แต่ส่งข้อมูลเครือข่ายทุก 250 ms หรือประมาณ 4 Hz จออัปเดตทุก 200 ms และ MLX90614 อ่านทุก 250 ms

การปรับเทียบของเว็บเก็บ emgBaseline, emgMvc, fsrZero และ fsrMax ต่อผู้ใช้ ค่า EMG ถูกแปลงจาก ADC โดย recenter รอบค่ากลางและหารด้วย gain ที่กำหนดใน telemetry store ส่วน FSR ถูก normalize ระหว่าง zero กับ max แล้วแปลงเป็นแรงเต็มสเกลที่กำหนดไว้ในโค้ด

ค่าที่คำนวณต่อ ได้แก่ MVC percent, high-tension flag, FSR stability จากช่วงค่าหน้าต่าง, pitch/roll, velocity, HR, SpO2 จากอัตราส่วน AC/DC และ delta temperature

แหล่งข้อมูล: test-sensor/arduino/uno_emg_fsr_link/uno_emg_fsr_link.ino, test-sensor/arduino/esp32_workout_firmware/esp32_workout_firmware.ino, frontend/src/lib/server/telemetryStore.ts, frontend/src/lib/workout/calibration.svelte.ts

5.3 ฟิลด์ข้อมูลที่ส่งออกและข้อจำกัดของค่าประมาณ

telemetry หลักประกอบด้วยกลุ่ม emg, fsr, mpu, vitals, device, timestamp และอาจมี buttons โดย backend schema อนุญาตฟิลด์เพิ่มเติมเพื่อให้รองรับข้อมูลจากอุปกรณ์ได้ยืดหยุ่น

ตัวอย่างฟิลด์ที่เว็บใช้แสดงผล ได้แก่ emg.raw, emg.rawBuffer, emg.rms, emg.peak, emg.mvcPercent, fsr.gripForce, fsr.gripStability, mpu.pitch, mpu.roll, mpu.velocity, vitals.hr, vitals.spo2, vitals.skinTemp และสถานะอุปกรณ์

ข้อจำกัดสำคัญคือค่า EMG และแรง FSR อาศัย gain/full-scale ที่กำหนดในโค้ดและ calibration ของผู้ใช้ ขณะที่ SpO2 เป็น rough estimate ที่ source ระบุว่าไม่ใช่ค่าทางคลินิก และค่าจากกล้องขึ้นกับตำแหน่งกล้อง แสง และการมองเห็นร่างกาย

แหล่งข้อมูล: backend/app/models/telemetry.py, frontend/src/lib/server/telemetryStore.ts, frontend/src/lib/workout/telemetry.svelte.ts, frontend/src/lib/workout/cameraRepCounter.svelte.ts

บทที่ 6

การจัดเก็บข้อมูลและการนำไปใช้

6.1 ภาพรวมข้อมูลสด ข้อมูลที่บันทึก และความสัมพันธ์ของข้อมูล

ข้อมูลสดเริ่มจาก ESP32 แล้วถูกเก็บชั่วคราวใน ServerTelemetryState ของ frontend เพื่อแสดงผลและกระจายผ่าน SSE ข้อมูลชุดนี้เป็นสถานะล่าสุด ไม่ใช่ประวัติถาวรทั้งหมด

เมื่อมีการส่งต่อไป backend จะเกิดเอกสารใน telemetry_samples โดยมี received_at และข้อมูลผู้ใช้/เซสชันตามที่ส่งมา ส่วนผลสรุปหลังจบเซตถูกส่งไป session_results และ calibration ถูกเก็บใน calibrations แยกจาก telemetry

ความสัมพันธ์หลักคือผู้ใช้หนึ่งคนมี calibration ของตนเอง มี telemetry ที่ใช้ติดตามช่วงเวลา และมีผลเซสชันหลายรายการที่อ้างอิง session_id ได้ ข้อมูล authentication ใช้ users และ refresh_tokens รองรับการเข้าถึงข้อมูลส่วนตัว

แหล่งข้อมูล: backend/app/db.py, backend/app/routers/, backend/app/models/, frontend/src/lib/server/telemetryStore.ts

6.2 Collections และฟิลด์สำคัญ

Collection | ฟิลด์สำคัญ | หน้าที่
users | email, name, password_hash, roles, is_active, created_at | บัญชีผู้ใช้
refresh_tokens | jti, user_id, revoked, created_at, expires_at | token สำหรับต่ออายุ session
telemetry_samples | emg, fsr, mpu, vitals, device, timestamp, user_id, session_id, received_at | ข้อมูลเซนเซอร์ที่รับเข้า
session_results | setNumber, exercise, weightKg, totalReps, cleanReps, cheatedReps, reps, session_id, user_id, created_at | ผลสรุปการฝึก
calibrations | user_id, emgBaseline, emgMvc, fsrZero, fsrMax, updated_at | ค่า calibration ต่อผู้ใช้

ชื่อและฟิลด์ข้างต้นมาจากการสร้าง index, Pydantic models และ router ของ backend โดยตรง

แหล่งข้อมูล: backend/app/db.py, backend/app/models/, backend/app/routers/

6.3 เก็บข้อมูลแต่ละประเภทเพื่อใช้ทำอะไร และส่วนใดของระบบเรียกใช้จริง

- telemetry สด ใช้โดย telemetryStore เพื่อคำนวณหน่วย แสดงแดชบอร์ด และส่ง event ไป browser
- telemetry ที่บันทึกใน MongoDB ใช้เป็นประวัติข้อมูลตามช่วงเวลา โดย endpoint history สามารถค้นตาม since และ limit
- session results ใช้แสดงผลหลังจบเซตและประวัติการฝึก โดย query ได้ตามผู้ใช้และ session_id
- calibration ใช้ทั้งในหน้า calibration และใน telemetry store เพื่อแปลง raw ADC เป็นค่าที่แสดงผล
- users และ refresh tokens ใช้ยืนยันตัวตนและจำกัดการเข้าถึงข้อมูลของแต่ละผู้ใช้

การบันทึกการวัดแบบละเอียดกับการบันทึกผลสรุปถูกแยกกัน เพื่อให้หน้าใช้งานอ่านผลเซตได้ง่ายโดยไม่ต้องประมวลผล telemetry ทั้งหมดใหม่

แหล่งข้อมูล: backend/app/routers/telemetry.py, backend/app/routers/sessions.py, backend/app/routers/calibration.py, frontend/src/lib/workout/

6.4 ตัวอย่างเอกสาร ดัชนี การค้นคืน และอายุข้อมูล

backend สร้างดัชนีดังนี้

- users.email แบบ unique
- refresh_tokens.jti แบบ unique
- calibrations.user_id แบบ unique
- session_results ตาม user_id และ created_at เพื่อเรียงผลย้อนหลัง
- session_results.session_id เพื่อค้นตามเซสชัน
- telemetry_samples ตาม user_id และ received_at เพื่อค้นประวัติของผู้ใช้
- telemetry_samples.received_at แบบ TTL ตาม TELEMETRY_RETENTION_DAYS ซึ่งค่าเริ่มต้นใน settings คือ 90 วัน

ตัวอย่างการค้นคืน telemetry คือ query ด้วย user_id ของผู้ใช้ปัจจุบัน และถ้ามี since จะเปลี่ยนเป็นเงื่อนไข received_at >= since พร้อมจำกัดจำนวนผลไม่เกิน 2,000 รายการ ส่วน session history จำกัดค่าเริ่มต้น 50 และสูงสุด 200 รายการ

แหล่งข้อมูล: backend/app/db.py, backend/app/config.py, backend/app/routers/telemetry.py, backend/app/routers/sessions.py

บทที่ 7

โครงสร้างและการทำงานของโค้ด

7.1 แผนผัง codebase และหน้าที่ของเฟิร์มแวร์ เว็บ และ API

test-sensor/arduino/

├── uno_emg_fsr_link/ # Uno: ADC + Timer1 + UART

└── esp32_workout_firmware/ # ESP32: FreeRTOS + I2C + Wi-Fi + HTTP

frontend/src/

├── routes/api/ # endpoint รับ telemetry, SSE, recording, calibration

├── lib/server/telemetryStore.ts # สถานะสดและการส่งต่อ backend

└── lib/workout/ # state ของ workout, telemetry, camera, recording

backend/app/

├── routers/ # auth, telemetry, sessions, calibration, users

├── models/ # schema ข้อมูล

├── db.py # MongoDB และ index

└── security.py # JWT และ password

ผังนี้เป็นสรุปหน้าที่ของส่วนประกอบหลัก ไม่ได้รวมไฟล์ที่อยู่นอกขอบเขตแหล่งข้อมูลของรายงาน

แหล่งข้อมูล: โครงสร้างไฟล์ใน backend/, frontend/ และ test-sensor/arduino/

7.2 Arduino Uno: Timer1, ADC Interrupt, Watchdog และ UART

เฟิร์มแวร์ uno_emg_fsr_link.ino ใช้ Timer1 ในโหมด CTC โดยตั้ง prescaler 64 และค่า OCR1A ให้เกิด interrupt ที่ 100 Hz หรือทุก 10 ms เมื่อเกิด TIMER1_COMPA_vect จะตั้ง FLAG_TIMER_TICK ให้ loop เริ่มรอบอ่านใหม่

การอ่าน ADC ไม่ใช้ analogRead() แบบรอค้าง แต่เปิด ADC complete interrupt และเริ่ม conversion ที่ A0 สำหรับ EMG เมื่อเสร็จจะเก็บค่าและเริ่ม A1 สำหรับ FSR ต่อทันที เมื่อ FSR เสร็จ loop จะคัดลอกค่าด้วยช่วง cli()/sei() แล้วกลับด้าน FSR เพราะเซนเซอร์อ่านค่าสูงตอนพัก

CPU ใช้ SLEEP_MODE_IDLE ระหว่างรอ timer และ ADC interrupt ส่วน watchdog ตั้งไว้ 2 วินาทีและ reset เมื่อจบรอบอ่านครบ หากรอบอ่านไม่เดินต่อจะ reset อุปกรณ์

ค่าที่ได้จาก ADC 10-bit ถูก map เป็น 0-4095 แล้วส่งด้วย Serial ที่ 9600 baud เป็นรูปแบบ emg,fsr ต่อบรรทัด ผ่าน pin 0/1 ของ Uno ตามโค้ดปัจจุบัน

ใช้ ../flowchart.md Flowchart 2 เป็นรูปประกอบหัวข้อนี้

แหล่งข้อมูล: test-sensor/arduino/uno_emg_fsr_link/uno_emg_fsr_link.ino, test-sensor/arduino/uno_emg_fsr_link/board_config.h, PINS.md, TROUBLESHOOTING.md

7.3 ESP32: FreeRTOS, Hardware Timer, GPIO Interrupt, Watchdog, I2C และการส่งข้อมูล

ESP32 แยกงานเป็น SensorTask, NetworkTask, LcdTask และ ControlTask ด้วย xTaskCreatePinnedToCore() โดย SensorTask อ่านข้อมูลถี่ที่สุด, NetworkTask ส่ง HTTP ทุก 250 ms, LcdTask อัปเดตจอทุก 200 ms และ ControlTask จัดการปุ่มกับสถานะการฝึก

hardware timer ใช้ปลุก semaphore ของรอบ sampling ที่ 100 Hz ส่วนปุ่ม GPIO32 และ GPIO33 ใช้ interrupt handler ส่ง event เข้า buttonEventQueue โดยใช้ตัวจับเวลาไมโครวินาทีเพื่อทำ debounce 250 ms ปุ่ม A ยังเป็น wake source ในโหมด light sleep ตามข้อจำกัดของบอร์ด

watchdog ของ ESP32 ตั้ง timeout 5 วินาทีและเพิ่ม task หลักเข้า watchdog แต่ละ task เรียก esp_task_wdt_reset() หลังทำงาน ส่วนการอ่าน MPU, MAX30102, MLX90614 และ LCD ใช้ I2C bus ที่ SDA21/SCL22 และมี mutex ป้องกันการใช้งานร่วมกัน

ข้อมูลจาก Uno อ่านผ่าน Serial2 ที่ GPIO16/17 และ 9600 baud จากนั้น NetworkTask จะรวมข้อมูลใน JSON แล้วใช้ HTTPClient.POST() ส่งไปยัง URL ของ frontend

ใช้ ../flowchart.md Flowchart 3 เป็นรูปประกอบหัวข้อนี้

แหล่งข้อมูล: test-sensor/arduino/esp32_workout_firmware/esp32_workout_firmware.ino, test-sensor/arduino/esp32_workout_firmware/board_config.h, PINS.md, TROUBLESHOOTING.md

7.4 เว็บและเซิร์ฟเวอร์: รับ telemetry, กระจาย SSE, เริ่ม/หยุดบันทึก, ส่งต่อ FastAPI และเก็บ MongoDB

Frontend route POST /api/telemetry รับ JSON จาก ESP32 แล้วเรียก serverTelemetry.ingestFullTelemetry() ส่วน GET /api/telemetry/stream ส่ง initial state และ event แบบ telemetry หรือ button ผ่าน SSE ให้ browser

telemetryStore เก็บ raw buffer และสถานะล่าสุด คำนวณ EMG/FSR ที่ใช้แสดงผล และเรียก forwardToBackend() เพื่อส่งข้อมูลไป FastAPI ด้วย service token ฝั่ง backend มี POST /v1/telemetry สำหรับ machine-to-machine และ GET /v1/telemetry สำหรับ history ของผู้ใช้ที่ login แล้ว

การเริ่ม/หยุดบันทึกใช้ POST /api/recording โดย frontend ตรวจสอบผู้ใช้ผ่าน FastAPI client และมี recording slot เดียวต่อ hardware rig ส่วน calibration proxy เรียก GET/POST /v1/calibration แล้ว mirror ค่ากลับเข้า in-memory store

FastAPI สร้าง index ตอนเริ่มแอปและใช้ Motor เชื่อม MongoDB การสร้าง session result เขียนลง session_results ขณะที่ telemetry เขียนลง telemetry_samples

แหล่งข้อมูล: frontend/src/routes/api/telemetry/, frontend/src/routes/api/recording/+server.ts, frontend/src/routes/api/calibration/+server.ts, frontend/src/lib/server/telemetryStore.ts, backend/app/

7.5 เส้นทางข้อมูลแบบครบวงจรและตัวอย่างโค้ดสำคัญ

เส้นทางข้อมูลหนึ่งรอบเริ่มจาก ISR(TIMER1_COMPA_vect) ของ Uno ตั้ง flag → ADC interrupt อ่าน A0/A1 → Serial.print() ส่งข้อความ → ESP32 pollUnoLink() parse บรรทัด → SensorTask อัปเดต SharedState → NetworkTask สร้าง JSON → http.POST(payload) → frontend ingestFullTelemetry() → SSE และ forwardToBackend() → FastAPI insert MongoDB

ตัวอย่างจุดสำคัญที่ควรนำไปแสดงในรายงานฉบับเต็ม:

- การตั้ง Timer1 และ ADC ISR ใน uno_emg_fsr_link.ino
- การ parse emg,fsr และการอ่าน I2C ใน esp32_workout_firmware.ino
- การสร้าง telemetry payload ใน NetworkTask
- การ broadcast event ใน frontend/src/routes/api/telemetry/stream/+server.ts
- การ insert ใน backend/app/routers/telemetry.py

ใช้ ../flowchart.md Flowchart 1 เป็นรูปสรุปเส้นทางข้อมูล และ Flowchart 2-3 เป็นรายละเอียดฝั่งไมโครคอนโทรลเลอร์

แหล่งข้อมูล: ไฟล์ที่ระบุในหัวข้อนี้ทั้งหมด และ README.md

บทที่ 8

การทดสอบและผลลัพธ์

8.1 วัตถุประสงค์ วิธีการ และสภาพแวดล้อมการทดสอบ

การทดสอบมุ่งตรวจสอบ 4 เรื่อง คือ การอ่านค่าเซนเซอร์ การสื่อสารระหว่าง Uno กับ ESP32 การส่งข้อมูลเข้าสู่เว็บ/API และการแสดงผลหรือบันทึกข้อมูลตามเซสชัน

สภาพแวดล้อมที่ระบุในเอกสารโครงการประกอบด้วย Arduino Uno, ESP32 DevKit, เซนเซอร์ที่ต่อผ่าน ADC/UART/I2C, MongoDB ผ่าน Docker, FastAPI backend และ SvelteKit frontend การทดสอบการสื่อสารใช้ Serial monitor, I2C scanner และ diagnostic raw echo ตามบันทึก troubleshooting

วิธีทดสอบควรเริ่มจากแยกส่วน: ตรวจ Uno ส่งข้อความได้ก่อน จากนั้นตรวจ ESP32 รับ UART และอ่าน I2C ต่อด้วยตรวจ POST เข้า frontend, SSE ไป browser และการบันทึกเข้า backend เพื่อให้แยกสาเหตุได้เมื่อเกิดข้อผิดพลาด

แหล่งข้อมูล: README.md, PINS.md, TROUBLESHOOTING.md, โค้ดในสองโฟลเดอร์ Arduino และ backend/, frontend/

8.2 กรณีทดสอบและเกณฑ์ประเมินผล

กรณี | วิธีตรวจ | เกณฑ์ผ่าน
Uno อ่าน ADC | เปลี่ยนสัญญาณที่ A0/A1 และดูข้อความ UART | ได้คู่ค่า emg,fsr ต่อเนื่องและรูปแบบถูกต้อง
UART Uno-ESP32 | ต่อผ่าน voltage divider และดู log ESP32 | ESP32 parse ค่าได้ ไม่ค้างที่ศูนย์
Timer/ADC | ตรวจความต่อเนื่องของข้อมูลและรอบอ่าน | ไม่มีการหยุดยาวจน watchdog reset
I2C | ใช้ scanner และตรวจ log ตอนเริ่มระบบ | พบ address ของอุปกรณ์ที่ต่ออยู่
HTTP telemetry | ตรวจ response ของ /api/telemetry | ได้ JSON response และ packet count เพิ่ม
SSE | เปิดหน้า dashboard และถอด/ต่อ network | สถานะเปลี่ยนและ reconnect ได้
Authentication | เรียก endpoint แบบมี/ไม่มี token | endpoint ส่วนตัวปฏิเสธ request ที่ไม่มี token
Calibration | GET/POST calibration ของผู้ใช้ | ค่าถูกบันทึกและสะท้อนใน live conversion
Session result | จบเซตและบันทึกผล | ผลถูกสร้างและค้นย้อนหลังได้

เกณฑ์นี้เป็นกรอบสำหรับทดสอบจากโค้ดและ endpoint ที่มีอยู่ ไม่ใช่ผลการรับรองความแม่นยำของเซนเซอร์

แหล่งข้อมูล: backend/app/routers/, frontend/src/routes/api/, TROUBLESHOOTING.md, README.md

8.3 ผลการทดสอบและตัวอย่างผลลัพธ์

จาก TROUBLESHOOTING.md มีผลการทดสอบหน้างานที่บันทึกไว้ดังนี้

- Uno อ่าน sEMG และ FSR ได้ และส่งข้อมูลออกทาง TX
- การตรวจด้วย raw echo พบว่าลิงก์มี byte เข้ามา แต่ช่วงแรกหยุดที่ 1 byte จนแก้จุดต่อ voltage divider ให้แน่น
- หลังแก้การต่อสายและเปลี่ยนมาใช้ Hardware Serial ของ Uno ข้อมูลรูปแบบ <emg>,<fsr>\r\n เข้ามาต่อเนื่อง
- การตรวจ I2C ใช้แยกปัญหา bus รวมกับปัญหาเฉพาะอุปกรณ์ได้ โดยกรณีที่พบอุปกรณ์อื่นแต่ไม่พบ MLX90614 ชี้ไปที่สายของ MLX90614
- การตั้ง baud ของ Serial monitor ต้องตรงกับอุปกรณ์ มิฉะนั้นจะเห็นข้อความเพี้ยน

สำหรับฝั่งเว็บและ backend โค้ดมีเส้นทางรับ telemetry, SSE, authentication, calibration, session result และ MongoDB index ครบตามที่ออกแบบไว้ แต่รายงานนี้ไม่เพิ่มตัวเลขผลการทดสอบที่ไม่ได้บันทึกไว้ในแหล่งข้อมูล

แหล่งข้อมูล: TROUBLESHOOTING.md, backend/, frontend/, README.md

8.4 การวิเคราะห์ผลและข้อจำกัดที่พบ

ผลจากการแก้ปัญหา UART แสดงว่าระบบมีความไวต่อทั้งการเลือกขา การใช้พอร์ตเดียวกันระหว่าง USB กับลิงก์บอร์ด และคุณภาพจุดต่อ voltage divider จึงควรทดสอบ hardware link แยกจากการทดสอบ parser

การใช้ I2C bus ร่วมกันทำให้การตรวจด้วย address scanner มีประโยชน์มาก หากอุปกรณ์หายเพียงตัวเดียวควรตรวจสายและไฟเลี้ยงเฉพาะตัวนั้นก่อน แต่ถ้าหายพร้อมกันหลายตัวควรตรวจ SDA/SCL และ ground รวม

ข้อจำกัดของผลการทดสอบคือเอกสารที่ใช้ไม่ได้ระบุชุดข้อมูลอ้างอิงสำหรับวัดความแม่นยำของ EMG, FSR, HR หรือ SpO2 ดังนั้นผลที่สรุปได้ในบทนี้เป็นผลด้านการทำงานและการเชื่อมต่อ ไม่ใช่ผล validation ทางกายภาพ

แหล่งข้อมูล: TROUBLESHOOTING.md, PINS.md, README.md, โค้ดใน test-sensor/arduino/

บทที่ 9

ปัญหาที่พบและวิธีแก้ไข

9.1 ปัญหาที่พบระหว่างการพัฒนาและการทดสอบ

ปัญหาที่บันทึกไว้ใน TROUBLESHOOTING.md ได้แก่ serial log เพี้ยนหลังบูต, ตั้ง baud ของ monitor ไม่ตรง, ไม่พบอุปกรณ์ I2C, MLX90614 หายเฉพาะตัว, ESP32 เข้าโหมด flash ไม่สำเร็จ และ Uno-ESP32 UART ไม่มีข้อมูล

ปัญหา UART มีรายละเอียดหลายชั้น ทั้งการใช้ขาไม่ตรงกับสายจริง จุดต่อ voltage divider หลวม และผลข้างเคียงจากการเปลี่ยน Uno ไปใช้ pin 0/1 ซึ่งชนกับ USB serial และการอัปโหลดโปรแกรม

นอกจากนี้ PINS.md ยังมีข้อความบางส่วนที่ระบุการใช้ pin 2/3 แบบ SoftwareSerial ไม่ตรงกับโค้ดปัจจุบันที่ใช้ Hardware Serial pin 0/1 จึงเป็นปัญหาด้านความสอดคล้องของเอกสารด้วย

แหล่งข้อมูล: TROUBLESHOOTING.md, PINS.md, test-sensor/arduino/

9.2 สาเหตุและผลกระทบของแต่ละปัญหา

ปัญหา | สาเหตุ | ผลกระทบ
log หลังบูตเพี้ยน | UART และ boot log ชนกันก่อน hardware settle | อ่าน log ช่วงเริ่มต้นไม่ได้
monitor เพี้ยนทั้งหน้าจอ | baud ของ monitor เป็น 9600 แต่ ESP32 ส่ง 115200 | ข้อมูลถูก decode ผิดทั้งหมด
I2C หายหลายตัว | SDA/SCL หรือ ground มีปัญหา | เซนเซอร์ทั้ง bus ใช้ไม่ได้
MLX90614 หายตัวเดียว | สายหรือไฟเลี้ยงของ MLX90614 หลวม | อุณหภูมิเป็นศูนย์หรือไม่อัปเดต
upload ESP32 ไม่ผ่าน | auto-reset/boot mode ไม่เสถียร | อัปโหลด firmware ไม่สำเร็จ
UART ไม่มีข้อมูล | ขาโค้ดไม่ตรงสาย, จุดต่อ divider หลวม, ใช้พอร์ตชนกับ USB | ESP32 parse ไม่ได้และ FSR ค้างที่ศูนย์
เอกสาร pin ไม่ตรงโค้ด | เอกสารเดิมยังอ้าง SoftwareSerial | ต่อวงจรหรือ debug ผิดจุดได้

แหล่งข้อมูล: TROUBLESHOOTING.md, PINS.md

9.3 วิธีที่ใช้แก้ไขและเหตุผลที่เลือกวิธีนั้น

- เพิ่ม delay หลัง Serial.begin() ของ ESP32 เพื่อให้ UART settle ก่อนพิมพ์ log
- ระบุ environment หรือ baud ให้ pio device monitor ตรงกับ firmware
- ตรวจและต่อ SDA/SCL ใหม่ แล้วใช้ I2C scanner ยืนยัน address
- ตรวจ VCC/SDA/SCL ของ MLX90614 แยกจากอุปกรณ์อื่นเมื่ออุปกรณ์อื่นยังพบปกติ
- ใช้ขั้นตอนกด BOOT และ EN/RESET ด้วยมือเมื่อ auto-reset เข้า download mode ไม่สำเร็จ
- เปลี่ยน Uno ให้ใช้ Hardware Serial pin 0/1 ให้ตรงกับการต่อสายจริง และถอดสายก่อน upload
- กดจุดต่อ R1/R2 ของ voltage divider ให้แน่น แล้วใช้ raw echo ตรวจ byte ก่อนตรวจ parser

เหตุผลร่วมของวิธีเหล่านี้คือแยกตรวจทีละชั้น ตั้งแต่ physical link, baud/address, byte stream, parser และการทำงานของระบบ เพื่อไม่แก้ปัญหาผิดชั้น

แหล่งข้อมูล: TROUBLESHOOTING.md

9.4 ผลหลังแก้ไขและปัญหาที่ยังเหลืออยู่

หลังแก้การต่อสายและจุดต่อ voltage divider พบว่า byte counter วิ่งต่อเนื่องและข้อมูล <emg>,<fsr>\r\n เข้ามาได้ถูกต้อง การใช้ Hardware Serial ทำให้โค้ดตรงกับการต่อจริง แต่ทำให้ไม่สามารถใช้ USB serial monitor ของ Uno พร้อมกับการต่อ ESP32 บน pin เดียวกันได้

ปัญหาที่เหลือคือ PINS.md ยังต้องอัปเดตส่วน UART ให้ตรงกับโค้ดปัจจุบัน และการใช้งาน pin 0/1 ต้องมีขั้นตอนถอดสายก่อน upload ทุกครั้ง นอกจากนี้เอกสารบางส่วนใน README.md ยังอ้างชื่อไฟล์หรือโครงสร้างเดิม จึงควรตรวจให้ตรงกับโฟลเดอร์ Arduino ปัจจุบันก่อนนำไปใช้เป็นคู่มือปฏิบัติ

แหล่งข้อมูล: TROUBLESHOOTING.md, PINS.md, README.md

บทที่ 10

สรุปและแนวทางพัฒนา

10.1 สรุปสิ่งที่พัฒนาและผลที่ได้เทียบกับวัตถุประสงค์

โครงงานพัฒนาระบบครบเส้นทางตั้งแต่การอ่าน sEMG/FSR บน Uno การรวมเซนเซอร์บน ESP32 การส่งข้อมูลไปเว็บ การกระจายข้อมูลแบบสด การยืนยันตัวตน และการจัดเก็บข้อมูลใน MongoDB

ด้าน firmware มีการใช้ Timer1, ADC interrupt, watchdog และ sleep บน Uno ส่วน ESP32 ใช้ FreeRTOS task, hardware timer, GPIO interrupt, watchdog, I2C, UART และ HTTP ตามวัตถุประสงค์ที่กำหนดไว้ การแยกงานทำให้การอ่านเซนเซอร์ไม่ต้องรอการส่ง network โดยตรง

ด้านซอฟต์แวร์มี endpoint สำหรับ telemetry, SSE, recording, calibration, authentication และ session result ทำให้รองรับทั้งการดูข้อมูลสดและการเก็บผลสรุปหลังการฝึก

แหล่งข้อมูล: README.md, backend/, frontend/, โค้ด Arduino ทั้งสองโฟลเดอร์

10.2 ข้อจำกัดของโครงงาน

1. ค่าที่แปลงจาก ADC เป็นหน่วย EMG และแรงเป็นค่าประมาณและขึ้นกับ gain/full-scale กับ calibration
2. SpO2 ใน firmware ระบุว่าเป็น rough estimate ไม่ใช่ค่าทางคลินิก
3. การนับครั้งจากกล้องขึ้นกับมุมกล้อง แสง และการมองเห็นแขน/ลำตัว
4. Recording slot ใน telemetry store เป็นทรัพยากรร่วมและรองรับการบันทึกจริงทีละรายการ
5. UART Uno ใช้ pin 0/1 จึงชนกับ USB serial และต้องถอดสายก่อน upload
6. PINS.md และบางส่วนของ README.md ยังมีข้อมูลเดิมที่ควรปรับให้ตรงกับโค้ดปัจจุบัน
7. รายงานแหล่งข้อมูลยังไม่มีผล validation เชิงตัวเลขสำหรับความแม่นยำของเซนเซอร์

แหล่งข้อมูล: README.md, PINS.md, TROUBLESHOOTING.md, frontend/src/lib/server/telemetryStore.ts, frontend/src/lib/workout/cameraRepCounter.svelte.ts

10.3 แนวทางพัฒนาต่อ

- ปรับปรุง PINS.md และคู่มือใน README.md ให้ใช้ path และ pin mapping เดียวกับโค้ดปัจจุบัน
- เพิ่ม automated test สำหรับ parser UART, การแปลง calibration, telemetry schema และ endpoint authentication
- เพิ่มชุดข้อมูลอ้างอิงเพื่อประเมินความแม่นยำของ EMG, FSR, HR และ SpO2 อย่างเป็นระบบ
- แยกการตั้งค่า Wi-Fi, server URL และ secret ออกจาก source code พร้อมตรวจสอบการจัดการ credential
- ปรับการเก็บ telemetry ให้เหมาะกับปริมาณข้อมูลและความต้องการค้นย้อนหลัง รวมถึงกำหนด policy retention ให้ชัดเจน
- เพิ่มกลไกตรวจสอบความถูกต้องของ timestamp และการ reconnect ของอุปกรณ์
- พิจารณาปรับลิงก์ Uno-ESP32 ให้ไม่ชนกับ USB serial หรือเพิ่มโหมด debug ที่ไม่ปนกับข้อมูล telemetry

แนวทางเหล่านี้ต่อยอดจากข้อจำกัดและปัญหาที่ปรากฏใน source code, README และ troubleshooting โดยไม่สรุปว่าเป็นฟังก์ชันที่มีอยู่แล้วในระบบปัจจุบัน

เอกสารอ้างอิง

เอกสารอ้างอิงในรายงานฉบับนี้เป็นไฟล์ภายในโครงการที่ผู้ใช้กำหนดให้ใช้เป็นแหล่งข้อมูล

1. README.md — ภาพรวมระบบ การติดตั้ง และสถาปัตยกรรมระดับโครงการ
2. PINS.md — การกำหนดขาและรายละเอียดการต่ออุปกรณ์
3. TROUBLESHOOTING.md — บันทึกปัญหาและวิธีแก้ระหว่าง bring-up
4. test-sensor/arduino/uno_emg_fsr_link/ — firmware ของ Arduino Uno สำหรับ ADC และ UART
5. test-sensor/arduino/esp32_workout_firmware/ — firmware ของ ESP32 สำหรับเซนเซอร์ I2C, FreeRTOS, Wi-Fi และ HTTP
6. backend/ — FastAPI, models, security, MongoDB และ routers
7. frontend/ — SvelteKit routes, telemetry store, workout state และส่วนติดต่อผู้ใช้

รายงานนี้ไม่ได้เพิ่มแหล่งข้อมูลภายนอกเพื่ออธิบายการทำงานของโค้ด

ภาคผนวก

ภาคผนวก ก: จุดอ้างอิง flowchart

ไฟล์ flowchart.md มี Mermaid 3 ชุดสำหรับใช้สร้างภาพประกอบ

- Flowchart 1: การไหลของข้อมูลจาก Uno ถึง MongoDB — ใช้ในข้อ 3.2 และ 7.5
- Flowchart 2: Timer1, ADC interrupt และ UART ของ Uno — ใช้ในข้อ 7.2
- Flowchart 3: Task, timer, interrupt, I2C และ HTTP ของ ESP32 — ใช้ในข้อ 7.3

ภาคผนวก ข: ข้อควรระวังในการต่ออุปกรณ์

- Uno ส่งสัญญาณ 5V ไปยัง ESP32 ซึ่งเป็น logic 3.3V ต้องใช้ voltage divider ตามที่ระบุใน PINS.md
- UART ปัจจุบันของ Uno ใช้ pin 0/1 จึงควรถอดสายออกก่อน upload และไม่ควรใช้ USB serial monitor พร้อมกัน
- I2C ของ ESP32 ใช้ SDA GPIO21 และ SCL GPIO22 ตาม mapping ใน firmware
- ปุ่ม ESP32 ใช้ GPIO32/GPIO33 และปุ่มทำงานแบบ active-low ตามรายละเอียดใน PINS.md

ภาคผนวก ค: รูปแบบ telemetry โดยย่อ

{

"timestamp": 0,

"emg": {"raw": 0, "rms": 0, "mvcPercent": 0},

"fsr": {"force": 0, "stability": 0},

"mpu": {"pitch": 0, "roll": 0, "velocity": 0},

"vitals": {"hr": 0, "spo2": 0, "skinTemp": 0},

"buttons": {"a": false, "b": false}

}

ตัวอย่างนี้เป็นโครงร่างเพื่ออธิบายกลุ่มข้อมูล ไม่ใช่การระบุว่าทุก field จะมีค่าในทุก packet
