Fishcanwalk/muscle-activity-analyzer/report/cyberpump_report.docx

# คำนำ

รายงานฉบับนี้อธิบายการพัฒนา Cyberpump หรือ muscle-activity-analyzer ซึ่งเป็นระบบติดตามการฝึกเวทโดยรวมภาพจากกล้องและข้อมูลเซนเซอร์เข้ากับเว็บแดชบอร์ด เนื้อหาครอบคลุมปัญหา ความต้องการ การออกแบบ การพัฒนา ปัญหาที่พบ และแนวทางปรับปรุง โดยยึดโค้ดและเอกสารของโครงงานเป็นหลัก [1]

รายงานจัดทำเพื่อบันทึกสถาปัตยกรรมและการตัดสินใจด้านการพัฒนาให้ตรวจสอบย้อนกลับได้ บทที่ 8 จัดโครงไว้สำหรับเติมข้อมูลทดสอบที่วัดจริงในภายหลัง จึงไม่มีการอ้างค่าประสิทธิภาพหรือความแม่นยำที่ยังไม่ผ่านการทดสอบ ส่วนตัวเลขในหน้าสาธิตของโปรแกรมถูกระบุว่าเป็นข้อมูลตัวอย่าง ไม่ใช่ผลการทดลอง

แหล่งอ้างอิงในเนื้อหาใช้เลขในวงเล็บเหลี่ยม เช่น [1] และรวบรวมไว้ท้ายรายงาน วันที่ตรวจสอบซอร์สโค้ด: 25 กันยายน 2569

# บทคัดย่อ

Cyberpump เป็นต้นแบบซอฟต์แวร์สำหรับติดตามการฝึกเวทที่ต้องการให้ผู้ใช้เห็นทั้งการเคลื่อนไหว จำนวนครั้ง คุณภาพท่า และสัญญาณจากอุปกรณ์ในหน้าจอเดียว ปัญหาหลักคือข้อมูลจากกล้องและเซนเซอร์มีรูปแบบและจังหวะต่างกัน ทำให้การติดตามผลระหว่างฝึกและการสรุปย้อนหลังทำได้ยาก

ระบบใช้ Arduino Uno อ่าน sEMG และ FSR ส่งทาง UART ไปยัง ESP32 ซึ่งรวมค่าจาก MPU6050, MAX30102 และ MLX90614 ก่อนส่งข้อมูลผ่าน Wi-Fi ไปยัง SvelteKit ฝั่งเว็บกระจายข้อมูลสดด้วย Server-Sent Events และส่งข้อมูลช่วงที่บันทึกไปยัง FastAPI กับ MongoDB การนับครั้งหลักใช้ MediaPipe วิเคราะห์มุมข้อศอก ส่วน OpenCV.js นับการเคลื่อนไหวเพื่อแสดงค่าเทียบเคียง [1][2][3]

ผลที่ยืนยันได้จากโค้ดคือมีเส้นทางรับข้อมูล การแสดงผลสด การปรับเทียบเซนเซอร์ การบันทึกผลเซต และการส่งออก CSV/JSON พร้อมชุดโปรแกรมตรวจอุปกรณ์และบันทึกปัญหาฮาร์ดแวร์ อย่างไรก็ตาม ยังไม่มีผลทดลองครบชุดสำหรับประเมินความแม่นยำ ความหน่วง หรือความทนทานของระบบจริง จึงเว้นบทผลการทดสอบไว้ให้เติมหลังวัดผล

คำสำคัญ: การฝึกเวท, sEMG, ESP32, MediaPipe, ระบบติดตามแบบเรียลไทม์

# สารบัญ

คำนำ | 1
บทคัดย่อ | 2
สารบัญ | 3
สารบัญรูปและตาราง | 4
บทที่ 1 บทนำ | 5
บทที่ 2 ความต้องการและงานที่เกี่ยวข้อง | 7
บทที่ 3 การออกแบบระบบ | 10
บทที่ 4 การพัฒนา | 13
บทที่ 5 ข้อมูลจากเซนเซอร์ | 15
บทที่ 6 การจัดเก็บข้อมูลและการนำไปใช้ | 19
บทที่ 7 โครงสร้างและการทำงานของโค้ด | 23
บทที่ 8 การทดสอบและผลลัพธ์ | 28
บทที่ 9 ปัญหาที่พบและวิธีแก้ไข | 29
บทที่ 10 สรุปและแนวทางพัฒนา | 31
เอกสารอ้างอิง | 32
ภาคผนวก | 34

เลขหน้าสารบัญอ้างอิงจากการจัดหน้าในไฟล์ต้นฉบับ หาก Google Docs ปรับระยะบรรทัดหรือฟอนต์ อาจต้องอัปเดตเลขหน้าในสารบัญ

# สารบัญรูปและตาราง

## สารบัญรูป

รูปที่ 3.1 การเชื่อมต่อข้อมูลจากอุปกรณ์ถึงเว็บและฐานข้อมูล | 10
รูปที่ 7.1 ผังการไหลของข้อมูลในระบบ | 27

## สารบัญตาราง

ตารางที่ 2.1 แหล่งข้อมูลที่ระบบรับเข้าและการใช้งาน | 7
ตารางที่ 2.2 ความต้องการหลักของระบบ | 8
ตารางที่ 3.1 ลำดับการไหลของข้อมูล | 10
ตารางที่ 4.1 เทคโนโลยีที่ใช้พัฒนา | 13
ตารางที่ 5.1 ค่าอ่านโดยตรงและค่าที่ใช้จากแต่ละเซนเซอร์ | 15
ตารางที่ 5.2 จังหวะอ่านและการคำนวณค่า | 16
ตารางที่ 6.1 Collections และฟิลด์สำคัญ | 19
ตารางที่ 6.2 วัตถุประสงค์ของข้อมูลที่จัดเก็บ | 20
ตารางที่ 7.1 แผนผังส่วนประกอบของ codebase | 23
ตารางที่ 9.1 ปัญหาฮาร์ดแวร์ที่บันทึกไว้ | 29
ตารางภาคผนวก ข.1 ตัวอย่างโครงข้อมูล | 34

# บทที่ 1 บทนำ

## 1.1 ที่มาและความสำคัญของปัญหา

การฝึกเวททั่วไปมักบันทึกเพียงน้ำหนัก จำนวนเซต และจำนวนครั้ง ข้อมูลดังกล่าวไม่บอกว่าผู้ฝึกเคลื่อนไหวครบช่วงหรือใช้ท่าชดเชยมากน้อยเพียงใด ในอีกด้านหนึ่ง เซนเซอร์ไฟฟ้ากล้ามเนื้อ แรงกด การเคลื่อนไหว และสัญญาณชีพสามารถให้บริบทเพิ่มเติม แต่ต้องออกแบบการรับและแสดงผลให้เข้าใจง่าย [1][2]

Cyberpump จึงรวมข้อมูลจากกล้องและชุดเซนเซอร์ไว้ในหน้า Live Studio เพื่อให้ผู้ใช้เห็นจำนวนครั้ง มุมข้อศอก ค่าที่วัดได้ และสัญญาณเตือนระหว่างฝึก พร้อมสรุปผลรายเซตเมื่อหยุดการฝึก ขอบเขตนี้เป็นระบบสนับสนุนการติดตามการออกกำลังกาย ไม่ใช่เครื่องมือวินิจฉัยทางการแพทย์

## 1.2 ปัญหาที่ต้องการแก้ไข

- ข้อมูลแต่ละแหล่งส่งมาไม่พร้อมกันและมีหน่วยต่างกัน จึงต้องแปลงและแสดงสถานะความสดของข้อมูลให้ชัด
- การนับครั้งจากการมองเห็นอาจคลาดเคลื่อนเมื่อมุมกล้องหรือแสงไม่เหมาะสม
- การดูผลย้อนหลังต้องเชื่อมช่วงบันทึกข้อมูลกับบัญชีผู้ใช้ เซต และเซสชัน
- ฮาร์ดแวร์หลายตัวบนบัส I2C และลิงก์ UART มีจุดต่อและการตั้งค่าที่เกิดปัญหาได้ง่าย

## 1.3 วัตถุประสงค์ของโครงงาน

- พัฒนาทางรับและแสดง telemetry จากชุดเซนเซอร์ในเว็บแดชบอร์ดแบบสด
- ใช้กล้องช่วยนับครั้งและตรวจท่าชดเชย พร้อมแสดงตัวนับการเคลื่อนไหวอีกทางเพื่อเทียบเคียง
- รองรับการปรับเทียบค่า บันทึกผลรายเซต และส่งออกข้อมูลที่บันทึกเป็น CSV หรือ JSON
- จัดทำเครื่องมือวินิจฉัยและเอกสารการต่ออุปกรณ์เพื่อให้ตรวจสอบปัญหาซ้ำได้

## 1.4 ขอบเขตของระบบและงานที่ดำเนินการ

งานครอบคลุมเฟิร์มแวร์ Arduino Uno/ESP32, เว็บแอป SvelteKit, API FastAPI และฐานข้อมูล MongoDB รวมถึงชุดโปรแกรมทดสอบเซนเซอร์ ผู้ใช้ทำงานผ่านเบราว์เซอร์ โดยเปิดกล้องเมื่อต้องการใช้การนับครั้งจากภาพ ข้อมูล telemetry สดยังแสดงได้แม้ไม่ได้เริ่มบันทึก ส่วนการส่งต่อไปฐานข้อมูลถูกเปิดเฉพาะช่วงเริ่มบันทึกเซต [3][4]

ข้อจำกัดสำคัญคือระบบบันทึก telemetry รองรับชุดอุปกรณ์ร่วมหนึ่งชุดและช่วงบันทึกที่ใช้งานพร้อมกันหนึ่งรายการในโพรเซสเว็บ หากต้องการรองรับหลายชุดพร้อมกันต้องออกแบบการแยกสถานะและการจัดการเซสชันใหม่ [4]

# บทที่ 2 ความต้องการและงานที่เกี่ยวข้อง

## 2.1 กลุ่มผู้ใช้และลักษณะการใช้งาน

ผู้ใช้หลักคือผู้ฝึกเวทที่ต้องการดูค่าระหว่างออกกำลังกายและทบทวนสรุปผล ผู้ดูแลหรือผู้พัฒนาระบบใช้หน้าปรับเทียบกับโปรแกรมวินิจฉัยเพื่อตรวจเซนเซอร์ก่อนใช้งาน เส้นทางผู้ใช้บนเว็บประกอบด้วย Readiness, Live Studio, Post Set, Analytics และ Calibration ตามองค์ประกอบหน้าแดชบอร์ด [5]

ลำดับใช้งานทั่วไปคือเข้าสู่ระบบ ตรวจสถานะอุปกรณ์ ปรับเทียบเมื่อจำเป็น เลือกท่าและน้ำหนัก เปิดกล้อง เริ่มเซต ดูข้อมูลสด หยุดเซต แล้วดูสรุปหรือเริ่มเซตถัดไป หากต้องการเก็บข้อมูลดิบสำหรับวิเคราะห์เพิ่มเติม ผู้ใช้สามารถส่งออกข้อมูลที่บันทึกในเบราว์เซอร์ได้

## 2.2 ข้อมูลที่ระบบรับเข้า ประมวลผล และแสดงผล

ตารางที่ 2.1 แหล่งข้อมูลที่ระบบรับเข้าและการใช้งาน

แหล่งข้อมูล | ข้อมูลรับเข้า | การใช้ในระบบ
กล้องเว็บแคม | ภาพวิดีโอและตำแหน่งข้อต่อ | คำนวณมุมข้อศอก สถานะการเคลื่อนไหว และคำเตือนท่า
sEMG | ค่า ADC / ค่าที่ปรับเทียบ | แสดงสัญญาณและค่าที่เกี่ยวกับการเกร็ง
FSR | ค่า ADC / ความนิ่ง | ประมาณแรงกำและแสดงสถานะความนิ่ง
MPU6050 | ความเร่ง มุมเอียง และความเร็วที่คำนวณ | แสดงการเคลื่อนไหวและ velocity loss
MAX30102 | อัตราการเต้นหัวใจและ SpO₂ ที่เฟิร์มแวร์ประเมิน | แสดงค่าชีพจรและออกซิเจน
MLX90614 | อุณหภูมิผิว | แสดงค่าอุณหภูมิและส่วนต่าง

ค่ากายภาพบางชนิดในโค้ดอาศัยสมมติฐานการแปลง เช่น gain ของวงจร sEMG และแรง FSR เต็มสเกล จึงต้องปรับเทียบและตรวจสอบกับอุปกรณ์จริงก่อนนำตัวเลขไปตีความเชิงปริมาณ [4]

## 2.3 ความต้องการด้านการทำงานและข้อกำหนดอื่นของระบบ

ตารางที่ 2.2 ความต้องการหลักของระบบ

รหัส | ความต้องการ | หลักฐานในระบบ
F1 | รับและแสดง telemetry สด | POST /api/telemetry และ SSE /api/telemetry/stream [4]
F2 | นับครั้งจากกล้องและแสดงคำเตือนท่า | MediaPipe ใน Live Studio [5]
F3 | แสดงตัวนับภาพอีกทางเพื่อเทียบเคียง | OpenCV.js motion counter [6]
F4 | ปรับเทียบค่า sEMG/FSR ของผู้ใช้ | GET/POST /v1/calibration [7]
F5 | บันทึกผลเซตและส่งออกข้อมูล | /v1/sessions และ CSV/JSON ในเบราว์เซอร์ [5][8]
N1 | ป้องกันการเข้าถึงข้อมูลผู้ใช้ | บัญชีผู้ใช้และโทเค็นใน FastAPI [9]
N2 | จำกัดอายุข้อมูล telemetry | TTL index ใน MongoDB [10]

ความต้องการด้านความหน่วง ความแม่นยำ และเสถียรภาพยังไม่มีเกณฑ์เชิงตัวเลขที่ผ่านการยืนยัน จึงกำหนดเป็นรายการวัดในบทที่ 8 แทนการระบุว่าบรรลุแล้ว

## 2.4 แนวคิด เครื่องมือ หรืองานที่เกี่ยวข้อง

SvelteKit ใช้จัดหน้าเว็บและ API ฝั่งเซิร์ฟเวอร์ ส่วน FastAPI ให้ API สำหรับบัญชีผู้ใช้ ผลเซต การปรับเทียบ และข้อมูลย้อนหลัง [11][12] MediaPipe Pose ให้ตำแหน่งข้อต่อเพื่อคำนวณมุมข้อศอก ขณะที่ OpenCV.js ตรวจการเปลี่ยนแปลงของพิกเซลเพื่อแสดงตัวนับอิสระ ทั้งสองวิธีมีสัญญาณเข้าต่างกัน จึงควรเปรียบเทียบด้วยการทดลองจริงก่อนตีความความคลาดเคลื่อน [6][13]

ESP32 ใช้ FreeRTOS แยกงานอ่านเซนเซอร์ เครือข่าย จอ LCD และปุ่มควบคุม โดยมี timer, queue, semaphore และ mutex ช่วยประสานงาน ส่วน Arduino Uno ใช้ Timer1 และ ADC interrupt ในงานอ่านค่า เนื่องจากทรัพยากรจำกัด [3][14]

# บทที่ 3 การออกแบบระบบ

## 3.1 ภาพรวมสถาปัตยกรรมและองค์ประกอบของระบบ

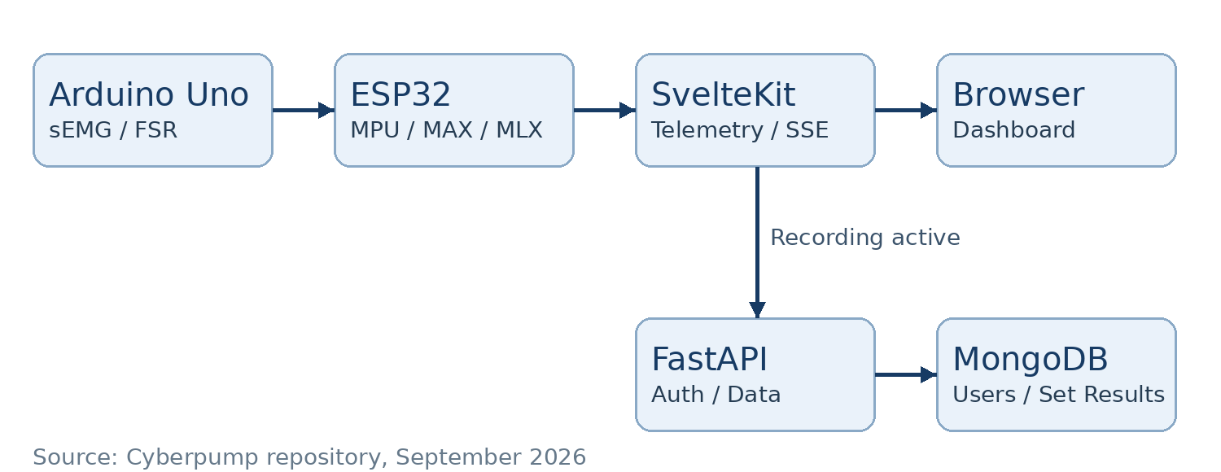
[picture p1: figure]

รูปที่ 3.1 การเชื่อมต่อข้อมูลจากอุปกรณ์ถึงเว็บและฐานข้อมูล

Arduino Uno อ่าน sEMG และ FSR แล้วส่งคู่ค่าไปยัง ESP32 ผ่าน UART; ESP32 อ่าน MPU6050, MAX30102 และ MLX90614 บน I2C แล้วส่ง packet ผ่าน Wi-Fi ไปยัง SvelteKit ฝั่งเว็บเก็บสถานะล่าสุดในหน่วยความจำและส่ง Server-Sent Events ไปยังเบราว์เซอร์ เมื่อผู้ใช้เริ่มบันทึกเซต ระบบจึงส่ง packet ไปยัง FastAPI เพื่อเก็บใน MongoDB [1][3][4]

กล้องอยู่ฝั่งเบราว์เซอร์ MediaPipe คำนวณตำแหน่งข้อต่อเพื่อใช้เป็นตัวนับหลัก ส่วน OpenCV.js คำนวณระดับการเคลื่อนไหวเพื่อแสดงเป็นค่าตรวจสอบไขว้ ไม่เพิ่มจำนวนครั้งเข้าเซต [6]

## 3.2 ลำดับขั้นตอนและการไหลของข้อมูล

ตารางที่ 3.1 ลำดับการไหลของข้อมูล

ขั้น | ผู้รับผิดชอบ | ผลลัพธ์
1 | Uno และ ESP32 | อ่านค่าเซนเซอร์ รวม packet และส่ง HTTP POST
2 | SvelteKit server | แปลงค่าที่จำเป็น เก็บ snapshot ล่าสุด และกระจาย SSE
3 | เบราว์เซอร์ | อัปเดตกราฟ สถานะเซนเซอร์ กล้อง และสรุประหว่างเซต
4 | SvelteKit → FastAPI | ส่ง telemetry พร้อม user_id/session_id ระหว่างบันทึก
5 | FastAPI → MongoDB | เก็บ telemetry และผลเซต; ส่งข้อมูลย้อนหลังตามผู้ใช้

การแยกเส้นทางข้อมูลสดกับเส้นทางบันทึกทำให้หน้าเว็บยังเห็นสถานะอุปกรณ์เมื่อไม่ได้เริ่มเซต ข้อมูลเซตเก็บผ่าน endpoint ของ FastAPI โดยมีรายการการนับครั้งและเมตริกสรุป ส่วนข้อมูล telemetry มีดัชนี TTL ตามค่าตั้งการเก็บรักษา [4][8][10]

## 3.3 การออกแบบขั้นตอนประมวลผล

ฝั่งกล้องใช้มุมที่จุดไหล่ ข้อศอก และข้อมือเป็นสัญญาณของท่า เมื่อข้อศอกงอถึง 70 องศาหรือน้อยกว่า ระบบจำว่าผ่านจุดสูงสุด และเมื่อกลับไปอย่างน้อย 140 องศาจึงนับหนึ่งครั้งระหว่างเซต หากมีคำเตือนลำตัวเหวี่ยงหรือยักไหล่ระหว่างรอบนั้น จะจัดเป็นครั้งที่ไม่สะอาดตามตรรกะในโค้ด [5]

ค่า form purity คำนวณจากจำนวนครั้งที่จัดว่าสะอาดหารด้วยจำนวนครั้งทั้งหมด ส่วน effective reps ในโค้ดนับเฉพาะครั้งสะอาดที่ velocity loss ตั้งแต่ 25% ขึ้นไป ค่านี้เป็นเกณฑ์เชิงซอฟต์แวร์ของต้นแบบ ยังไม่ใช่ข้อสรุปทางสรีรวิทยาที่ผ่านการทดสอบ [5]

เซิร์ฟเวอร์แปลงค่า ADC ของ sEMG โดยหักกึ่งกลางสเกลและ baseline แล้วประมาณหน่วย µV จากแรงดันอ้างอิงกับ gain สมมติ ค่า FSR ถูกเทียบช่วง zero/max ที่ปรับเทียบและสเกลแรงเต็มที่กำหนดไว้ล่วงหน้า การอ่านค่าแบบนี้เหมาะกับต้นแบบ แต่ต้องสอบเทียบวงจรจริงก่อนใช้เป็นค่ามาตรฐาน [4]

## 3.4 การออกแบบส่วนติดต่อผู้ใช้

หน้า Live Studio วางภาพกล้อง ตัวนับครั้ง กราฟ sEMG และสถานะเซนเซอร์ในบริบทเดียวกัน หน้า Calibration ปรับ sEMG baseline/MVC และ FSR zero/max หน้า Post Set แสดงสรุปรายเซต และ Analytics แสดงภาพรวมการฝึก องค์ประกอบแสดงสถานะ live, stale หรือ never seen เพื่อไม่ให้ค่าเก่าถูกตีความเป็นค่าที่กำลังวัด [5]

ค่าบางส่วนในหน้า Analytics และสถานะอุปกรณ์เริ่มต้นเป็นข้อมูลตัวอย่างในซอร์สโค้ด ดังนั้นหน้าจอที่แสดงค่าเหล่านี้ต้องมีป้ายกำกับข้อมูลสาธิตเมื่อนำไปสาธิตหรืออ้างในรายงาน [5]

# บทที่ 4 การพัฒนา

## 4.1 ภาษา เครื่องมือ และสภาพแวดล้อมที่ใช้พัฒนา

ตารางที่ 4.1 เทคโนโลยีที่ใช้พัฒนา

ส่วน | เทคโนโลยี | หน้าที่
เฟิร์มแวร์ | C++ / Arduino / PlatformIO | อ่านเซนเซอร์ ควบคุมงานหลาย task และส่งข้อมูล
เว็บแอป | TypeScript / SvelteKit / Svelte 5 | แดชบอร์ด API รับ telemetry และ SSE
บริการข้อมูล | Python / FastAPI / Pydantic | บัญชีผู้ใช้ การปรับเทียบ ผลเซต และ telemetry
ฐานข้อมูล | MongoDB | เก็บบัญชี ผลเซต ค่า calibration และ telemetry
ภาพจากกล้อง | MediaPipe Pose / OpenCV.js | วิเคราะห์ท่าและแสดงตัวนับตรวจสอบ
สภาพแวดล้อม | Node.js, Python, Docker Compose | รันเว็บ API และฐานข้อมูลในเครื่องพัฒนา

ไฟล์ README ระบุการรัน MongoDB ผ่าน Docker Compose, FastAPI ที่พอร์ต 9000 และ SvelteKit ที่พอร์ต 5173 โดยตั้งค่าในไฟล์ .env ของแต่ละส่วน [1][9]

## 4.2 โครงสร้างซอฟต์แวร์และหน้าที่ของส่วนประกอบหลัก

โฟลเดอร์ test-sensor/ มีเฟิร์มแวร์หลักและโปรแกรมทดสอบรายเซนเซอร์ backend/app/ แบ่ง models และ routers ตามทรัพยากร frontend/src/lib/workout/ ดูแลสถานะการฝึก ส่วน frontend/src/lib/server/telemetryStore.ts รับข้อมูลและกระจายสัญญาณสด [1][2][4]

ฐานข้อมูลแยก users, refresh_tokens, telemetry_samples, session_results และ calibrations มีดัชนีสำหรับอีเมล โทเค็น ผลเซตตามผู้ใช้ และอายุข้อมูล telemetry [10]

## 4.3 การพัฒนาฟังก์ชันหลักและการเชื่อมต่อระหว่างส่วนประกอบ

เฟิร์มแวร์ ESP32 แยก SensorTask, NetworkTask, LcdTask และ ControlTask โดยใช้ timer ปลุกการอ่านค่า, queue ส่งตัวอย่าง sEMG และเหตุการณ์ปุ่ม, mutex คุ้มครองสถานะและ I2C ร่วม พร้อม watchdog กับ light sleep ตามเอกสารสถาปัตยกรรม เฟิร์มแวร์ Uno ใช้ Timer1 และ ADC interrupt เพื่ออ่าน sEMG/FSR ประมาณ 100 Hz และส่งค่าผ่าน hardware Serial [3]

SvelteKit มี POST /api/telemetry สำหรับรับ packet และ /api/telemetry/stream สำหรับ SSE ไปยังเบราว์เซอร์ ระหว่างช่วงบันทึก server จะส่งค่าต่อไปยัง POST /v1/telemetry โดยใช้ X-Service-Token ส่วนผลเซตบันทึกผ่าน /v1/sessions ภายใต้บัญชีผู้ใช้ [4][8][9]

หน้าเว็บรองรับการบันทึกชุดตัวอย่างในเบราว์เซอร์ทุก 100 มิลลิวินาที สูงสุด 12,000 ตัวอย่าง แล้วส่งออกเป็น CSV หรือ JSON การบันทึกชนิดนี้แยกจากการเก็บ telemetry ใน MongoDB [5]

การปรับเทียบเก็บค่าต่อผู้ใช้ที่ FastAPI และสะท้อนกลับมายังแคชของ SvelteKit อย่างไรก็ตาม server telemetry เป็นสถานะร่วมของชุดอุปกรณ์เดียว จึงควรตรวจสอบการใช้งานหลายบัญชีพร้อมกันก่อนขยายระบบ [4][7]

# บทที่ 5 ข้อมูลจากเซนเซอร์

บทนี้อธิบายข้อมูลตามเส้นทางที่ใช้งานจริงในต้นแบบ ได้แก่ กล้องในเบราว์เซอร์, sEMG และ FSR ที่อ่านด้วย Arduino Uno, และ MPU6050/6500, MAX30102, MLX90614 ที่ต่อกับ ESP32 ค่า “อ่านโดยตรง” คือค่าจาก ADC, ตำแหน่งภาพ หรือรีจิสเตอร์/ไลบรารีเซนเซอร์ ส่วนค่าหน่วยกายภาพและคะแนนต่าง ๆ เป็นผลคำนวณของเฟิร์มแวร์หรือเว็บ [2][3][4][5]

## 5.1 กล้องและเซนเซอร์ที่ใช้: ค่าที่อ่านโดยตรง ช่วงค่า และหน่วย

ตารางที่ 5.1 ค่าอ่านโดยตรงและค่าที่ใช้จากแต่ละเซนเซอร์

แหล่ง | ค่าอ่านโดยตรงและช่วงค่า | ค่าที่ใช้ในระบบ / หน่วย
กล้องเว็บแคม | เฟรมภาพและจุดข้อต่อแบบ normalized x,y จาก MediaPipe; อัตราเฟรมขึ้นกับเบราว์เซอร์และกล้อง | มุมข้อศอก/ลำตัว (องศา), การยักไหล่ (ซม. ตามการประมาณใน UI), จำนวนครั้ง, FPS; OpenCV.js แสดง motion level 0–100 และจำนวนครั้งเทียบเคียง
sEMG → Uno A0 | ADC 10 บิต 0–1023; Uno แปลงสเกลเป็น 0–4095 ก่อนส่ง UART | ตัวอย่าง raw ADC, ค่า µV ประมาณ, RMS/peak ที่ระบบคำนวณหรือรับจาก packet, %MVC
FSR → Uno A1 | ADC 10 บิต 0–1023; อินเวิร์ตเพราะค่าดิบลดเมื่อกด แล้วแปลงสเกลเป็น 0–4095 | แรงกำประมาณ (N) และความนิ่งจากช่วงแกว่งของ ADC (%)
MPU6050/6500 → ESP32 | ค่าแกนความเร่ง 16 บิตจากรีจิสเตอร์ I2C โดยตั้งช่วง ±8g | ax, ay, az (m/s²), pitch/roll (องศา), ความเร็วจากการอินทิเกรตความเร่ง (ประมาณ m/s)
MAX30102 → ESP32 | ค่าแสง IR และ Red จาก FIFO; ไม่มีหน่วยกายภาพที่ใช้แสดงโดยตรง | ชีพจรเฉลี่ย (BPM) และ SpO₂ ประมาณ (%)
MLX90614 → ESP32 | ค่า object temperature จากเซนเซอร์อินฟราเรดผ่าน I2C | skinTemp และ deltaTemp เทียบ baseline (°C)

คำว่า “6 เซนเซอร์” ในเอกสารโครงงานนับกล้องเป็นหนึ่งแหล่งข้อมูลร่วมกับอุปกรณ์ sEMG, FSR, MPU, MAX และ MLX กล้องประมวลผลในเบราว์เซอร์โดยไม่ส่งเฟรมภาพใน packet ของ ESP32 และตัวนับ OpenCV ไม่เข้า workout.recordRep() [5][6]

เฟิร์มแวร์หลักอ่านเฉพาะรีจิสเตอร์ความเร่งของ MPU เพื่อคำนวณ pitch, roll และ velocity แม้ตัวโมดูลจะมีไจโรสโคปด้วย จึงไม่ควรอธิบายว่าโค้ดปัจจุบันใช้ค่า gyro ในการคำนวณ [3]

## 5.2 อัตราการอ่าน การปรับเทียบ และค่าที่คำนวณต่อ

ตารางที่ 5.2 จังหวะอ่านและการคำนวณค่า

รายการ | จังหวะหรือสูตรในโค้ด | ความหมายและข้อจำกัด
Uno → ESP32 | Timer1 CTC ทุก 10 ms ≈ 100 Hz; UART 9600 baud | ส่งคู่ค่า emg,fsr หนึ่งบรรทัดต่อรอบ ADC ที่สมบูรณ์
ESP32 SensorTask | hardware timer ทุก 10 ms ≈ 100 Hz | อ่าน UART/เซนเซอร์และอัปเดต snapshot; MAX อ่านข้อมูล FIFO ที่พร้อม
ESP32 NetworkTask | ส่ง HTTP POST ทุก 250 ms ≈ 4 ครั้ง/วินาที | ดึงตัวอย่าง EMG จาก queue เป็นอาร์เรย์; ความถี่ส่งไม่เท่ากับความถี่อ่าน
MLX90614 | อ่านทุก 250 ms | อุณหภูมิอัปเดตช้ากว่ารอบ SensorTask
FSR stability | ช่วงค่าสูงสุด–ต่ำสุดของ 20 ตัวอย่าง; ช่วงแกว่ง 200 ADC counts เท่ากับ 0% | เป็นคะแนนความนิ่งที่นิยามในต้นแบบ ไม่ใช่หน่วยแรง
ชีพจร/SpO₂ | beat detection และเฉลี่ย BPM 4 ค่า; SpO₂ ใช้อัตราส่วน AC/DC ในหน้าต่าง 200 ตัวอย่าง | เป็นค่าประมาณจากสูตรในเฟิร์มแวร์ ไม่ใช่เครื่องมือแพทย์

หลังรับค่า sEMG เว็บคำนวณ µV ประมาณจาก (ADC − 4095/2) × 3300/4095 × 1000/gain − baseline โดยกำหนด gain สมมติ 1000 และแรงดันอ้างอิง 3.3 V ถ้า packet ไม่ให้ RMS เว็บใช้ |µV| × 1.1 เป็นค่าแทน ซึ่งไม่ใช่ RMS ที่คำนวณจากหน้าต่างสัญญาณจริง จากนั้นหารด้วยค่า MVC ที่ปรับเทียบเพื่อแสดง %MVC [4]

FSR แปลงเป็น N ประมาณจาก max(0, ADC − fsrZero) / max(1, fsrMax − fsrZero) × 50 โดย 50 N เป็นค่าเต็มสเกลที่สมมติ ไม่ใช่ผลการสอบเทียบแรงจริง ค่า sEMG จาก Uno เริ่มที่ ADC อ้างอิง AVcc ของ Uno แล้วถูกสเกลตัวเลขเป็นช่วง 12 บิตก่อนเข้าเว็บ ขณะที่สูตรเว็บใช้แรงดันอ้างอิง 3.3 V จึงต้องตรวจวงจรขยายและสอบเทียบก่อนตีความค่า µV เป็นค่าทางกายภาพ [2][4]

หน้า Calibration บันทึก emgBaseline, emgMvc, fsrZero และ fsrMax ต่อผู้ใช้ใน MongoDB; ค่า offset ของ MPU และเกณฑ์มุมท่าบางรายการอยู่ในสถานะหน้าเว็บและไม่ได้รวมใน schema calibration ของ backend [7]

## 5.3 ฟิลด์ข้อมูลที่ส่งออกและข้อจำกัดของค่าประมาณ

ตัวอย่างรูปร่าง packet จาก ESP32 (ชื่อฟิลด์ตามเฟิร์มแวร์; ค่าเป็นตัวอย่างสมมติ)

{

"board": "esp32", "emg": {"raw": [2010, 2034]},

"fsr": {"force": 1800, "stability": 92.0},

"mpu": {"pitch": 3.2, "roll": -1.1, "velocity": 0.25,

"ax": 0.1, "ay": 0.2, "az": 9.9},

"vitals": {"hr": 78, "spo2": 97.0,

"skinTemp": 33.4, "deltaTemp": 0.3},

"buttons": {"a": false, "b": false}

}

ใน packet นี้ emg.raw และ fsr.force ยังเป็นตัวเลข ADC ที่สเกลแล้ว แม้ชื่อฟิลด์จะดูเหมือนหน่วยกายภาพ ส่วน `vitals.spo2`, `mpu.velocity` และ `deltaTemp` เป็นค่าคำนวณ เซิร์ฟเวอร์ SvelteKit แปลง ADC เป็น emg.raw/FSR gripForce ก่อนแสดงสดและบันทึกต่อ เมื่อเซนเซอร์ไม่พร้อม เฟิร์มแวร์อาจส่งศูนย์หรือค่าล่าสุด จึงต้องดูสถานะการเชื่อมต่อและ lastSeen ร่วมด้วย [3][4]

ความแม่นยำของชีพจร SpO₂ ความเร็ว แรงกำ และกล้ามเนื้อยังไม่ผ่านการวัดเปรียบเทียบในรายงานฉบับนี้ ตัวเลขตัวอย่างในตารางและ JSON ใช้อธิบายชนิดข้อมูลเท่านั้น ไม่ใช่ผลการทดลอง

# บทที่ 6 การจัดเก็บข้อมูลและการนำไปใช้

## 6.1 ภาพรวมข้อมูลสด ข้อมูลที่บันทึก และความสัมพันธ์ของข้อมูล

ระบบแยกข้อมูลสามชั้น: (1) snapshot telemetry ล่าสุดในหน่วยความจำของ SvelteKit เพื่อส่ง SSE และแสดงทันที (2) ตัวอย่างที่เบราว์เซอร์เก็บชั่วคราวเพื่อส่งออก CSV/JSON และ (3) เอกสารใน MongoDB ที่ FastAPI จัดเก็บ การรับ packet ไม่ทำให้เกิดเอกสารใน MongoDB ทุกครั้ง: telemetry ถูกส่งต่อไปฐานข้อมูลเฉพาะเมื่อผู้ใช้เริ่มช่วงบันทึกผ่าน /api/recording และมีการตั้งค่า backend/token [4][5]

`user_id` ใน session_results, calibrations, refresh_tokens และ telemetry_samples อ้างผู้ใช้ที่เกี่ยวข้องเป็นข้อความ ส่วน `session_id` เชื่อมผลเซตกับตัวอย่าง telemetry ที่บันทึกในช่วงฝึก ระบบไม่มี collection ชื่อ sessions; หนึ่ง session_id อาจมีผลหลายเซตและตัวอย่าง telemetry หลายรายการ [8][9][10]

## 6.2 Collections และฟิลด์สำคัญ

ตารางที่ 6.1 Collections และฟิลด์สำคัญ

Collection | ฟิลด์สำคัญที่โค้ดบันทึก | จุดเขียน / จุดอ่าน
users | _id, email, name, password_hash, roles, created_at, is_active | register/seed เขียน; login, /users/me และ dashboard อ่าน
refresh_tokens | jti, user_id, revoked, created_at, expires_at | login/register/refresh เขียน; refresh ตรวจและเพิกถอน; logout เพิกถอน
calibrations | user_id, emgBaseline, emgMvc, fsrZero, fsrMax, updated_at | POST /v1/calibration upsert; GET /v1/calibration และ dashboard อ่าน
session_results | user_id, session_id, setNumber, exercise, weightKg, durationSeconds, totalReps, cleanReps, cheatedReps, formPurityPercent, effectiveReps, highTensionTutSeconds, reps[], timestamp, created_at | POST /v1/sessions เขียน; GET /v1/sessions และ dashboard อ่าน
telemetry_samples | user_id, session_id, emg, fsr, mpu, vitals, device, timestamp, received_at | POST /v1/telemetry เขียนเฉพาะช่วงบันทึก; GET /v1/telemetry อ่านย้อนหลัง

MongoDB เพิ่ม `_id` ให้เอกสารแต่ละรายการ โดย backend แปลงเป็น `id` ในผล API บางชนิด ค่า `reps[]` ภายใน session_results เก็บ repNumber, concentricVelocity, rom, isClean, velocityLossPercent, peakEmg และ cheatReason ตาม model ของ FastAPI [8][10]

## 6.3 เก็บข้อมูลแต่ละประเภทเพื่อใช้ทำอะไร และส่วนใดของระบบเรียกใช้จริง

ตารางที่ 6.2 วัตถุประสงค์ของข้อมูลที่จัดเก็บ

ข้อมูลที่เก็บ | นำไปใช้ทำอะไร | สถานะการใช้งานในโค้ด
users | ยืนยันตัวตน แสดงชื่อ/โปรไฟล์ และแยกข้อมูลของแต่ละบัญชี | ใช้จริงใน login, /users/me และหน้า dashboard; เก็บ password_hash ไม่เก็บรหัสผ่านตรง ๆ
refresh_tokens | คงการเข้าสู่ระบบและหมุนเวียน refresh token โดยตรวจ jti, วันหมดอายุ และสถานะ revoked | ใช้จริงใน refresh/logout; ไม่มี TTL index สำหรับลบเอกสารที่หมดอายุอัตโนมัติ
calibrations | เก็บ baseline/MVC และช่วง FSR ของผู้ใช้ เพื่อแปลง/แสดงค่าและคำนวณ %MVC ของประวัติ | ใช้จริงผ่าน Calibration API, แคชแปลงค่าของ SvelteKit และ dashboard
session_results | เก็บผลแต่ละเซตเพื่อแสดงประวัติ สถิติส่วนบุคคล ปริมาณยกรายสัปดาห์ และพัฒนาการของฟอร์ม | ใช้จริง: dashboard server โหลด GET /v1/sessions แล้วคำนวณตัวชี้วัด
telemetry_samples | เก็บลำดับค่าจากเซนเซอร์พร้อมเวลา/ผู้ใช้/เซสชัน เพื่อเรียกย้อนดูรายละเอียดช่วงที่บันทึก | มี API GET /v1/telemetry สำหรับเรียกย้อนหลังตามผู้ใช้; ไม่พบหน้า dashboard ที่เรียก endpoint นี้โดยตรง

ตารางนี้แยก “มีข้อมูลเก็บและ API รองรับ” ออกจาก “มีหน้าจอใช้ข้อมูลแล้ว” อย่างชัดเจน การวิเคราะห์สัญญาณดิบระยะยาวจาก telemetry_samples เป็นแนวทางต่อยอด ไม่ใช่ฟังก์ชันที่ยืนยันว่า UI ปัจจุบันทำอยู่ [4][8][10]

## 6.4 ตัวอย่างเอกสาร ดัชนี การค้นคืน และอายุข้อมูล

ตัวอย่างเอกสาร MongoDB แบบย่อเพื่ออธิบายความสัมพันธ์ (ค่าทั้งหมดสมมติ)

users: { _id: ObjectId("..."), email: "user@example.test",

name: "Sample User", password_hash: "<bcrypt hash>" }

refresh_tokens: { jti: "<uuid>", user_id: "<user id>",

revoked: false, expires_at: ISODate("...") }

calibrations: { user_id: "<user id>", emgBaseline: 0,

emgMvc: 550, fsrZero: 0, fsrMax: 4095 }

session_results: { user_id: "<user id>", session_id: "<uuid>",

setNumber: 1, totalReps: 8, reps: [ ... ] }

telemetry_samples: { user_id: "<user id>", session_id: "<uuid>",

emg: { rms: 120 }, received_at: ISODate("...") }

ดัชนีในโค้ดกำหนด email และ jti ไม่ให้ซ้ำ, calibration ต่อ user_id ไม่ให้ซ้ำ, session_results ตาม user_id/created_at และ session_id, telemetry_samples ตาม user_id/received_at และ TTL บน received_at ค่าเริ่มต้นของ TELEMETRY_RETENTION_DAYS คือ 90 วัน; ค่านี้ปรับผ่าน environment ได้ ดัชนี TTL ใช้เฉพาะ telemetry_samples ไม่ได้ลบผลเซตหรือบัญชีผู้ใช้ [10]

GET /v1/sessions กรอง user_id และเลือก session_id ได้ ส่วน GET /v1/telemetry กรอง user_id, `since` และ `limit` จึงเป็นการอ่านข้อมูลของบัญชีที่ยืนยันตัวตนแล้ว การบันทึก telemetry ใช้ X-Service-Token ระหว่าง SvelteKit กับ FastAPI ขณะที่ผลเซตใช้โทเค็นผู้ใช้ [8][9][10]

# บทที่ 7 โครงสร้างและการทำงานของโค้ด

## 7.1 แผนผัง codebase และหน้าที่ของเฟิร์มแวร์ เว็บ และ API

ตารางที่ 7.1 แผนผังส่วนประกอบของ codebase

พื้นที่โค้ด | องค์ประกอบหลัก | หน้าที่และทางเชื่อม
test-sensor/src/ | uno_emg_fsr_link.cpp; esp32_workout_firmware.cpp; โปรแกรมตรวจเซนเซอร์รายตัว | อ่านอุปกรณ์ ส่ง UART/HTTP และตรวจการต่อฮาร์ดแวร์
test-sensor/include/ | board_config.h | กำหนดขา ระดับ ADC และค่าตามชนิดบอร์ด
frontend/src/routes/api/ | telemetry, telemetry/stream, recording, calibration, proxy | รับ POST จาก ESP32, ส่ง SSE, คุมช่วงบันทึก, ติดต่อ backend
frontend/src/lib/server/ | telemetryStore.ts | แปลงค่า รักษา snapshot สด กระจายเหตุการณ์ และส่งต่อช่วงบันทึก
frontend/src/lib/workout/ และ components/workout/ | telemetry, workout, recording, calibration, cameraRepCounter, หน้า UI | นับครั้ง จัดเซต แสดงกราฟ/สถานะ และส่งออกไฟล์
backend/app/ | routers, models, security, db, config | ตรวจสิทธิ์ รับ/อ่านเอกสาร และสร้างดัชนี MongoDB
docs/, PINS.md, TROUBLESHOOTING.md | คู่มือและบันทึกวินิจฉัย | อธิบายพิน กลไกเฟิร์มแวร์ และปัญหาจากฮาร์ดแวร์

เส้นทางทำงานหลักของโค้ดอ่านจากไฟล์ต้นทาง ไม่รวม dependency ใน node_modules หรือไลบรารีที่ติดตั้งมา โฟลเดอร์ Arduino IDE มี sketch คู่กับซอร์ส PlatformIO และมีการคัดลอกให้ตรงกันด้วยมือ [1][2][3]

## 7.2 Arduino Uno: Timer1, ADC Interrupt, Watchdog และ UART

Timer1 ทำงานโหมด CTC โดยใช้ prescaler 64 และ OCR1A = 2499 เมื่อ F_CPU = 16 MHz จึงเกิด compare match ทุก 10 ms หรือ 100 รอบต่อวินาที ISR ตั้ง FLAG_TIMER_TICK แล้วจบ งานอ่าน ADC ทำในลูปหลักเพื่อลดเวลาใน interrupt [2][3]

แกนของจังหวะอ่านค่า Uno (ย่อจาก uno_emg_fsr_link.cpp)

#define TIMER1_OCR1A_VALUE ((F_CPU / 64UL / 100) - 1)

ISR(TIMER1_COMPA_vect) { eventFlags |= FLAG_TIMER_TICK; }

// loop(): start A0 ADC; ISR chains A1 ADC

ISR(ADC_vect) {

int value = ADC;

if (currentAdcChannel == ADC_CHANNEL_EMG) {

emgRawIsr = value;

startAdcConversion(ADC_CHANNEL_FSR);

} else { fsrRawIsr = value; eventFlags |= FLAG_FSR_READY; }

}

ADC interrupt อ่านช่อง A0 (sEMG) แล้วเริ่ม A1 (FSR) ต่อทันที ลูปรอ FLAG_FSR_READY ด้วย sleep_mode() จากนั้นคัดลอกตัวแปร volatile ในช่วงปิด interrupt สั้น ๆ ค่า 10 บิตถูกสเกลเป็น 12 บิต โดยกลับทิศ FSR ก่อนส่ง เพื่อให้ค่ามากหมายถึงแรงกดมาก [2]

Uno ใช้ hardware Serial pin 0/1 ที่ 9600 baud ส่งบรรทัด “<emg>,<fsr>” ไปยัง ESP32 ไม่มี FreeRTOS บน Uno; ใช้ AVR watchdog 2 วินาที โดยเรียก wdt_reset() หลังรอบอ่านและส่งเสร็จเท่านั้น รวมถึง SLEEP_MODE_IDLE เพื่อรอ timer/ADC interrupt ข้อจำกัดคือ pin 0/1 ใช้ร่วมกับ USB upload/debug จึงต้องจัดการสายเมื่อต้องอัปโหลด [2][3][15]

## 7.3 ESP32: FreeRTOS, Hardware Timer, GPIO Interrupt, Watchdog, I2C และการส่งข้อมูล

ESP32 สร้าง SensorTask (core 1, priority 3), NetworkTask (core 0, priority 2), LcdTask (core 1, priority 1) และ ControlTask (core 1, priority 2) การแยก NetworkTask ช่วยให้การรอ HTTP ไม่อยู่ในรอบอ่านเซนเซอร์โดยตรง แต่ความสำเร็จและความหน่วงจริงยังต้องทดสอบ [3]

การปลุก SensorTask ด้วย hardware timer (ย่อจาก esp32_workout_firmware.cpp)

void IRAM_ATTR onSampleTimer() {

BaseType_t higher = pdFALSE;

xSemaphoreGiveFromISR(sampleTickSemaphore, &higher);

if (higher) portYIELD_FROM_ISR();

}

// ทุก 10 ms: SensorTask รอ semaphore ก่อนอ่าน UART/I2C

xSemaphoreTake(sampleTickSemaphore, portMAX_DELAY);

Timer ปลุก SensorTask ทุก 10 ms; ISR ทำเพียงให้ semaphore ส่วน GPIO32/33 ใช้ falling-edge interrupt ตั้งเหตุการณ์ปุ่มลง buttonEventQueue หลัง debounce ประมาณ 250 ms แล้วให้ ControlTask ประมวลผลภายหลัง `emgQueue` ส่งตัวอย่างจาก SensorTask ไป NetworkTask ถ้าคิวเต็มโค้ดทิ้งตัวอย่างเก่าก่อนเพื่อไม่ให้ task อ่านเซนเซอร์ค้าง [3]

บัส I2C ที่ GPIO21/22 ใช้ร่วมกันระหว่าง MPU (0x68), MAX30102 (0x57), MLX90614 (0x5A) และ LCD (ปกติ 0x27) `i2cMutex` ป้องกัน SensorTask กับ LcdTask เรียก Wire พร้อมกัน; `stateMutex` ป้องกัน snapshot ร่วม เฟิร์มแวร์ตั้งบัสหลักที่ 100 kHz และมีการตั้งค่าความเร็วเฉพาะช่วงเริ่ม MAX30102 [2][3]

ESP32 ลงทะเบียน task ทั้งสี่กับ task watchdog timeout 5 วินาที และแต่ละ task รีเซต watchdog ระหว่างทำงาน เมื่อ idle ตามเงื่อนไขนาน 5 นาที ระบบสามารถเข้า light sleep โดยถอด task จาก watchdog ก่อนหลับ แล้วเริ่มใหม่หลังตื่น เพื่อไม่ให้การพักถูกตีความว่าค้าง [3]

Serial2 ที่ GPIO16/17 รับบรรทัด UART 9600 baud จาก Uno; parser ยอมรับเฉพาะบรรทัดที่แปลงเป็นจำนวนเต็มสองค่าได้ และรายงานลิงก์หายเมื่อไม่มีบรรทัดถูกต้อง 500 ms หลังอ่านเซนเซอร์ NetworkTask ดึงตัวอย่าง EMG จาก queue รวมกับ snapshot แล้วส่ง JSON ไปยัง /api/telemetry ทุก 250 ms เฉพาะเมื่อ Wi-Fi เชื่อมต่อ [3]

## 7.4 เว็บและเซิร์ฟเวอร์: รับ telemetry, กระจาย SSE, เริ่ม/หยุดบันทึก, ส่งต่อ FastAPI และเก็บ MongoDB

SvelteKit route POST /api/telemetry รับ FullTelemetryPacket และเรียก ingestFullTelemetry() เพื่อแปลงค่า อัปเดตสถานะล่าสุด และกระจาย event: telemetry ผ่าน GET /api/telemetry/stream ไปยังเบราว์เซอร์ เมื่อ packet มีธงปุ่ม a/b จะส่ง event: button เพิ่ม การแสดงสดไม่ขึ้นกับการบันทึกฐานข้อมูล [4]

ผู้ใช้ที่ผ่านการยืนยันตัวตนสั่ง POST /api/recording ด้วย action start/stop และ sessionId เพื่อเปิด/ปิด recording slot ร่วมหนึ่งชุด หากอีกผู้ใช้กำลังบันทึกจะได้ 409; slot หมดอายุอัตโนมัติหลัง 10 นาที ข้อมูล telemetry ถูกส่งต่อเป็น POST /v1/telemetry เฉพาะเมื่อ slot ยัง active และมี BACKEND_API_URL กับ TELEMETRY_SERVICE_TOKEN [4]

แกนการส่งต่อ telemetry ไป FastAPI (ย่อจาก telemetryStore.ts)

if (!recording || !backendUrl || !serviceToken) return;

fetch(`${backendUrl}/v1/telemetry`, {

method: 'POST',

headers: { 'Content-Type': 'application/json',

'X-Service-Token': serviceToken },

body: JSON.stringify({ emg, fsr, mpu, vitals, device,

user_id: recording.userId,

session_id: recording.sessionId })

});

FastAPI ตรวจ X-Service-Token แล้วเพิ่ม received_at ก่อน insert เข้า telemetry_samples ส่วน POST /v1/sessions ใช้ access token ของผู้ใช้ เพิ่ม user_id/created_at แล้ว insert ผลรายเซต หน้า dashboard server เรียก GET /v1/sessions และ GET /v1/calibration เพื่อคำนวณสถิติประวัติ การส่งต่อ telemetry เป็น fetch ที่จับ error เพื่อ log แต่ไม่มี durable retry queue จึงอาจสูญข้อมูลบาง packet เมื่อ backend หรือเครือข่ายล้มเหลว [4][8][10][16]

การส่งออก CSV/JSON เป็นอีกเส้นทางหนึ่ง: recording.svelte.ts เก็บ snapshot ที่เบราว์เซอร์ทุก 100 ms จำกัด 12,000 ตัวอย่าง แล้วสร้างไฟล์ดาวน์โหลดในเครื่องผู้ใช้ ไฟล์นี้ไม่ใช่เอกสารจาก MongoDB โดยตรง [5]

## 7.5 เส้นทางข้อมูลแบบครบวงจรและตัวอย่างโค้ดสำคัญ

รูปที่ 7.1 ผังการไหลของข้อมูลในระบบ

Uno A0/A1 --ADC 100 Hz--> UART "emg,fsr" --9600 baud--> ESP32

ESP32 --I2C--> MPU / MAX30102 / MLX90614

ESP32 --HTTP POST JSON ทุก 250 ms--> SvelteKit /api/telemetry

SvelteKit --SSE--> Browser Live Studio

SvelteKit --recording active + service token-->

FastAPI /v1/telemetry --> MongoDB telemetry_samples

Browser --POST set result + user token-->

FastAPI /v1/sessions --> MongoDB session_results

ตัวอย่าง JSON ในบทที่ 5 และเอกสารในบทที่ 6 เป็นรูปร่างข้อมูลสมมติสำหรับอธิบายการทำงาน ไม่ใช่ผลวัดจากเซนเซอร์จริง หัวข้อทั้งบทอ้างอิงโค้ดปัจจุบันเป็นหลัก โดยค่าบางอย่างในเอกสารประกอบรุ่นก่อนอาจไม่ตรงกับเฟิร์มแวร์ล่าสุด เช่น พิน UART ของ Uno [2][3][15]

# บทที่ 8 การทดสอบและผลลัพธ์

บทนี้เป็นแบบบันทึกสำหรับผลทดสอบจริงตามข้อตกลงของรายงานฉบับนี้ ยังไม่มีการรับรองผลทดลองครบชุด

## 8.1 วัตถุประสงค์ วิธีการ และสภาพแวดล้อมการทดสอบ

รอระบุ: รุ่นบอร์ดและเซนเซอร์จริง การต่อวงจร รุ่นระบบปฏิบัติการ เบราว์เซอร์ เครือข่าย จำนวนผู้เข้าร่วม และวิธีตั้งค่า/ปรับเทียบก่อนทดสอบ

## 8.2 กรณีทดสอบและเกณฑ์ประเมินผล

รอระบุ: กรณีตรวจการเชื่อมต่อเซนเซอร์ การนับครั้งจากกล้อง การส่งข้อมูลครบ packet การบันทึกผลเซต การกู้คืนเมื่อสัญญาณขาด และเกณฑ์ผ่านที่กำหนดก่อนเริ่มวัด

## 8.3 ผลการทดสอบและตัวอย่างผลลัพธ์

รอแนบ: log, ภาพหน้าจอ, ตารางค่าที่วัดจริง จำนวนครั้งอ้างอิงเทียบผลระบบ ระยะหน่วง และผลทดสอบซ้ำ พร้อมวันเวลาและเงื่อนไขการทดสอบ

## 8.4 การวิเคราะห์ผลและข้อจำกัดที่พบ

รอวิเคราะห์: ความคลาดเคลื่อน สาเหตุ ความแปรปรวนจากแสง/มุมกล้อง/การสัมผัสเซนเซอร์ และข้อจำกัดของข้อมูลตัวอย่าง

# บทที่ 9 ปัญหาที่พบและวิธีแก้ไข

## 9.1 ปัญหาที่พบระหว่างการพัฒนาและการทดสอบ

บันทึก TROUBLESHOOTING.md เก็บเหตุการณ์ระหว่างการนำฮาร์ดแวร์ขึ้นระบบ ได้แก่ log serial เพี้ยน เซนเซอร์ I2C ไม่ปรากฏ การอัปโหลด ESP32 ไม่เข้าโหมดแฟลช และลิงก์ UART ระหว่าง Uno กับ ESP32 ไม่มีข้อมูล [15]

## 9.2 สาเหตุและผลกระทบของแต่ละปัญหา

ตารางที่ 9.1 ปัญหาฮาร์ดแวร์ที่บันทึกไว้

ปัญหา | สาเหตุที่บันทึกไว้ | ผลกระทบ
log serial อ่านไม่ออก | baud monitor ไม่ตรง 115200 หรือพิมพ์ทันทีหลังเริ่ม Serial | วินิจฉัยข้อมูลบูตได้ยาก
I2C ไม่พบอุปกรณ์ | สาย SDA/SCL หรือสายเฉพาะโมดูลหลวม | ไม่มีข้อมูล MPU/MAX/MLX
ESP32 flash ไม่สำเร็จ | วงจร auto-reset เข้าโหมดดาวน์โหลดไม่เสถียร | อัปโหลดเฟิร์มแวร์ไม่ได้
UART ไม่มีข้อมูล | ต่อ Uno คนละขากับโค้ดและจุดต่อ voltage divider หลวม | ค่า sEMG/FSR ไม่ถึง ESP32

## 9.3 วิธีที่ใช้แก้ไขและเหตุผลที่เลือกวิธีนั้น

ตั้ง serial monitor ให้ตรง 115200 baud และเพิ่มช่วงรอสั้นหลัง Serial.begin เพื่อลด log บูตเพี้ยน ใช้ I2C scanner แยกปัญหาบัสรวมจากปัญหาเฉพาะโมดูล และใช้วิธี BOOT/EN ด้วยมือเมื่อ auto-reset ล้มเหลว [15]

กรณี UART ใช้โปรแกรม raw echo อ่าน byte ที่ GPIO16 เพื่อแยกปัญหาสายจากปัญหาตัว parser จากนั้นปรับ Uno ให้ใช้ hardware Serial pin 0/1 ให้ตรงกับการต่อจริงและกดจุดต่อ voltage divider ให้แน่น เหตุผลคือสัญญาณดิบช่วยตรวจได้แม้ packet ไม่สมบูรณ์ [15]

## 9.4 ผลหลังแก้ไขและปัญหาที่ยังเหลืออยู่

บันทึกระบุว่าเมื่อแก้จุดต่อแล้วตัวนับ byte วิ่งต่อเนื่องและข้อมูลรูปแบบ <emg>,<fsr> เข้ามาถูกต้อง แต่ยังไม่มีตารางวัดอัตราสูญหายของ packet หรือระยะเวลาทดสอบต่อเนื่อง จึงไม่สรุปความเสถียรเชิงปริมาณ [15]

ข้อจำกัดที่ยังต้องจัดการคือ pin 0/1 ของ Uno ใช้ร่วมกับการอัปโหลดและ USB serial monitor จึงต้องถอดสายก่อนอัปโหลด อีกทั้งเอกสาร PINS.md มีข้อมูล UART เดิมที่ไม่ตรงกับโค้ดปัจจุบัน นอกจากนี้เอกสาร OpenCV ระบุว่ายังไม่ได้ยืนยันกับเว็บแคมจริงในรอบที่บันทึกไว้ [6][15]

# บทที่ 10 สรุปและแนวทางพัฒนา

## 10.1 สรุปสิ่งที่พัฒนาและผลที่ได้เทียบกับวัตถุประสงค์

จากการตรวจซอร์สโค้ด โครงงานมีองค์ประกอบตามเป้าหมาย ได้แก่ ชุดรับข้อมูลเซนเซอร์ เส้นทางข้อมูลสด หน้าเว็บติดตามเซต การนับครั้งจากกล้อง การปรับเทียบ การบันทึกผลรายเซต และการส่งออกข้อมูล อย่างไรก็ตาม คำว่า “ใช้งานได้ตามเป้าหมาย” ในรายงานนี้หมายถึงมีโค้ดและเส้นทางทำงานรองรับ ยังไม่ใช่การรับรองความแม่นยำหรือประสิทธิภาพจากการทดลองครบชุด [1][4][5]

## 10.2 ข้อจำกัดของโครงงาน

- ผลทดสอบเชิงปริมาณและผลทดสอบผู้ใช้ยังไม่ครบ จึงไม่ควรอ้างความแม่นยำหรือความหน่วงของระบบ
- ค่ากายภาพจาก ADC บางรายการอาศัย gain และสเกลสมมติ ต้องสอบเทียบกับอุปกรณ์จริง
- การอ่านข้อมูลจากกล้องขึ้นอยู่กับแสง มุมกล้อง และการมองเห็นข้อต่อ
- สถานะ telemetry ฝั่ง SvelteKit เป็นชุดอุปกรณ์ร่วมหนึ่งชุด ไม่เหมาะกับหลาย rig พร้อมกันโดยไม่มีการแยกสถานะ
- หน้าวิเคราะห์บางส่วนมีข้อมูลตัวอย่าง และเอกสารพิน UART บางจุดยังไม่ตรงกับเฟิร์มแวร์ปัจจุบัน

## 10.3 แนวทางพัฒนาต่อ

ลำดับแรกควรทำแผนทดสอบบทที่ 8 ให้เสร็จ โดยมีผู้สังเกตการณ์นับครั้งอ้างอิง วัดความหน่วงปลายทาง เปรียบเทียบค่ากับเครื่องมือมาตรฐาน และบันทึกกรณีแสง/ท่าทางที่ทำให้ผลคลาดเคลื่อน จากนั้นจึงปรับเกณฑ์ตรวจท่าและสูตรแปลงเซนเซอร์จากข้อมูลวัดจริง

ด้านซอฟต์แวร์ควรแยกสถานะตาม rig/ผู้ใช้ กำหนดนโยบายข้อมูลสาธิตให้ชัด เพิ่มการทดสอบ API และการใช้งานข้ามเบราว์เซอร์ รวมทั้งตรวจการนำไฟล์ DOCX/CSV/JSON ไปใช้งานต่อ ด้านฮาร์ดแวร์ควรแก้เอกสารพิน UART ให้ตรงกับโค้ดและทดสอบการทำงานต่อเนื่องหลังประกอบวงจรจริง

# เอกสารอ้างอิง

[1] โครงงาน Cyberpump. README.md และโครงสร้าง repository, ตรวจสอบ 25 กันยายน 2569.

[2] โครงงาน Cyberpump. test-sensor/README.md และ test-sensor/platformio.ini, ตรวจสอบ 25 กันยายน 2569.

[3] โครงงาน Cyberpump. docs/firmware_rtos_power.md และเฟิร์มแวร์ ESP32/Uno, ตรวจสอบ 25 กันยายน 2569.

[4] โครงงาน Cyberpump. frontend/src/lib/server/telemetryStore.ts และ API telemetry ของ SvelteKit, ตรวจสอบ 25 กันยายน 2569.

[5] โครงงาน Cyberpump. frontend/src/lib/workout/ และคอมโพเนนต์แดชบอร์ด, ตรวจสอบ 25 กันยายน 2569.

[6] โครงงาน Cyberpump. docs/opencv_motion_rep_counter.md และ cameraRepCounter.svelte.ts, ตรวจสอบ 25 กันยายน 2569.

[7] โครงงาน Cyberpump. backend/app/routers/calibration.py และ frontend/src/lib/workout/calibration.svelte.ts, ตรวจสอบ 25 กันยายน 2569.

[8] โครงงาน Cyberpump. backend/app/routers/sessions.py และ backend/app/models/session.py, ตรวจสอบ 25 กันยายน 2569.

[9] โครงงาน Cyberpump. backend/README.md และ backend/app/routers/auth.py, ตรวจสอบ 25 กันยายน 2569.

[10] โครงงาน Cyberpump. backend/app/db.py และ backend/app/routers/telemetry.py, ตรวจสอบ 25 กันยายน 2569.

[11] Svelte. Documentation. https://svelte.dev/docs (เข้าถึง 25 กันยายน 2569).

[12] FastAPI. Tutorial – User Guide. https://fastapi.tiangolo.com/tutorial/ (เข้าถึง 25 กันยายน 2569).

[13] Google for Developers. Pose landmark detection guide. https://developers.google.com/edge/mediapipe/solutions/vision/pose_landmarker (เข้าถึง 25 กันยายน 2569).

[14] Espressif Systems. FreeRTOS Overview, ESP-IDF Programming Guide. https://docs.espressif.com/projects/esp-idf/en/stable/esp32/api-reference/system/freertos.html (เข้าถึง 25 กันยายน 2569).

[15] โครงงาน Cyberpump. TROUBLESHOOTING.md และ PINS.md, ตรวจสอบ 25 กันยายน 2569.

[16] โครงงาน Cyberpump. frontend/src/routes/(auth)/dashboard/+page.server.ts, ตรวจสอบ 25 กันยายน 2569.

# ภาคผนวก

## ภาคผนวก ก: ขั้นตอนเริ่มระบบในเครื่องพัฒนา

- เริ่ม MongoDB ด้วย Docker Compose ในโฟลเดอร์ backend
- ตั้งค่า backend/.env จาก .env.example และเริ่ม FastAPI ที่พอร์ต 9000
- ตั้งค่า frontend/.env จาก .env.example แล้วเริ่มเว็บ SvelteKit ที่พอร์ต 5173
- เชื่อม ESP32 กับ Wi-Fi และตั้ง endpoint ให้ส่งไป /api/telemetry ของเว็บ
- ตรวจสถานะเซนเซอร์ เปิดกล้อง และปรับเทียบก่อนเริ่มเซต

ขั้นตอนและค่าพอร์ตข้างต้นอ้างจาก README ของโครงงาน; ค่าความลับใน .env ต้องกำหนดให้เหมาะกับสภาพแวดล้อมใช้งานจริง [1][9]

## ภาคผนวก ข: ตัวอย่างโครงข้อมูลที่ระบบใช้

ตารางภาคผนวก ข.1 ตัวอย่างโครงข้อมูล

รายการ | ตัวอย่างเชิงโครงสร้าง | หมายเหตุ
Telemetry packet | emg, fsr, mpu, vitals, buttons, timestamp | ฟิลด์มีได้บางส่วนตามเซนเซอร์ที่ส่ง
ผลเซต | setNumber, exercise, totalReps, cleanReps, reps[] | บันทึกภายใต้ user_id และ session_id
Calibration | emgBaseline, emgMvc, fsrZero, fsrMax | เก็บต่อผู้ใช้ใน MongoDB
ไฟล์ส่งออก | CSV หรือ JSON ของ RecordingSample | สร้างในเบราว์เซอร์เมื่อมีตัวอย่าง

## ภาคผนวก ค: หลักฐานเพิ่มเติมที่ควรแนบหลังทดสอบ

แบบบันทึกการปรับเทียบ รายการอุปกรณ์และรุ่น firmware ภาพการต่อวงจร ภาพหน้าจอขณะใช้งาน log จาก I2C scanner/UART ตารางนับครั้งอ้างอิง และชุดข้อมูลส่งออกที่ลบข้อมูลส่วนบุคคลแล้ว
