Fishcanwalk/muscle-activity-analyzer/report/03-table-of-contents.md

# สารบัญ

สารบัญฉบับแก้ไขได้อยู่ที่ [`report/README.md`](README.md) โดยแบ่งไฟล์ตามลำดับใน [`structure.md`](structure.md)

เมื่อรวมไฟล์เป็นเอกสารฉบับพิมพ์ ให้สร้างเลขหน้าใหม่หลังจัดรูปแบบเสร็จ เนื่องจาก Markdown ไม่มีเลขหน้าคงที่

ลำดับหัวข้อหลัก:

1. ส่วนต้น
2. บทที่ 1 บทนำ
3. บทที่ 2 การออกแบบระบบ
4. บทที่ 3 การพัฒนา
5. บทที่ 4 ข้อมูลจากเซนเซอร์
6. บทที่ 5 การจัดเก็บข้อมูลและการนำไปใช้
7. บทที่ 6 โครงสร้างและการทำงานของโค้ด
8. บทที่ 7 การทดสอบและผลลัพธ์
9. บทที่ 8 ปัญหาที่พบและวิธีแก้ไข
10. บทที่ 9 สรุปและแนวทางพัฒนา
11. เอกสารอ้างอิงและภาคผนวก
