Fishcanwalk/muscle-activity-analyzer/report/nre-cost-analysis.md

# การวิเคราะห์ต้นทุน NRE (Non-Recurring Engineering Cost) และรายละเอียดการคำนวณ

> **หมายเหตุ:** ราคาอุปกรณ์ในหัวข้อ 3 เป็น **ราคาจริงตามใบเสร็จ** ส่วนจำนวนชั่วโมงแรงงานในหัวข้อ 2 เป็น **ค่าประมาณตามปริมาณงานจริงที่พัฒนา** (อ้างอิงจากประวัติ commit ของโปรเจกต์ ระหว่าง 6–28 กันยายน 2569 รวม 89 commits ใน 23 วัน) และอัตราค่าแรง 250 บาท/ชม. เป็นอัตราสมมติฐานสำหรับสาธิตวิธีคำนวณต้นทุนแบบวิศวกรรม

## 1. นิยามและขอบเขต

**NRE (Non-Recurring Engineering Cost)** คือต้นทุนที่เกิดขึ้น "ครั้งเดียว" ในกระบวนการออกแบบและพัฒนาผลิตภัณฑ์ ไม่ขึ้นกับจำนวนหน่วยที่ผลิต ประกอบด้วยค่าแรงงานวิศวกรรม (ออกแบบระบบ พัฒนาเฟิร์มแวร์/ซอฟต์แวร์ ทดสอบ จัดทำเอกสาร) และต้นทุนเครื่องมือ/เครื่องมือพัฒนาที่ใช้ครั้งเดียว

ตรงข้ามกับ NRE คือ **Recurring Cost (ต้นทุนต่อหน่วย)** ซึ่งเป็นต้นทุนที่เกิดซ้ำทุกครั้งที่สร้างอุปกรณ์เพิ่มอีก 1 ชุด ได้แก่ค่าชิ้นส่วนอุปกรณ์ (BOM) และแรงงานประกอบ

โครงสร้างต้นทุนรวมของโครงงานจึงเขียนเป็นสมการได้ว่า

```
Total Cost (N หน่วย) = NRE + (Unit Cost × N)
```

โดยที่ `N` คือจำนวนอุปกรณ์ที่ต้องการผลิต และ `Unit Cost` คือต้นทุนต่อหน่วยจาก BOM (หัวข้อ 3)

---

## 2. ต้นทุนแรงงานวิศวกรรม (Engineering Labor — ส่วนหลักของ NRE)

แบ่งงานตามเฟสการพัฒนาจริงของโปรเจกต์ (ระบบเซนเซอร์ + เฟิร์มแวร์ ESP32/Arduino Uno + Backend FastAPI + Frontend SvelteKit + การทดสอบ + เอกสาร)

| | ชั่วโมง | รายละเอียดงานที่นับรวม |
|---|---:|---|
| วิเคราะห์ระบบและออกแบบสถาปัตยกรรมของโครงงาน | 5 | กำหนดสถาปัตยกรรม ESP32 ↔ Uno ↔ Web ↔ Backend, ออกแบบ data flow, เลือกเซนเซอร์ |
| ออกแบบวงจรและประกอบฮาร์ดแวร์ต้นแบบ | 15 | ต่อวงจร I2C/ADC/UART, voltage divider, ปุ่มกด, LCD, บัซเซอร์ |
| พัฒนาเฟิร์มแวร์ Arduino Uno | 2 | อ่าน sEMG/FSR ผ่าน Timer1 CTC + ADC interrupt, watchdog, sleep mode |
| พัฒนาเฟิร์มแวร์ ESP32 | 30 | รวมเซนเซอร์ 6 ตัว, Wi-Fi, รีแฟกเตอร์เป็น FreeRTOS 4 tasks, GPIO interrupt, hardware timer, watchdog, light sleep และ EMG ส่งเป็น WebSocket ส่วนที่เหลือเป็น HTTP |
| พัฒนา Backend (FastAPI + MongoDB) | 10 | auth/JWT, telemetry ingestion, session_results, calibration, TTL index, ข้อมูลทดสอบ |
| พัฒนา Frontend (SvelteKit) | 35 | Dashboard เรียลไทม์, Live Studio, MediaPipe Pose rep counter, OpenCV.js motion cross-check, per-user session flow, WebSocket/SSE client |
| จัดทำเอกสารและรายงาน | 20 | รายงานฉบับนี้ |
| **รวมทั้งหมด** | **117** | |

**อัตราค่าแรงงานที่ใช้คำนวณ:** 150 บาท/ชั่วโมง เทียบเท่าอัตราวิศวกรซอฟต์แวร์/เฟิร์มแวร์ระดับเริ่มต้น

```
ต้นทุนแรงงาน = จำนวนชั่วโมงรวม × อัตราค่าแรงงานต่อชั่วโมง
            = 117 ชม. × 150 บาท/ชม.
            = 17,550 บาท
```

---

## 3. ต้นทุนอุปกรณ์ฮาร์ดแวร์ต้นแบบ (Prototype BOM — Bill of Materials)

รายการอุปกรณ์ทั้งหมดที่ใช้ประกอบต้นแบบ 1 ชุด (ราคาจริงตามใบเสร็จ) อ้างอิงจาก [`PINS.md`](../PINS.md) และ [`test-sensor/README.md`](../test-sensor/README.md)

| # | รายการ | จำนวนโดยประมาณ | หน้าที่ | ราคา (บาท) |
|---|---|---:|---|---:|
| 1 | บอร์ด ESP32 | 1 ชิ้น | อ่านเซนเซอร์ I2C, รับ UART, ประมวลผล และส่งข้อมูลผ่าน Wi-Fi | 32 |
| 2 | Arduino Uno | 1 ชิ้น | อ่าน sEMG และ FSR ด้วย ADC แล้วส่งข้อมูลให้ ESP32 | 235 |
| 3 | เซนเซอร์ sEMG | 1 ชิ้น | วัดสัญญาณไฟฟ้าจากกล้ามเนื้อเพื่อประเมินความเข้มข้นการออกแรง | 32 |
| 4 | เซนเซอร์ FSR-402 | 1 ชิ้น | วัดแรงกดหรือแรงกำ | 129 |
| 5 | MPU6050 | 1 ชิ้น | วัดการเคลื่อนไหว มุม | 49 |
| 6 | MAX30102 | 1 ชิ้น | อ่านชีพจรและใช้คำนวณค่า SpO₂ โดยค่าที่ได้เป็นค่าประมาณ | 32 |
| 7 | MLX90614 | 1 ชิ้น | วัดอุณหภูมิแบบไม่สัมผัส/อุณหภูมิผิว | 32 |
| 8 | DD39AJPA | 1 ชิ้น | สำหรับจ่ายไฟลบให้ sEMG | 83 |
| 9 | ECG Electrodes | 50 แผ่น | ใช้กับ EMG วัดสัญญาณไฟฟ้าจากกล้ามเนื้อ | 97 |
| 10 | LCD 16x2 | 1 ชิ้น | แสดงจำนวนครั้ง ความเร็ว และชีพจรบนอุปกรณ์ | 75 |
| 11 | Active buzzer | 1 ชิ้น | แจ้งเตือนเมื่อแรงกำต่ำหรือแรงกำไม่นิ่งระหว่างเซต | 5 |
| 12 | ปุ่มกด | 2 ชิ้น | กดเพื่อเริ่มและหยุดการออกลงกาย | 12 |
| 13 | ตัวต้านทาน 1 kΩ และ 2.2 kΩ | 1 ชิ้น | ใช้เพื่อทำลดแรงดันสาย TX ที่เข้าสู่ ESP32 | 2 |
| 14 | ตัวต้านทาน 10 kΩ | 2 ชิ้น | Pull-up ของปุ่ม | 2 |
| 15 | สาย 24 AWG | 30 เมตร | สายไฟ | 214 |
| 16 | สาย jumper | 30 เส้น | สายไฟ | 30 |
| 17 | Terminal 8x1 pin | 2 ชิ้น | ใช้รวมสัญญาณ I2C | 30 |
| 18 | กล่องอเนกประสงค์สีดำ | 1 กล่อง | กล่อง | 55 |
| 19 | ตู้กันน้ำพลาสติกฝาใส 6\*8 | 1 ตู้ | กล่อง | 125 |
| 20 | เทปตีนตุ๊กแก | 1 เมตร | เทป | 8 |
| 21 | สาย USB Type C to Type C | 1 ชิ้น | สายจ่ายไฟสำหรับ ESP32 | 70 |
| 22 | สาย USB Type A to Jack DC 5 V | 1 ชิ้น | สายจ่ายไฟสำหรับ Arduino Uno | 20 |
| 23 | แหล่งจ่าย | 1 ชิ้น | จ่ายไฟให้ ESP32, Arduino Uno | 200 |
| 24 | ถุงเท้า (Armband) | 1 คู่ | สำหรับสวมยึดเซนเซอร์ที่แขน | 39 |
| **รวม BOM ต่อ 1 ชุด** | | | **1,608** |

---

## 4. ต้นทุนเครื่องมือและซอฟต์แวร์ (Tooling & Software)

เครื่องมือพัฒนาทั้งหมดที่ใช้ในโปรเจกต์นี้เป็นซอฟต์แวร์โอเพนซอร์สหรือให้ใช้งานฟรี จึงมีต้นทุนเป็น 0 บาท:

| เครื่องมือ | หน้าที่ | ต้นทุน (บาท) |
|---|---|---:|
| VS Code, PlatformIO, Arduino IDE | พัฒนา/คอมไพล์เฟิร์มแวร์ | 0 |
| Python 3.11 + Poetry, FastAPI | พัฒนา Backend | 0 |
| Node.js + npm/pnpm, SvelteKit | พัฒนา Frontend | 0 |
| MongoDB Community Edition, Docker | ฐานข้อมูลและ containerization | 0 |
| MediaPipe Pose, OpenCV.js | ตรวจจับท่าทาง/นับครั้งจากกล้อง | 0 |
| **รวมต้นทุนเครื่องมือ** | | **0** |

> หากนำระบบขึ้นให้บริการจริงตาม [`DEPLOYMENT.md`](../DEPLOYMENT.md) (เช่น เช่าโดเมนหรือ VPS/Cloud) ต้นทุนส่วนนี้จัดเป็น **ต้นทุนดำเนินการ (Operating Cost)** แบบรายปี/รายเดือน ไม่ใช่ NRE เนื่องจากเกิดซ้ำตามรอบเวลา ไม่ใช่ครั้งเดียวตอนพัฒนา — จึงไม่รวมไว้ในการคำนวณ NRE ของเอกสารนี้

---

## 5. สรุปต้นทุน NRE รวม

```
NRE รวม = ต้นทุนแรงงานวิศวกรรม + ต้นทุนเครื่องมือ/ซอฟต์แวร์
        = 17,550 + 0
        = 17,550 บาท
```

| รายการ | มูลค่า (บาท) | สัดส่วน |
|---|---:|---:|
| ต้นทุนแรงงานวิศวกรรม (หัวข้อ 2) | 17,550 | 100.0% |
| ต้นทุนเครื่องมือ/ซอฟต์แวร์ (หัวข้อ 4) | 0 | 0.0% |
| **NRE รวม** | **17,550** | **100.0%** |

---

## 6. ต้นทุนรวมของต้นแบบ 1 ชุด (Total Prototype Cost)

```
Total Prototype Cost = NRE + Unit Cost (BOM 1 ชุด)
                      = 17,550 + 1,608
                      = 19,158 บาท
```

---

## 7. การเฉลี่ยต้นทุน NRE ต่อหน่วยเมื่อผลิตหลายชุด (Amortized Cost)

เมื่อ NRE เกิดขึ้นเพียงครั้งเดียว หากผลิตอุปกรณ์เพิ่มหลายชุด ต้นทุน NRE จะถูก "เฉลี่ย" ไปตามจำนวนหน่วยที่ผลิต (`N`) ทำให้ต้นทุนเฉลี่ยต่อชุดลดลงตามหลัก **Economies of Scale**

```
Amortized Cost per Unit(N) = (NRE / N) + Unit Cost (BOM)
```

| จำนวนที่ผลิต (N) | NRE เฉลี่ย/ชุด (บาท) | BOM/ชุด (บาท) | ต้นทุนเฉลี่ย/ชุด (บาท) |
|---:|---:|---:|---:|
| 1 | 17,550.00 | 1,608 | 19,158.00 |
| 5 | 3,510.00 | 1,608 | 5,118.00 |
| 10 | 1,755.00 | 1,608 | 3,363.00 |
| 20 | 877.50 | 1,608 | 2,485.50 |
| 50 | 351.00 | 1,608 | 1,959.00 |
| 100 | 175.50 | 1,608 | 1,783.50 |

**ข้อสังเกต:** ต้นทุนเฉลี่ยต่อชุดลู่เข้าใกล้ต้นทุน BOM (1,608 บาท) เมื่อจำนวนการผลิตเพิ่มขึ้นมาก เนื่องจาก NRE เป็นต้นทุนคงที่ (Fixed Cost) ที่ไม่ขึ้นกับปริมาณการผลิต ในขณะที่ BOM เป็นต้นทุนผันแปร (Variable Cost) ที่คูณตามจำนวนหน่วยเสมอ

---

## 8. สรุปสูตรคำนวณทั้งหมด

| สูตร | ความหมาย |
|---|---|
| `ต้นทุนแรงงาน = Σ(ชั่วโมงต่อกิจกรรม) × อัตราค่าแรง/ชม.` | รวมชั่วโมงทำงานทุกเฟส คูณอัตราค่าแรง |
| `NRE = ต้นทุนแรงงาน + ต้นทุนเครื่องมือ` | ต้นทุนครั้งเดียวทั้งหมดของการพัฒนา |
| `Unit Cost = Σ(ราคาต่อหน่วย × จำนวน)` ของทุกชิ้นส่วนใน BOM | ต้นทุนอุปกรณ์ต่อ 1 ชุด |
| `Total Cost(N) = NRE + (Unit Cost × N)` | ต้นทุนรวมเมื่อผลิต N ชุด |
| `Amortized Cost per Unit(N) = (NRE / N) + Unit Cost` | ต้นทุนเฉลี่ยต่อชุดเมื่อผลิต N ชุด |

---

## 9. แหล่งข้อมูลอ้างอิง

- รายการอุปกรณ์และการต่อพิน: [`PINS.md`](../PINS.md), [`test-sensor/README.md`](../test-sensor/README.md)
- ขอบเขตงานพัฒนาและฟีเจอร์: [`README.md`](../README.md), [`docs/firmware_rtos_power.md`](../docs/firmware_rtos_power.md), [`docs/emg_websocket_migration.md`](../docs/emg_websocket_migration.md), [`docs/system_overview.md`](../docs/system_overview.md)
- ระยะเวลาและปริมาณงานจริง: ประวัติ commit ของ repository (`git log`, 6–28 กันยายน 2569, 89 commits)
