Fishcanwalk/muscle-activity-analyzer/docs/sensor_usage.md

Searched for files: *
Viewed README.md:1-220
Viewed agent-role.md:1-71
Viewed BiofeedbackSensors.svelte:1-117
Viewed telemetryStore.ts:1-100

จากโครงสร้างระบบและไฟล์ Telemetry (`telemetryStore.ts`, `BiofeedbackSensors.svelte`) ในโปรเจกต์ **CyberPump** เซนเซอร์ทั้ง 6 ตัวที่คุณมีอยู่ ถูกออกแบบให้ทำงานประสานกัน (Sensor Fusion) โดยแบ่งหน้าที่ในแต่ละมิติดังนี้ครับ:

---

### ตารางสรุปภาพรวมหน้าที่ของเซนเซอร์แต่ละตัว

| เซนเซอร์ | แหล่งที่มา / บอร์ด | ตัวแปรที่วัดได้ | หน้าที่หลักในระบบ CyberPump |
| :--- | :--- | :--- | :--- |
| **1. Camera (MediaPipe)** | กล้อง Web/มือถือ | พิกัด 3D ข้อต่อ, มุมข้อศอก ($\theta$), การเอียงตัว | **แกนนับ Rep + จับโกง (Anti-Cheat Engine)** |
| **2. sEMG Sensor** | ต่อบอร์ด (ขา A0) | คลื่นไฟฟ้า $\mu\text{V}$, RMS, Peak, %MVC | **ยืนยันการเกร็งกล้ามเนื้อจริง + สะสมเวลา TUT** |
| **3. MPU-6050 (IMU)** | ESP32 (I2C) | ความเร่ง, ความเร็วแนวดิ่ง ($v$), มุมเอียงบาร์ | **Velocity-Based Training (VBT) + เช็กความสมดุลบาร์** |
| **4. FSR A2 (Pressure)** | Arduino Uno (A2) | แรงบีบด้ามจับ (N), ความนิ่งของแรงกด (%) | **เช็ก Grip Fatigue + ป้องกันเวทหลุดมือ + CNS Readiness** |
| **5. MAX30102** | ESP32 (I2C) | อัตราการเต้นหัวใจ (BPM), ออกซิเจนในเลือด ($\text{SpO}_2$) | **วัดความเหนื่อยรวม + คำนวณเวลาพักระหว่างเซ็ต (Rest Time)** |
| **6. MLX90614 (IR)** | ESP32 / Uno | อุณหภูมิผิวหนังของมัดกล้ามเนื้อ ($^\circ\text{C}$), $\Delta\text{Temp}$ | **วัดการสูบฉีดเลือดของกล้ามเนื้อ (Muscle Pump / Hyperemia)** |

---

### รายละเอียดเจาะลึก: เซนเซอร์แต่ละตัวทำอะไรในงานนี้ได้บ้าง?

#### 1. กล้อง (MediaPipe BlazePose 33 Landmarks)
* **ทำหน้าที่:** เป็น **ตัวตัดสินการนับ Rep หลัก (Master Rep Counter)**
* **วิธีใช้งานในระบบ:**
  * คำนวณมุมข้อศอก $\theta_{\text{elbow}}$ เพื่อเดินรอบ Finite State Machine:
    * `START` ($\ge 140^\circ$) $\to$ `INFLECTION` $\to$ `PEAK` ($\le 70^\circ$) $\to$ `COMPLETION` ($\ge 140^\circ$)
  * **ตรวจจับฟอร์มและท่าโกง (Anti-Cheat):**
    * วัดมุมลำตัว $\theta_{\text{torso}} > 8^\circ$ (โกงด้วยการเอนหลังเหวี่ยงตัว)
    * วัดการขยับของหัวไหล่ $\Delta y_{\text{shoulder}} > 3\text{ cm}$ (โกงด้วยการยักไหล่ช่วยดึง)

---

#### 2. sEMG Sensor (คลื่นไฟฟ้ากล้ามเนื้อ MyoWare / Grove)
* **ทำหน้าที่:** **ตรวจสอบสรีรวิทยา (Physiological Validator) & นับ Time Under Tension (TUT)**
* **วิธีใช้งานในระบบ:**
  * วัดกระแสไฟฟ้าที่เกิดจากการหดตัวของใยกล้ามเนื้อ Biceps โดยตรง
  * **กรอง Rep หลอก:** ถ้าร่างกายเหวี่ยงแขนขึ้นไปได้จนมุมงอ แต่ sEMG อ่านค่าได้ต่ำกว่า $250-280\,\mu\text{V}$ ระบบจะรู้ทันทีว่าใช้แรงเหวี่ยง ไม่ใช่กล้ามเนื้อออกแรง
  * **นับเวลา TUT (Time Under Tension):** นับเวลาเฉพาะตอนที่กล้ามเนื้อมีแรงต้านอยู่ใน High-Tension Zone ($\ge 280\,\mu\text{V}$ หรือ $\ge 45\%-50\%\text{ MVC}$) ซึ่งเป็นหัวใจสำคัญของการสร้างกล้ามเนื้อ (Hypertrophy)
  * **ตรวจจับความล้าลึก (Fatigue):** ตรวจดูการเลื่อนของค่าความถี่กลาง (Median Frequency) หากเริ่มล้า ความถี่จะลดต่ำลง

---

#### 3. MPU-6050 (6-Axis IMU: Accelerometer + Gyroscope)
* **ทำหน้าที่:** **ระบบ Velocity-Based Training (VBT) & ตรวจสอบคุณภาพความเร็ว**
* **วิธีใช้งานในระบบ:**
  * ติดไว้ที่แกนดัมเบล/บาร์เบล เพื่อคำนวณความเร็วช่วงยกขึ้น (Concentric Velocity: $\text{m/s}$)
  * บันทึกความเร็ว Rep แรก ($V_1$) แล้ววัด **Velocity Loss (%)**:
    * เมื่อความเร็วตกลงมาอยู่ในช่วง **$25\% - 40\%$** $\to$ ระบบจะแจ้งเตือนว่าเข้าสู่ **Effective Zone (ช่วงที่กระตุ้นกล้ามเนื้อได้ดีที่สุด)**
    * ถ้าความเร็วตก $> 40-50\%$ $\to$ แจ้งเตือนว่าล้าจนเกินขีดจำกัดแล้ว ควรหยุดเซ็ตเพื่อป้องกันบาดเจ็บ
  * ตรวจสอบ **Roll / Pitch** ของบาร์เบล ว่าผู้เล่นยกเวทเอียงหรือไม่ (Limb Imbalance)

---

#### 4. FSR A2 (Force Sensitive Resistor - เซนเซอร์วัดแรงกด)
* **ทำหน้าที่:** **ความปลอดภัย (Safety) & ประเมินระบบประสาทส่วนกลาง (CNS Readiness)**
* **วิธีใช้งานในระบบ:**
  * ติดไว้ที่ด้ามจับดัมเบล วัดแรงบีบมือ (Grip Force: $\text{N}$) และความนิ่ง (Grip Stability: $\%$)
  * **ระบบเตือนเวทหลุดมือ:** ถ้าแรงบีบลดลงกะทันหันในขณะที่กล้ามเนื้อยังเกร็งอยู่ ระบบจะส่งเสียงหรือสัญลักษณ์เตือนว่ากำลังจะหมดแรงกำ (Grip Failure)
  * **Readiness Test:** ให้ผู้ใช้บีบมือก่อนเริ่มออกกำลังกาย เพื่อดูว่าระบบประสาทและกล้ามเนื้อพร้อมฝึกหนักในวันนี้หรือไม่

---

#### 5. MAX30102 (Pulse Oximeter & Heart Rate)
* **ทำหน้าที่:** **วัดอัตราการเต้นหัวใจ & ควบคุมเวลาพักระหว่างเซ็ต (Rest Time)**
* **วิธีใช้งานในระบบ:**
  * วัด Heart Rate (BPM) และ $\text{SpO}_2$
  * **Smart Rest Timer:** ปกติเรามักจับเวลาพักแบบตายตัว (เช่น 90 วินาที) แต่เซนเซอร์นี้จะช่วยบอกได้ว่า **"พร้อมเล่นเซ็ตถัดไปจริงหรือยัง"** โดยดูจากตอนที่ Heart Rate ลดลงสู่ระดับพักผ่อน ($< 110-120\text{ BPM}$)
  * **Safety Threshold:** หาก HR ทะลุเกิน $85-90\%$ ของอัตราเต้นสูงสุด จะมี Alert เตือนให้ผ่อนแรงลง

---

#### 6. MLX90614 (Infrared Contactless Thermometer)
* **ทำหน้าที่:** **ตรวจวัดการสูบฉีดเลือดในกล้ามเนื้อ (Muscle Pump & Hyperemia)**
* **วิธีใช้งานในระบบ:**
  * วัดอุณหภูมิผิวของมัดกล้ามเนื้อโดยไม่ต้องสัมผัส
  * คำนวณ $\Delta\text{Temp}$ (ส่วนต่างอุณหภูมิเทียบกับก่อนเริ่มเซ็ต)
  * เมื่อกล้ามเนื้อทำงานหนัก เลือดจะไหลเวียนเข้าสู่เส้นเลือดฝอยในมัดกล้ามเนื้อปริมาณมหาศาล (Vasodilation) ส่งผลให้อุณหภูมิผิวหนังบริเวณนั้นสูงขึ้น ($+0.5^\circ\text{C}$ ถึง $+1.5^\circ\text{C}$) แสดงถึงภาวะ "Muscle Pump" ที่สมบูรณ์

---

### การผสานพลังรวมกัน (The Complete CyberPump Pipeline)
เมื่อนำทุกตัวมารวมกัน โปรเจกต์นี้จะกลายเป็น **Smart Biomechanical Lab**:
1. **กล้อง** ตรวจดูมุมข้อต่อและการโกงฟอร์ม
2. **sEMG** ยืนยันว่ากล้ามเนื้อทำงานจริง พร้อมจับเวลา TUT
3. **MPU-6050** คอยบอกว่าควรหยุดเซ็ตที่กี่ครั้งจากความเร็วตก (VBT)
4. **FSR** คอยคุมแรงบีบและเตือนความปลอดภัย
5. **MAX30102 + MLX90614** ดูแลระบบหัวใจและตรวจสอบการปั๊มของกล้ามเนื้อแบบครบวงจร
