Fishcanwalk/muscle-activity-analyzer/(commit log)

2026-09-06 feat: init test sensor module
2026-09-06 refactor: test sensor module
2026-09-11 Remove backend application code and configuration files
    - Deleted the .env.example file, Dockerfile, and run.py script.
    - Removed application initialization, configuration, and extension files.
    - Eliminated all model definitions and service implementations related to patients, sessions, and telemetry.
    - Cleared out all route definitions for API endpoints.
    - Removed seed data generation script and associated files.
    - Deleted the telemetry simulation script and Docker Compose configuration.
2026-09-11 feat: add cross-platform board configuration and initial EMG sensor plotter implementation
2026-09-12 refactor: update ESP32 WiFi configuration network and add .gitignore
2026-09-12 feat: convert raw ADC counts to microvolts and Newtons in telemetry store
2026-09-12 feat: add MPU acceleration axes and multi-sensor telemetry support to ESP32 firmware and store
2026-09-15 feat: synchronize calibration with server, add SSE reconnection, and standardize EMG buffer size
2026-09-18 feat: add ESP32 physical button telemetry event streaming and remote workout control
2026-09-19 feat: add LCD support to I2C scanner and introduce full sensor debug sketch
2026-09-19 feat: track peak heart rate, format CSV timestamps, and implement ESP32 local set timer and HTTP connection reuse
2026-09-20 feat: buzzer on project for compare with fsr
    [esp32_connectToWifi_buttons.cpp]
2026-09-20 feat: add FSR stability buzzer alerts and update default workout firmware target
    [09_full_sensor_debug.ino, esp32_workout_firmware.cpp]
2026-09-20 docs: update test-sensor README
2026-09-21 feat: offload EMG and FSR sensor data collection to Arduino Uno via UART
2026-09-21 refactor: replace mock user profiles with server-side session management and add calibration and recording endpoints
    [esp32_workout_firmware.ino]
2026-09-22 feat: convert grip force to kgf, update EMG metrics to MVC percentage, and improve calibration sync
2026-09-23 feat: add OpenCV.js camera motion rep counter and RTOS firmware power management
2026-09-23 fix: update data flow diagram in README for clarity and accuracy
2026-09-23 feat: add support for ESP32 Arduino watchdog and hardware timer APIs
2026-09-25 feat(backend): add EMG rep thresholds and repSource fields
    Calibration now stores per-user thresholds for counting reps from the
    sEMG envelope (emgRepOnPct / emgRepOffPct / emgRepPeakPct, all % of the
    calibrated MVC). Session results record how their reps were counted
    (repSource: camera | emg | hybrid). All new fields are optional with
    defaults, so existing documents still load.
2026-09-25 feat(frontend): count reps from the sEMG envelope on the server
    - Treat the EMG module's SIG output as an envelope that sits near 0 at
    rest, instead of an AC signal biased at mid-scale; the old conversion
    reported high tension while the muscle was relaxed.
    - Smooth samples into a 100 ms envelope and run a hysteresis state
    machine (emgRepDetector.ts) on every 100 Hz sample. Each counted rep
    is broadcast as an `emgRep` SSE event.
    - Derive "high tension" from % of calibrated MVC, not a fixed 280 µV.
    - Expose the raw FSR ADC reading so calibration can capture it.
    - Accept the rep thresholds through /api/calibration and regenerate
    the OpenAPI types.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
2026-09-25 feat(frontend): real workout data, EMG/Hybrid rep modes and reliable set saving
    - Save each set as soon as it ends, and track saved sets by id: the old
    `saved` flag lived on a separate $state proxy, so ending a workout
    re-POSTed sets already saved by "next set".
    - Fall back when crypto.randomUUID is unavailable (plain http on a LAN IP).
    - Group sets into sessions by session_id (metrics.ts) for the dashboard
    and load Analytics from GET /v1/sessions instead of hardcoded data.
    - Calibration measures real sensor readings over a timed window and
    stores the EMG rep thresholds. Readiness shows "not tested" until a
    grip test runs, instead of placeholder scores.
    - Add a rep source (camera /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
2026-09-25 feat(frontend): rework the workout UI around the step-by-step flow
    - The header tabs are now a numbered stepper (Calibration → Readiness →
    Live Studio → Post-Set → Analytics) that ticks off completed steps.
    Each page gets a "next step" action, and the four hardware pills are
    merged into one status pill.
    - Live Studio puts rep count, set time, current % MVC and a plain-language
    phase in a large stats bar at the top. It adds the camera / EMG / Hybrid
    rep-source toggle and warns when the chosen source has no signal.
    Developer data (raw MPU axes, OpenCV cross-check, raw export) moves into
    a collapsible section, and the idle camera shrinks to one row in EMG mode.
    - The sEMG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
2026-09-25 feat(backend): add subscription plans with Omise billing
    Free keeps 30 days of history in GET /v1/sessions, Pro (฿199/month) keeps
    everything. BILLING_PROVIDER picks disabled, mock (dev, no charge) or omise,
    which charges the card token from omise.js, schedules the monthly renewal,
    handles 3-D Secure returns and verifies webhooks by re-fetching the event.
2026-09-25 feat(backend): compare a session with the user's previous one
    Sets now store the MVC calibrated for their session (emgMvcUv), since
    calibration is redone every session. GET /v1/sessions/{id}/comparison
    returns the session's sets and the same user's previous session, ignoring
    the plan's history window.
2026-09-25 feat(frontend): require a fresh calibration every session
    Each workout session now starts from the default calibration instead of
    loading the saved one. All four readings (EMG rest/MVC, FSR release/max)
    must be captured before a set can start, from the UI or the board button.
    Values survive a reload within the session (sessionStorage) and are reset,
    along with the server's copy, when the workout ends.
    Each set carries its session's MVC, so % MVC in history and the dashboard
    is computed per session instead of against the latest calibration.
2026-09-25 feat(frontend): add the subscription page
    /billing shows the Free and Pro plans and the current subscription, with
    upgrade (OmiseCard card form, then 3-D Secure if the bank asks), cancel and
    resume. Mock and disabled billing modes get a banner. Adds a shared
    AccountShell layout and plan links in the workout header and dashboard.
2026-09-25 docs: describe subscription plans and the Omise flow
2026-09-26 feat(calibration): add minimum EMG MVC threshold and update error handling
2026-09-26 feat(telemetry): add EMG level tracking and update calibration logic
2026-09-26 feat(backend): store pre-workout grip tests for the readiness check
    POST /v1/readiness/grip saves the peak grip (raw ADC counts above "no
    grip") and compares it with the median of the user's last 5 tests, so
    readiness is measured against the lifter's own normal grip instead of a
    fixed 50 kg. Telemetry also accepts gripPercent from the frontend.
2026-09-26 feat(server): grip as % of max squeeze and replies the board can act on
    - FSR grip is reported as % of the session's calibrated squeeze range
    instead of Newtons: the fixed 50 N full scale capped every grip at ~5 kg.
    - MPU telemetry is reduced to velocity plus the batch's peak velocity;
    angles and raw axes depend on how the board is strapped on.
    - Each reply to the board's telemetry POST now carries the FSR calibration
    (so the firmware can judge grip loss in %) and a one-shot buzzer test
    requested through POST /api/buzzer-test.
2026-09-26 feat(frontend): drop ROM from comparisons, analytics and the dashboard
    ROM came from the camera's elbow tracking, which is gone (the camera is
    now a plain preview), so new reps no longer have one. Session and user
    comparisons, the analytics trend chart and the dashboard stop showing it;
    the dashboard's "widest ROM" record becomes the fastest rep (m/s).
2026-09-26 feat(frontend): EMG-only reps, board-button controls and a one-screen Live Studio
    - Reps are counted and judged only from the sEMG (a rep that never reaches
    the "real effort" threshold is a cheat). The camera/EMG/Hybrid choice is
    gone, and the camera is a plain getUserMedia preview for watching form:
    MediaPipe, the OpenCV motion counter, cheat detection and the posture
    baseline are removed.
    - The board's buttons are the only set controls: A starts/stops a set (the
    session's first set only from step 2, Readiness) and B ends the workout,
    saving every set and loading the comparison with the previous session.
    The web start/stop/next-set/end buttons are replaced by A/B hints.
    - Each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
2026-09-26 feat(firmware): grip-loss buzzer in %, working MPU velocity and one press per push
    - Buttons: ControlTask waits 30 ms for the contacts to settle, re-reads the
    pin and accepts one press per push, so a long hold's release bounce no
    longer toggles a second set.
    - Buzzer: judged in % of the session's calibrated squeeze range, sent back
    in each telemetry reply (the FSR's "no grip" reading is ~1430, so the old
    raw threshold never fired). It beeps as soon as a held grip drops under
    60% of its level or 10% (for 200 ms), and still after 3 s of an unsteady
    grip. Driven HIGH/LOW for this rig's active buzzer (BUZZER_IS_ACTIVE),
    beeps twice at boot and three times on the web's buzzer test.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
    [esp32_workout_firmware.cpp, esp32_workout_firmware.ino]
2026-09-26 docs: explain how the board and the website work together
    Data flow between the Uno, the ESP32, the SvelteKit server, the browser and
    the backend, how reps are counted, a session walkthrough, the ESP32's
    FreeRTOS tasks and light sleep, the Uno's idle sleep, and the grip buzzer.
2026-09-27 Refactor report structure: Remove outdated sections and add new chapters on system design, development, sensor data, data storage, code structure, testing, troubleshooting, and summary with future di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
2026-09-27 fix(server): keep the telemetry SSE stream alive behind nginx
    With no board posting to the server the stream went silent, and nginx
    (proxy_read_timeout 60 s) cut it, so browsers kept reconnecting with
    ERR_INCOMPLETE_CHUNKED_ENCODING. Send a ": ping" comment every 15 s and
    X-Accel-Buffering: no so nginx neither times out nor buffers the stream.
2026-09-27 chore(firmware): strip comments and unused code from the Arduino sketch
    The .ino is now the final version: comments removed, plus the unused
    repCount field, the passive-buzzer tone() path and the ESP32 core 2.x
    fallbacks (it now fails to compile with a clear #error on core < 3). Also
    fixes the free-heap printf formats. The PlatformIO copy in src/ is unchanged.
    [esp32_workout_firmware.ino]
2026-09-27 refactor(report): update figures and tables, enhance sensor data descriptions, and improve report structure
2026-09-27 fix(vitals): track peak heart rate per set and ignore sensor spikes
    The peak never reset, so one motion-artifact reading stuck as the peak for
    every later set. It now resets at set start, only counts readings during a
    set, and must hold for 3 s. The firmware drops stale beats when the finger
    is lifted and waits for 4 fresh beats before reporting.
    [esp32_workout_firmware.ino]
2026-09-27 fix(dates): show workout dates and weeks in Thai time
    Mongo returned naive UTC datetimes, which browsers read as local time, and
    the dashboard bucketed days and weeks in UTC. The Motor client is now
    tz_aware, date helpers format in Asia/Bangkok, and weekly volume is labelled
    with its Monday-Sunday range.
2026-09-27 docs: add RTOS task scheduling overview for ESP32 firmware
2026-09-27 Update watchdog timeout settings in firmware documentation and code
    - Increased ESP32 watchdog timeout from 5 seconds to 8 seconds in FIRMWARE_REPORT.md.
    - Updated code explanation to reflect the new watchdog timeout in code-explanation.md.
    - Enhanced descriptions of task management and power-saving features in chapter-06.md.
2026-09-27 refactor: clean up Arduino sensor link code and remove inline comments
2026-09-27 refactor: streamline EMG data handling between SensorTask and NetworkTask
2026-09-28 Refactor telemetry and EMG data handling in ESP32 firmware
    - Updated firmware to utilize WebSocket for EMG data transmission every 20 ms, improving real-time data handling.
    - Adjusted HTTP POST intervals for telemetry data to every 100 ms, optimizing network usage.
    - Enhanced software architecture by separating EMG streaming and telemetry tasks, ensuring non-blocking sensor readings.
    - Revised flowcharts to reflect changes in data flow and task management.
    - Updated documentation to include WebSocket integration and its impact on system performance.
2026-09-28 docs: update flowchart diagram in report
2026-09-28 fix: correct I2C address for LCD and improve MLX90614 initialization with retry logic
    [01_i2c_scanner.ino, 06_mlx90614_test.ino, 10_mlx90614_address_fix.ino, board_config.h, esp32_workout_firmware.ino]
2026-09-28 feat(dashboard): filter and paginate session history, add a progress chart
    The history list now shows every session (was the latest 30), filtered by
    exercise and date range and paged 8 at a time. A single-series progress chart
    above it follows the same filters, with a switch between clean volume, clean
    reps, form purity and peak muscle effort.
2026-09-28 fix(workout): record high-tension TUT, per-rep velocity and board timeout
    - TUT: incrementTut() was never called and rounded every 0.02 s step away.
    The server now counts EMG samples above the "real effort" threshold and
    sends highTensionMs with each WebSocket frame; the client adds it up while a
    set runs and rounds once in the set summary.
    - Rep velocity: rep events arrive over the WebSocket within ~50 ms while
    velocity came over POST + SSE 200-300 ms later, so reps were often matched
    with no velocity (0 m/s). The firmware now appends its peak velocity to each
    EMG frame ("2048,2051|0.420") and the rep detector attaches the peak seen
    during the contraction. Frames without it fa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
    [esp32_workout_firmware.ino]
2026-09-28 docs: mark TUT, rep velocity and device status issues as fixed
